andriy-bilynskyy/sdr-trx/calculations/README.md

# Calculations

This folder contains calculations and considerations needed for HW/SW design implementation.
Preferably documents are in LibreOffice format.

## Components
- **band-split.odt** - considerations about splitting HF band into sub-bands in order to filtration harmonics produced by modulation/demodulation process.
- **band-split.ods** - actual calculations  of previous item.
- **power.ods** - simple calculation of main RF variables.
- **swr-meter.ods** - RF Power Detector LTC5507 calculator. Estimate output power using SWR meter (Polynomial calculator Pout=f(Vdet)).
