andriy-bilynskyy/sdr-trx/calculations/band-split.odt

# Band splitting in DCR transceivers.

In DCR transceiver we multiply sound frequencies by carrier frequency. As result we have these sound spectrum near carrier frequency (LSB or USB). But the problem is that really we have a bunch of this frequencies near carrier harmonics (Fc, 2Fc, 3Fc, …) due to non linear modulator/demodulator operations. To suppress that parasitic transmitting/receiving channel we should use band pass filters.

For example we need to cover all shortwave bands 1.8MHz – 30MHz. So the lower carries is 1.8MHz that means that we have second harmonic at 3.6MHz. As result we can’t use just one filter we should use few of them and switch them according to carrier.

### So lets decide the right way to split band. The input data is the next:

FL – Lowest band frequency.

FH – Highest band frequency.

N – Count of sub-bands after split main one(FL … FH).

### Additional considerations

We are going to use the same filters type and order for all sub-bands. That means that each filter has the same bandwidth to center frequency ratio.

A = BW over F

### The calculations

Lets have half bandwidth ratio %alpha = A over 2 = BW over "2 F" which are the same for all filters.

So For the fest band center frequency

F sub L = F sub 1 - %alpha F sub 1 or F sub L = (1 - %alpha) F sub 1
so F sub 1 = F sub L over (1 - %alpha)

Second one

F sub 1 + %alpha F sub 1 = F sub 2 - %alpha F sub 2 or (1 + %alpha) F sub 1 = (1 - %alpha) F sub 2

Third

F sub 1 + %alpha F sub 1 = F sub 2 - %alpha F sub 2 or (1 + %alpha) F sub 1 = (1 - %alpha) F sub 2

Now it’s clear that for some middle X band we have the next

F sub "X-1" + %alpha F sub "X-1" = F sub X - %alpha F sub X or (1 + %alpha) F sub "X-1" = (1 - %alpha) F sub X so F sub X = (1 + %alpha) over (1 - %alpha) F sub "X-1"

And finally the last band

F sub H = F sub N + %alpha F sub N or F sub H = (1 + %alpha) F sub N

Now lets try to estimate half bandwidth ratio. As we said BW = 2 %alpha F

All sub-bands should cover all main band

2 %alpha F sub 1 + 2 %alpha F sub 2 + 2 %alpha F sub 3 + ... + 2 %alpha F sub N = F sub H - F sub L

2 %alpha ( F sub 1 + F sub 2 + F sub 3 +... + F sub N ) = F sub H - F sub L

But we already know how to calculate next frequency from previous . So

2 %alpha ( F sub 1 + F sub 1 ({1 + %alpha} over {1 - %alpha}) + F sub 1 ({1 + %alpha} over {1 - %alpha}) sup 2 + ... + F sub 1 ({1 + %alpha} over {1 - %alpha}) sup {N - 1} ) = F sub H - F sub L

2 %alpha F sub 1 ( 1 + ({1 + %alpha} over {1 - %alpha}) + ({1 + %alpha} over {1 - %alpha}) sup 2 + ... + ({1 + %alpha} over {1 - %alpha}) sup {N - 1} ) = F sub H - F sub L

So we have geometric progression 1 + ({1 + %alpha} over {1 - %alpha}) + ({1 + %alpha} over {1 - %alpha}) sup 2 + ... + ({1 + %alpha} over {1 - %alpha}) sup {N - 1} which equal to

{({1 + %alpha} over {1 - %alpha}) sup N - 1} over {{1 + %alpha} over {1 - %alpha} - 1}

So

2 %alpha F sub 1 left({({1 + %alpha} over {1 - %alpha}) sup N - 1} over {{1 + %alpha} over {1 - %alpha} - 1} right) = F sub H - F sub L

We also already know how to calculate first frequency having main band start. So

2 %alpha {F sub L} over {1 - %alpha} left({({1 + %alpha} over {1 - %alpha}) sup N - 1} over {{1 + %alpha} over {1 - %alpha} - 1} right) = F sub H - F sub L

As result

2 %alpha {F sub L} over {1 - %alpha} left({({1 + %alpha} over {1 - %alpha}) sup N - 1} over {{2 %alpha} over {1 - %alpha}} right) = F sub H - F sub L so {F sub L} left({({1 + %alpha} over {1 - %alpha}) sup N - 1} right) = F sub H - F sub L

and

({1 + %alpha} over {1 - %alpha}) sup N = {F sub H - F sub L} over F sub L + 1 {1 + %alpha} over {1 - %alpha} = nroot{N}{F sub H over F sub L} 1 + %alpha = nroot{N}{F sub H over F sub L} - %alpha nroot{N}{F sub H over F sub L} %alpha (nroot{N}{F sub H over F sub L} + 1)= nroot{N}{F sub H over F sub L} - 1

Finally

%alpha = {nroot{N}{F sub H over F sub L} - 1} over {nroot{N}{F sub H over F sub L} + 1}

Now we can calculate first frequency

F sub 1 = F sub L over (1 - %alpha)

And all another frequencies

F sub X = (1 + %alpha) over (1 - %alpha) F sub "X-1"

And their bandwidths

BW sub x = 2 %alpha F sub x

### Refer to band-split.ods for calculations
