andriy-bilynskyy/sdr-trx/datasheets/BN-43-202.jpg

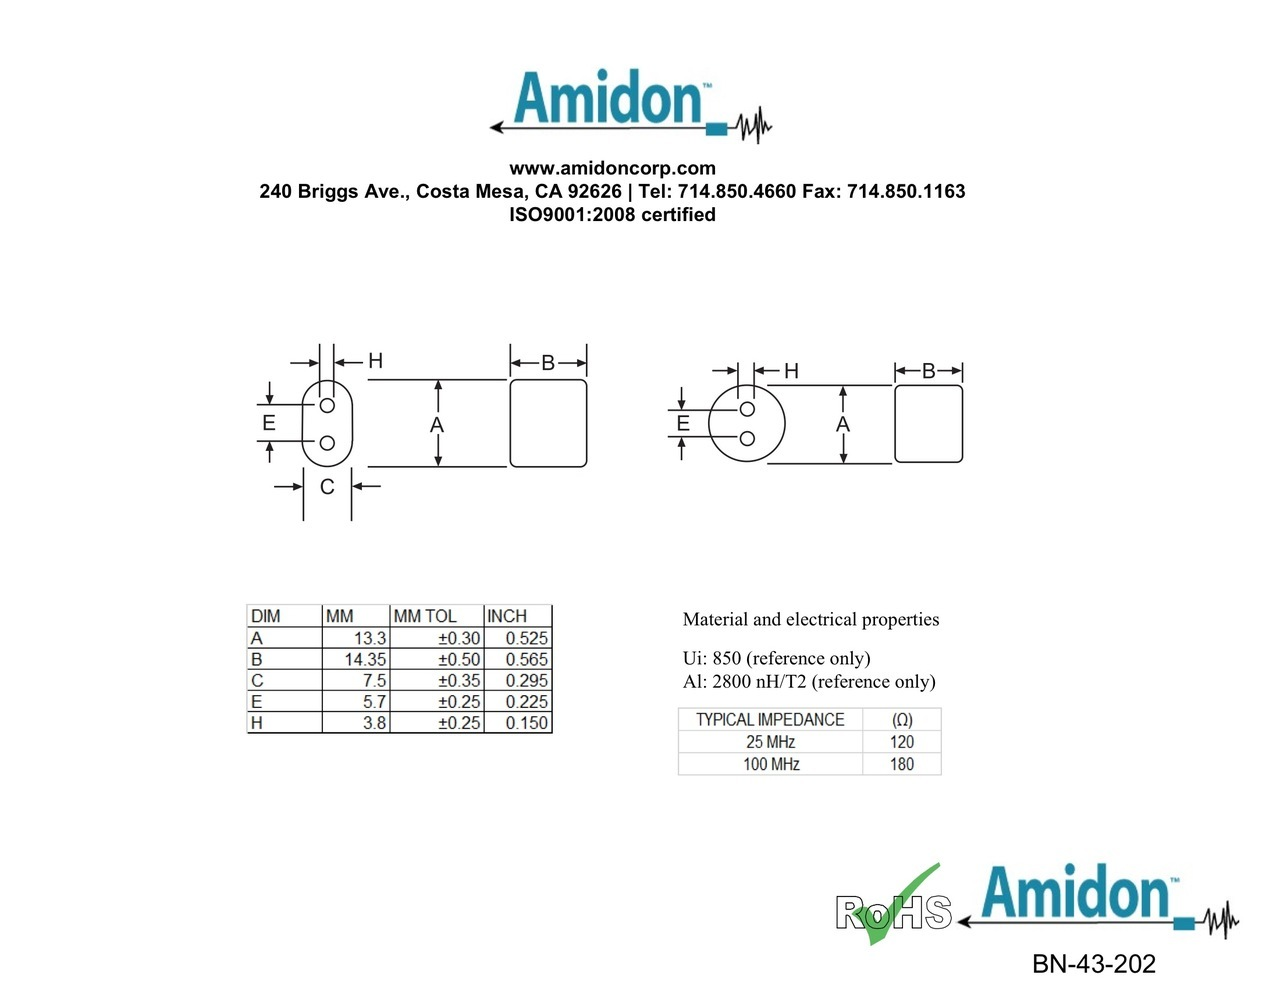
datasheets/BN-43-202.jpg
