andriy-bilynskyy/sdr-trx/simulation/rf-transformer.jpg

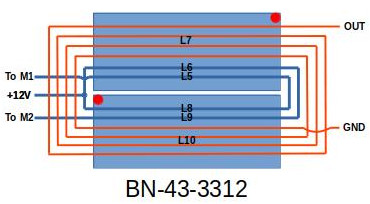
simulation/rf-transformer.jpg
