andriy-bilynskyy/sdr-trx/schematic/doc/dk-order.xlsx

Index | Quantity | Part Number | Manufacturer Part Number | Description | Customer Reference | Available | Backorder | Unit Price | Extended Price USD
1 | 4 | 296-19206-1-ND | SN74CBT3253CDR | IC MUX/DEMUX DUAL 4:1 16SOIC |  | 4 | 0 | 0.58 | 2.32
2 | 1 | LT6237IMS8#PBF-ND | LT6237IMS8#PBF | IC OPAMP GP 2 CIRCUIT 8MSOP |  | 1 | 0 | 5.61 | 5.61
3 | 1 | LT6238CGN#PBF-ND | LT6238CGN#PBF | IC OPAMP GP 4 CIRCUIT 16SSOP |  | 1 | 0 | 8.24 | 8.24
4 | 1 | LTC6655CHMS8-2.5#PBF-ND | LTC6655CHMS8-2.5#PBF | IC VREF SERIES 0.05% 8MSOP |  | 1 | 0 | 8.97 | 8.97
5 | 1 | 296-SN74HC126PWRCT-ND | SN74HC126PWR | IC BUFFER NON-INVERT 6V 14TSSOP |  | 1 | 0 | 0.35 | 0.35
6 | 2 | 296-19213-1-ND | SN74CBT3305CDR | IC SWITCH BUS DUAL FET 8-SOIC |  | 2 | 0 | 0.58 | 1.16
7 | 1 | AD5243BRMZ10-RL7CT-ND | AD5243BRMZ10-RL7 | IC DGTL POT 10KOHM 256TAP 10MSOP |  | 1 | 0 | 2.73 | 2.73
8 | 1 | ULN2003V12T16-13DICT-ND | ULN2003V12T16-13 | IC PWR RELAY N-CHAN 1:1 16TSSOP |  | 1 | 0 | 0.47 | 0.47
9 | 2 | LTC5507ES6#TRMPBFCT-ND | LTC5507ES6#TRMPBF | IC RF DETECT 100KHZ-1GHZ TSOT23 |  | 2 | 0 | 3.8 | 7.60
10 | 1 | TCA0372BDWR2GOSCT-ND | TCA0372BDWR2G | IC OPAMP GP 2 CIRCUIT 16SOIC |  | 1 | 0 | 1.14 | 1.14
11 | 1 | WM8731SEDS/RVCT-ND | WM8731SEDS/RV | IC CODEC PORT INTERNET 28SSOP |  | 1 | 0 | 4.03 | 4.03
12 | 2 | 1727-7297-1-ND | 74HC4066PW,118 | IC SWITCH QUAD 1X2 14TSSOP |  | 2 | 0 | 0.38 | 0.76
13 | 1 | 296-8203-1-ND | SN74HC00PWR | IC GATE NAND 4CH 2-INP 14TSSOP |  | 1 | 0 | 0.4 | 0.40
14 | 1 | 497-17012-ND | STM32F413RHT6 | IC MCU 32BIT 1.5MB FLASH 64LQFP |  | 1 | 0 | 11.58 | 11.58
15 | 1 | 24LC64FT-I/SNCT-ND | 24LC64FT-I/SN | IC EEPROM 64KB I2C 400KHZ 8SOIC |  | 1 | 0 | 0.4 | 0.40
16 | 2 | NUP4202W1T2GOSCT-ND | NUP4202W1T2G | TVS DIODE 5V 14.5V SC88 |  | 2 | 0 | 0.61 | 1.22
17 | 1 | 296-23258-1-ND | SN74HC595PWR | IC 8BIT SHIFT REGISTER 16-TSSOP |  | 1 | 0 | 0.46 | 0.46
18 | 5 | 497-5227-1-ND | LF50ABPT-TR | IC REG LINEAR 5V 500MA PPAK |  | 5 | 0 | 0.69 | 3.45
19 | 3 | 497-10198-1-ND | LF33CPT-TRY | IC REG LINEAR 3.3V 500MA PPAK |  | 3 | 0 | 0.9 | 2.70
20 | 3 | 1662-S-8209ABB-T8T1UCT-ND | S-8209ABB-T8T1U | IC BATT MFUNC LI-ION 8TSSOP |  | 3 | 0 | 1.62 | 4.86
21 | 1 | 296-47259-1-ND | INA300AIDGSR | IC COMPARATOR BIDIR 10VSSOP |  | 1 | 0 | 1.48 | 1.48
22 | 1 | 1662-3255-1-ND | S-812C50AUA-C3ET2U | IC REG LINEAR 5V 75MA SOT89-3 |  | 1 | 0 | 0.93 | 0.93
23 | 1 | NHD-4.3-480272FT-CTXL-CTP-ND | NHD-4.3-480272FT-CTXL-CTP | 4.3" EVE2 TFT STD. MODULE CAP TO |  | 1 | 0 | 76.3 | 76.30
24 | 1 | HM4078-ND | 1598FSGYPBK | BOX ABS BLK/GRAY 9.83"L X 6.27"W |  | 1 | 0 | 12.08 | 12.08
25 | 2 | P16763CT-ND | EVQ-P7A01P | SWITCH TACTILE SPST-NO 0.05A 12V |  | 2 | 0 | 0.3 | 0.60
26 | 2 | 401-1424-ND | BTNK0390 | CAP TACTILE OVAL BLACK |  | 2 | 0 | 0.34 | 0.68
27 | 1 | 102-5644-ND | CMS-15113-078SP | SPEAKER 15 X 11 MM ENCLOSED |  | 1 | 0 | 2.04 | 2.04
28 | 1 | 668-1597-ND | DOM-3027L-HD-R | MIC COND ANALOG OMNI -27DB 8MM D |  | 1 | 0 | 3.09 | 3.09
29 | 7 | 255-1858-1-ND | AGQ200A12Z | RELAY TELECOM DPDT 2A 12VDC |  | 7 | 0 | 1.98 | 13.86
30 | 2 | 317-1593-1-ND | CMFB3435103FNT | THERMISTOR NTC 10KOHM 3435K 0805 |  | 2 | 0 | 0.63 | 1.26
31 | 1 | F9962CT-ND | ASMDC300F/24-2 | PTC RESET FUSE 24V 3A 2SMD |  | 1 | 0 | 0.93 | 0.93
32 | 1 | 36-5019CT-ND | 5019 | PC TEST POINT MINIATURE |  | 1 | 0 | 0.35 | 0.35
33 | 1 | CP-036AHPJCT-ND | PJ-036AH-SMT-TR | CONN PWR JACK 2X5.5MM SOLDER |  | 1 | 0 | 1.39 | 1.39
34 | 1 | CP-3524SJCT-ND | SJ-3524-SMT-TR | CONN JACK STEREO 3.5MM SMD R/A |  | 1 | 0 | 1.04 | 1.04
35 | 1 | CP1-022PJCT-ND | PJ1-022-SMT-TR | CONN PWR JACK 0.7X2.35MM SOLDER |  | 1 | 0 | 1.02 | 1.02
36 | 1 | CP-3524SJGRCT-ND | SJ-3524-SMT-TR-GR | CONN JACK STEREO 3.5MM SMD R/A |  | 1 | 0 | 1.39 | 1.39
37 | 1 | CP-3524SJBECT-ND | SJ-3524-SMT-TR-BE | CONN JACK STEREO 3.5MM SMD R/A |  | 1 | 0 | 1.39 | 1.39
38 | 1 | CP-3524SJPICT-ND | SJ-3524-SMT-TR-PI | CONN JACK STEREO 3.5MM SMD R/A |  | 1 | 0 | 1.39 | 1.39
39 | 1 | CON-SMA-EDGE-S-ND | CON-SMA-EDGE-S | CONN SMA JACK STR EDGE MNT |  | 1 | 0 | 1.7 | 1.70
40 | 1 | SAM15884-ND | TSM-103-02-T-SH | CONN HEADER SMD R/A 3POS 2.54MM |  | 1 | 0 | 0.41 | 0.41
41 | 1 | HR1941CT-ND | DM3D-SF | CONN MICRO SD CARD PUSH-PULL |  | 1 | 0 | 1.81 | 1.81
42 | 1 | WM17141CT-ND | 0473460001 | CONN RCPT USB2.0 MICRO B SMD R/A |  | 1 | 0 | 1.05 | 1.05
43 | 1 | S5680-ND | NPTC102KFMS-RC | CONN HDR 20POS 0.1 TIN SMD |  | 1 | 0 | 2.13 | 2.13
44 | 3 | 36-1042-ND | 1042 | BATTERY HOLDER 18650 SMD TAB |  | 3 | 0 | 2.76 | 8.28
45 | 1 | 535-12040-1-ND | ASTX-H11-27.000MHZ-T | XTAL OSC TCXO 27.0000MHZ HCMOS |  | 1 | 0 | 3.42 | 3.42
46 | 1 | 1908-J49SML-A-G-G-K-24M0CT-ND | J49SML-A-G-G-K-24M0 | CRYSTAL 24MHZ 12PF SMD |  | 1 | 0 | 0.31 | 0.31
47 | 1 | 2195-MS3VT1R32.768KHZ12.5PF20PPMTAQCAUCT-ND | MS3V-T1R-32.768KHZ-12.5PF-20PPM-TA-QC-AU | CRYSTAL 32.768KHZ 12.5PF SMD |  | 1 | 0 | 0.32 | 0.32
48 | 2 | 497-8291-1-ND | PD85004 | FET RF 40V 870MHZ |  | 2 | 0 | 3.23 | 6.46
49 | 12 | 1727-1142-1-ND | BSS138P,215 | MOSFET N-CH 60V 360MA TO-236AB |  | 12 | 0 | 0.184 | 2.21
50 | 3 | SI4909DY-T1-GE3CT-ND | SI4909DY-T1-GE3 | MOSFET 2P-CH 40V 8A 8SO |  | 3 | 0 | 0.99 | 2.97
51 | 3 | 2SB1198KT146QCT-ND | 2SB1198KT146Q | TRANS PNP 80V 0.5A SOT-346 |  | 3 | 0 | 0.45 | 1.35
52 | 3 | 2SC2412KT146RCT-ND | 2SC2412KT146R | TRANS NPN 50V 0.15A SOT-346 |  | 3 | 0 | 0.19 | 0.57
53 | 2 | DMP3099L-7DICT-ND | DMP3099L-7 | MOSFET P-CH 30V SOT23 |  | 2 | 0 | 0.33 | 0.66
54 | 1 | DZT2222ADICT-ND | DZT2222A-13 | TRANS NPN 40V 0.6A SOT-223 |  | 1 | 0 | 0.33 | 0.33
55 | 1 | BCP5216TACT-ND | BCP5216TA | TRANS PNP 60V 1A SOT223 |  | 1 | 0 | 0.37 | 0.37
56 | 1 | 568-BFU520WFCT-ND | BFU520WF | RF TRANS NPN 12V 10GHZ SOT323-3 |  | 1 | 0 | 0.38 | 0.38
57 | 1 | MMBT2222A-FDICT-ND | MMBT2222A-7-F | TRANS NPN 40V 0.6A SMD SOT23-3 |  | 1 | 0 | 0.13 | 0.13
58 | 1 | 1727-5192-1-ND | PMEG2010ER,115 | DIODE SCHOTTKY 20V 1A SOD123W |  | 1 | 0 | 0.42 | 0.42
59 | 1 | BAT54WT1GOSCT-ND | BAT54WT1G | DIODE SCHOTTKY 30V 200MA SC70-3 |  | 1 | 0 | 0.2 | 0.20
60 | 1 | BAT54AWT1GOSCT-ND | BAT54AWT1G | DIODE ARRAY SCHOTTKY 30V SOT323 |  | 1 | 0 | 0.23 | 0.23
61 | 1 | 1727-4249-1-ND | BZX84-C2V4,215 | DIODE ZENER 2.4V 250MW SOT23 |  | 1 | 0 | 0.13 | 0.13
62 | 1 | 1727-2938-1-ND | BZX84-C4V7,215 | DIODE ZENER 4.7V 250MW SOT23 |  | 1 | 0 | 0.13 | 0.13
63 | 2 | 1727-2126-1-ND | BZX84-C12,235 | DIODE ZENER 12V 250MW SOT23 |  | 2 | 0 | 0.13 | 0.26
64 | 1 | 732-4984-1-ND | 150080RS75000 | LED RED CLEAR 0805 SMD |  | 1 | 0 | 0.18 | 0.18
65 | 1 | 445-8983-1-ND | MLF2012DR10MT000 | FIXED IND 100NH 300MA 150 MOHM |  | 1 | 0 | 0.18 | 0.18
66 | 2 | 445-8985-1-ND | MLF2012DR15M | FIXED IND 150NH 300MA 200 MOHM |  | 2 | 0 | 0.18 | 0.36
67 | 1 | 445-8986-1-ND | MLF2012DR18M | FIXED IND 180NH 300MA 250 MOHM |  | 1 | 0 | 0.18 | 0.18
68 | 1 | 445-1039-1-ND | MLF2012DR22KT000 | FIXED IND 220NH 250MA 300 MOHM |  | 1 | 0 | 0.2 | 0.20
69 | 2 | 445-8988-1-ND | MLF2012DR27MT000 | FIXED IND 270NH 250MA 350 MOHM |  | 2 | 0 | 0.18 | 0.36
70 | 1 | 445-8989-1-ND | MLF2012DR33M | FIXED IND 330NH 250MA 400 MOHM |  | 1 | 0 | 0.18 | 0.18
71 | 2 | 445-8991-1-ND | MLF2012DR47M | FIXED IND 470NH 200MA 500 MOHM |  | 2 | 0 | 0.18 | 0.36
72 | 1 | 445-1044-1-ND | MLF2012DR56KT000 | FIXED IND 560NH 150MA 550 MOHM |  | 1 | 0 | 0.2 | 0.20
73 | 4 | 445-1046-1-ND | MLF2012DR82KT000 | FIXED IND 820NH 150MA 650 MOHM |  | 4 | 0 | 0.2 | 0.80
74 | 3 | 445-1047-1-ND | MLF2012A1R0KT000 | FIXED IND 1UH 80MA 300 MOHM SMD |  | 3 | 0 | 0.2 | 0.60
75 | 4 | 445-8968-1-ND | MLF2012A1R5M | FIXED IND 1.5UH 80MA 400 MOHM |  | 4 | 0 | 0.18 | 0.72
76 | 2 | 445-1051-1-ND | MLF2012A2R2KT000 | FIXED IND 2.2UH 50MA 500 MOHM |  | 2 | 0 | 0.2 | 0.40
77 | 2 | 445-1054-1-ND | MLF2012A3R9KT000 | FIXED IND 3.9UH 30MA 650 MOHM |  | 2 | 0 | 0.2 | 0.40
78 | 2 | 445-1057-1-ND | MLF2012E6R8KT000 | FIXED IND 6.8UH 15MA 650 MOHM |  | 2 | 0 | 0.2 | 0.40
79 | 6 | 445-181376-1-ND | MLZ2012N101LTD25 | FIXED IND 100UH 140MA 4.55 OHM |  | 6 | 0 | 0.18 | 1.08
80 | 3 | 490-18067-1-ND | LQW32FT470M0HL | FIXED IND 47UH 100MA 900MOHM SMD |  | 3 | 0 | 1.35 | 4.05
81 | 2 | 732-1824-1-ND | 744762222A | FIXED IND 220NH 800MA 450 MOHM |  | 2 | 0 | 0.44 | 0.88
82 | 3 | 732-1826-1-ND | 744762233A | FIXED IND 330NH 500MA 900 MOHM |  | 3 | 0 | 0.44 | 1.32
83 | 2 | 490-5700-1-ND | LQW2UASR56J00L | FIXED IND 560NH 400MA 1.33 OHM |  | 2 | 0 | 0.25 | 0.50
84 | 1 | 490-5702-1-ND | LQW2UASR68J00L | FIXED IND 680NH 400MA 1.47 OHM |  | 1 | 0 | 0.25 | 0.25
85 | 2 | 732-3469-1-ND | 744758310A | FIXED IND 1UH 370MA 1.7 OHM SMD |  | 2 | 0 | 0.44 | 0.88
86 | 1 | 732-3470-1-ND | 744758312A | FIXED IND 1.2UH 760MA 500 MOHM |  | 1 | 0 | 0.44 | 0.44
87 | 1 | 732-3471-1-ND | 744758315A | FIXED IND 1.5UH 630MA 750 MOHM |  | 1 | 0 | 0.44 | 0.44
88 | 2 | 732-3472-1-ND | 744758318A | FIXED IND 1.8UH 630MA 750 MOHM |  | 2 | 0 | 0.44 | 0.88
89 | 1 | 732-3474-1-ND | 744758327A | FIXED IND 2.7UH 520MA 1.1 OHM |  | 1 | 0 | 0.44 | 0.44
90 | 3 | 553-3189-ND | CX2047LANL | BALUN 500KHZ-300MHZ 1:4 5SMD MOD |  | 3 | 0 | 2.46 | 7.38
91 | 10 | 311-0.0CRCT-ND | RC0805FR-070RL | RES SMD 0 OHM JUMPER 1/8W 0805 |  | 10 | 0 | 0.035 | 0.35
92 | 1 | 311-0.02LWCT-ND | RL1206FR-070R02L | RES 0.02 OHM 1% 1/4W 1206 |  | 1 | 0 | 0.51 | 0.51
93 | 10 | RNCP0805FTD4R70CT-ND | RNCP0805FTD4R70 | RES 4.7 OHM 1% 1/4W 0805 |  | 10 | 0 | 0.069 | 0.69
94 | 10 | 311-10.0CRCT-ND | RC0805FR-0710RL | RES SMD 10 OHM 1% 1/8W 0805 |  | 10 | 0 | 0.069 | 0.69
95 | 10 | RNCP1206FTD15R0CT-ND | RNCP1206FTD15R0 | RES 15 OHM 1% 1/2W 1206 |  | 10 | 0 | 0.089 | 0.89
96 | 10 | A129728CT-ND | CRGCQ0805F18R | CRGCQ 0805 18R 1% |  | 10 | 0 | 0.047 | 0.47
97 | 10 | A126352CT-ND | CRG0805F22R | RES SMD 22 OHM 1% 1/8W 0805 |  | 10 | 0 | 0.047 | 0.47
98 | 10 | A126371CT-ND | CRG0805F47R | RES SMD 47 OHM 1% 1/8W 0805 |  | 10 | 0 | 0.047 | 0.47
99 | 10 | A126374CT-ND | CRG0805F51R | RES SMD 51 OHM 1% 1/8W 0805 |  | 10 | 0 | 0.047 | 0.47
100 | 10 | 311-68.0CRCT-ND | RC0805FR-0768RL | RES SMD 68 OHM 1% 1/8W 0805 |  | 10 | 0 | 0.039 | 0.39
101 | 10 | RNCP1206FTD75R0CT-ND | RNCP1206FTD75R0 | RES 75 OHM 1% 1/2W 1206 |  | 10 | 0 | 0.093 | 0.93
102 | 20 | 311-100CRCT-ND | RC0805FR-07100RL | RES SMD 100 OHM 1% 1/8W 0805 |  | 20 | 0 | 0.039 | 0.78
103 | 10 | RNCP1206FTD100RCT-ND | RNCP1206FTD100R | RES 100 OHM 1% 1/2W 1206 |  | 10 | 0 | 0.089 | 0.89
104 | 10 | RNCP0805FTD150RCT-ND | RNCP0805FTD150R | RES 150 OHM 1% 1/4W 0805 |  | 10 | 0 | 0.072 | 0.72
105 | 10 | 311-160CRCT-ND | RC0805FR-07160RL | RES SMD 160 OHM 1% 1/8W 0805 |  | 10 | 0 | 0.039 | 0.39
106 | 10 | A126343CT-ND | CRG0805F180R | RES SMD 180 OHM 1% 1/8W 0805 |  | 10 | 0 | 0.047 | 0.47
107 | 10 | RMCF0805FT390RCT-ND | RMCF0805FT390R | RES 390 OHM 1% 1/8W 0805 |  | 10 | 0 | 0.025 | 0.25
108 | 10 | A129745CT-ND | CRGCQ0805F470R | CRGCQ 0805 470R 1% |  | 10 | 0 | 0.047 | 0.47
109 | 10 | RMCF0805FT820RCT-ND | RMCF0805FT820R | RES 820 OHM 1% 1/8W 0805 |  | 10 | 0 | 0.025 | 0.25
110 | 30 | 311-1.00KCRCT-ND | RC0805FR-071KL | RES SMD 1K OHM 1% 1/8W 0805 |  | 30 | 0 | 0.039 | 1.17
111 | 10 | A129752CT-ND | CRGCQ0805F1K8 | CRGCQ 0805 1K8 1% |  | 10 | 0 | 0.047 | 0.47
112 | 10 | 311-2.20KCRCT-ND | RC0805FR-072K2L | RES SMD 2.2K OHM 1% 1/8W 0805 |  | 10 | 0 | 0.039 | 0.39
113 | 10 | A126368CT-ND | CRG0805F3K0 | RES SMD 3K OHM 1% 1/8W 0805 |  | 10 | 0 | 0.047 | 0.47
114 | 20 | 311-4.30KCRCT-ND | RC0805FR-074K3L | RES SMD 4.3K OHM 1% 1/8W 0805 |  | 20 | 0 | 0.039 | 0.78
115 | 10 | A126384CT-ND | CRG0805F6K8 | RES SMD 6.8K OHM 1% 1/8W 0805 |  | 10 | 0 | 0.047 | 0.47
116 | 10 | A126389CT-ND | CRG0805F8K2 | RES SMD 8.2K OHM 1% 1/8W 0805 |  | 10 | 0 | 0.047 | 0.47
117 | 100 | 311-10.0KCRCT-ND | RC0805FR-0710KL | RES SMD 10K OHM 1% 1/8W 0805 |  | 100 | 0 | 0.0157 | 1.57
118 | 10 | A129763CT-ND | CRGCQ0805F15K | CRGCQ 0805 15K 1% |  | 10 | 0 | 0.047 | 0.47
119 | 10 | RMCF0805FT36K0CT-ND | RMCF0805FT36K0 | RES 36K OHM 1% 1/8W 0805 |  | 10 | 0 | 0.025 | 0.25
120 | 20 | 311-47.0KCRCT-ND | RC0805FR-0747KL | RES SMD 47K OHM 1% 1/8W 0805 |  | 20 | 0 | 0.039 | 0.78
121 | 10 | A126382CT-ND | CRG0805F68K | RES SMD 68K OHM 1% 1/8W 0805 |  | 10 | 0 | 0.047 | 0.47
122 | 10 | 311-510KCRCT-ND | RC0805FR-07510KL | RES SMD 510K OHM 1% 1/8W 0805 |  | 10 | 0 | 0.039 | 0.39
123 | 10 | 311-1.00MCRCT-ND | RC0805FR-071ML | RES SMD 1M OHM 1% 1/8W 0805 |  | 10 | 0 | 0.039 | 0.39
124 | 10 | 311-4.70MCRCT-ND | RC0805FR-074M7L | RES SMD 4.7M OHM 1% 1/8W 0805 |  | 10 | 0 | 0.039 | 0.39
125 | 10 | 1276-1107-1-ND | CL21C180JBANNNC | CAP CER 18PF 50V C0G/NP0 0805 |  | 10 | 0 | 0.058 | 0.58
126 | 10 | 399-1113-1-ND | C0805C220J5GACTU | CAP CER 22PF 50V C0G/NP0 0805 |  | 10 | 0 | 0.067 | 0.67
127 | 10 | 1276-1769-1-ND | CL21C390JBANNNC | CAP CER 39PF 50V C0G/NP0 0805 |  | 10 | 0 | 0.053 | 0.53
128 | 10 | 311-4241-1-ND | CC0805JRNPO9BN620 | CAP CER 62PF 50V NPO 0805 |  | 10 | 0 | 0.114 | 1.14
129 | 10 | 732-12227-1-ND | 885012007081 | CAP CER 68PF 100V C0G/NP0 0805 |  | 10 | 0 | 0.062 | 0.62
130 | 10 | 311-4244-1-ND | CC0805JRNPO9BN910 | CAP CER 91PF 50V NPO 0805 |  | 10 | 0 | 0.114 | 1.14
131 | 10 | 399-15438-1-ND | C0805C111J5GAC7800 | CAP CER 110PF 50V NP0 0805 |  | 10 | 0 | 0.226 | 2.26
132 | 10 | 399-1124-1-ND | C0805C121J5GACTU | CAP CER 120PF 50V C0G/NP0 0805 |  | 10 | 0 | 0.088 | 0.88
133 | 10 | 399-15445-1-ND | C0805C131J1GAC7800 | CAP CER 130PF 100V NP0 0805 |  | 10 | 0 | 0.237 | 2.37
134 | 10 | 399-1125-1-ND | C0805C151J5GACTU | CAP CER 150PF 50V C0G/NP0 0805 |  | 10 | 0 | 0.075 | 0.75
135 | 10 | 399-15456-1-ND | C0805C161J1GAC7800 | CAP CER 160PF 100V NP0 0805 |  | 10 | 0 | 0.237 | 2.37
136 | 10 | 1276-1129-1-ND | CL21C181JBANNNC | CAP CER 180PF 50V C0G/NP0 0805 |  | 10 | 0 | 0.073 | 0.73
137 | 10 | 311-4327-1-ND | CC0805KRX7R9BB201 | CAP CER 200PF 50V X7R 0805 |  | 10 | 0 | 0.117 | 1.17
138 | 10 | 399-8039-1-ND | C0805C221M5RACTU | CAP CER 220PF 50V X7R 0805 |  | 10 | 0 | 0.071 | 0.71
139 | 10 | 311-4232-1-ND | CC0805JRNPO9BN241 | CAP CER 240PF 50V NPO 0805 |  | 10 | 0 | 0.151 | 1.51
140 | 10 | 399-1129-1-ND | C0805C271J5GACTU | CAP CER 270PF 50V C0G/NP0 0805 |  | 10 | 0 | 0.095 | 0.95
141 | 10 | 738-CML0805C0G301JT50VCT-ND | CML0805C0G301JT50V | CAP CER 300PF 50V C0G/NP0 0805 |  | 10 | 0 | 0.101 | 1.01
142 | 10 | 1276-1189-1-ND | CL21C331JBANNNC | CAP CER 330PF 50V C0G/NP0 0805 |  | 10 | 0 | 0.05 | 0.50
143 | 10 | 399-9230-1-ND | C0805C361J5GACTU | CAP CER 360PF 50V C0G/NP0 0805 |  | 0 | 10 | 0.236 | 2.36
144 | 10 | 311-4238-1-ND | CC0805JRNPO9BN431 | CAP CER 430PF 50V NPO 0805 |  | 10 | 0 | 0.151 | 1.51
145 | 10 | 399-16590-1-ND | C0805C511J5HACAUTO | CAP CER 0805 510PF 50V ULTRA STA |  | 10 | 0 | 0.127 | 1.27
146 | 10 | 1276-1798-1-ND | CL21B561KBANNNC | CAP CER 560PF 50V X7R 0805 |  | 10 | 0 | 0.059 | 0.59
147 | 10 | 311-4242-1-ND | CC0805JRNPO9BN621 | CAP CER 620PF 50V NPO 0805 |  | 10 | 0 | 0.151 | 1.51
148 | 10 | 478-10542-1-ND | 08055A751JAT2A | CAP CER 750PF 50V NP0 0805 |  | 10 | 0 | 0.254 | 2.54
149 | 10 | 478-12759-1-ND | 08051C911KAT2A | CAP CER 910PF 100V X7R 0805 |  | 10 | 0 | 0.191 | 1.91
150 | 20 | 311-1127-1-ND | CC0805KRX7R9BB102 | CAP CER 1000PF 50V X7R 0805 |  | 20 | 0 | 0.074 | 1.48
151 | 10 | 490-8290-1-ND | GRM2165C2A132JA01D | CAP CER 1300PF 100V C0G/NP0 0805 |  | 10 | 0 | 0.152 | 1.52
152 | 10 | 1276-1794-1-ND | CL21B152KBANNNC | CAP CER 1500PF 50V X7R 0805 |  | 10 | 0 | 0.048 | 0.48
153 | 10 | 490-12745-1-ND | GRM2165C2A162JA01D | CAP CER 1600PF 100V C0G/NP0 0805 |  | 10 | 0 | 0.152 | 1.52
154 | 10 | 1276-2465-1-ND | CL21B182KBANNNC | CAP CER 1800PF 50V X7R 0805 |  | 10 | 0 | 0.063 | 0.63
155 | 10 | 1276-2495-1-ND | CL21B272KBANNNC | CAP CER 2700PF 50V X7R 0805 |  | 10 | 0 | 0.06 | 0.60
156 | 10 | 490-1631-1-ND | GRM2165C1H302JA01D | CAP CER 3000PF 50V C0G/NP0 0805 |  | 10 | 0 | 0.184 | 1.84
157 | 10 | 399-1153-1-ND | C0805C332K5RACTU | CAP CER 3300PF 50V X7R 0805 |  | 10 | 0 | 0.071 | 0.71
158 | 10 | 399-1155-1-ND | C0805C472K5RACTU | CAP CER 4700PF 50V X7R 0805 |  | 10 | 0 | 0.065 | 0.65
159 | 10 | 490-12609-1-ND | GRM2195C1H822FA01D | CAP CER 8200PF 50V C0G/NP0 0805 |  | 10 | 0 | 0.399 | 3.99
160 | 50 | 399-17617-1-ND | C0805C103K1RAC7210 | CAP CER SMD 0805 .01UF 100V X7R |  | 50 | 0 | 0.0356 | 1.78
161 | 200 | 399-1177-1-ND | C0805C104Z5VACTU | CAP CER 0.1UF 50V Y5V 0805 |  | 200 | 0 | 0.0243 | 4.86
162 | 50 | 1276-1244-1-ND | CL21A475KAQNNNE | CAP CER 4.7UF 25V X5R 0805 |  | 50 | 0 | 0.053 | 2.65
163 | 3 | 493-2130-1-ND | UWX1H010MCL1GB | CAP ALUM 1UF 20% 50V SMD |  | 3 | 0 | 0.28 | 0.84
164 | 5 | PCE4153CT-ND | EEE-HB1V100R | CAP ALUM 10UF 20% 35V SMD |  | 5 | 0 | 0.33 | 1.65
165 | 2 | 493-3917-6-ND | UCL1C470MCL1GS | CAP ALUM 47UF 20% 16V SMD |  | 2 | 0 | 4.07 | 8.14
166 | 4 | 493-6216-1-ND | UUR1C331MNL1GS | CAP ALUM 330UF 20% 16V SMD |  | 4 | 0 | 0.53 | 2.12
167 | 50 | 1276-6471-1-ND | CL21B105KOFNNNG | CAP CER 1UF 16V X7R 0805 |  | 50 | 0 | 0.033 | 1.65
168 | 1 | 336-3908-1-ND | SI5351A-B-GTR | IC CLK GENERATOR 200MHZ 10MSOP |  | 1 | 0 | 0.92 | 0.92
169 | 1 | AD8604ARZ-REELCT-ND | AD8604ARZ-REEL | IC OPAMP GP 4 CIRCUIT 14SOIC |  | 1 | 0 | 3.07 | 3.07
170 | 1 | AD8618ARZ-REEL7CT-ND | AD8618ARZ-REEL7 | IC OPAMP GP 4 CIRCUIT 14SOIC |  | 1 | 0 | 6.41 | 6.41
