andriy-bilynskyy/sdr-trx/tests/Photos/Assembled_2.JPG

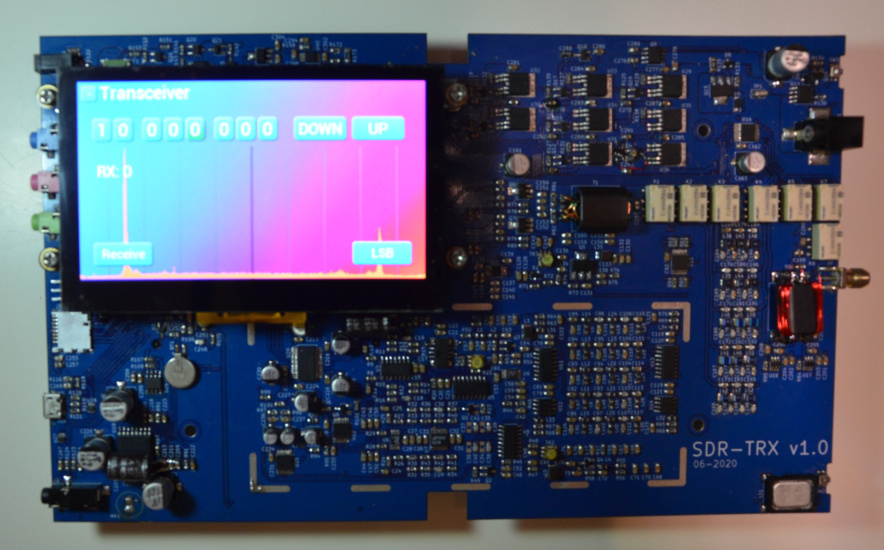
tests/Photos/Assembled_2.JPG
