andriy-bilynskyy/sdr-trx/tests/Photos/Assembled_3.JPG

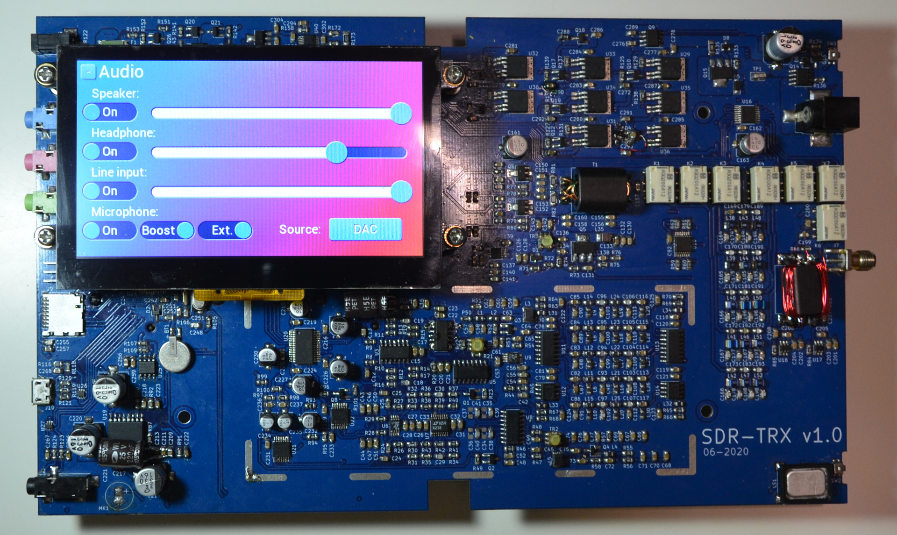
tests/Photos/Assembled_3.JPG
