andriy-bilynskyy/sdr-trx/tests/Photos/Assembled_4.JPG

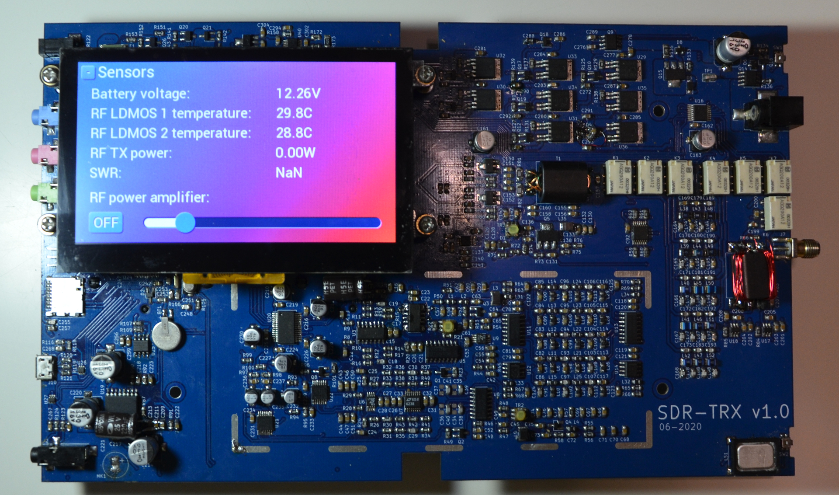
tests/Photos/Assembled_4.JPG
