andriy-bilynskyy/sdr-trx/tests/Photos/Assembled_5.JPG

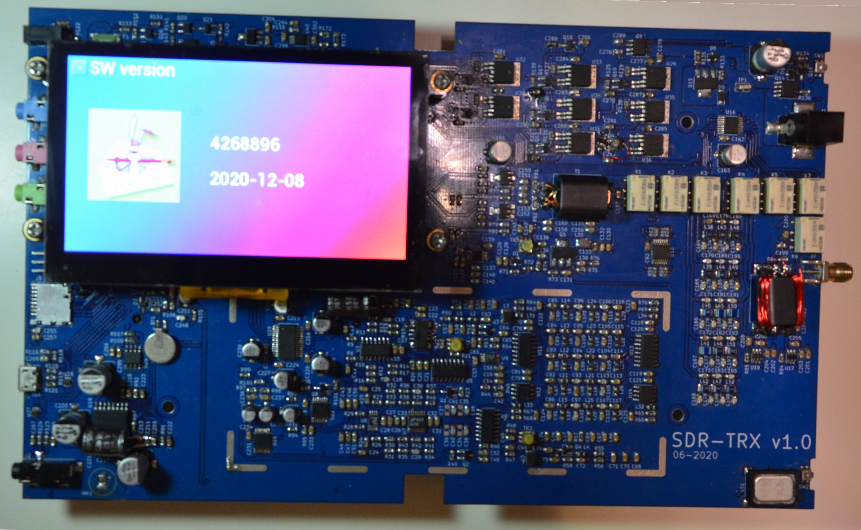
tests/Photos/Assembled_5.JPG
