andriy-bilynskyy/sdr-trx/tests/Photos/PCBv1.0-bot.JPG

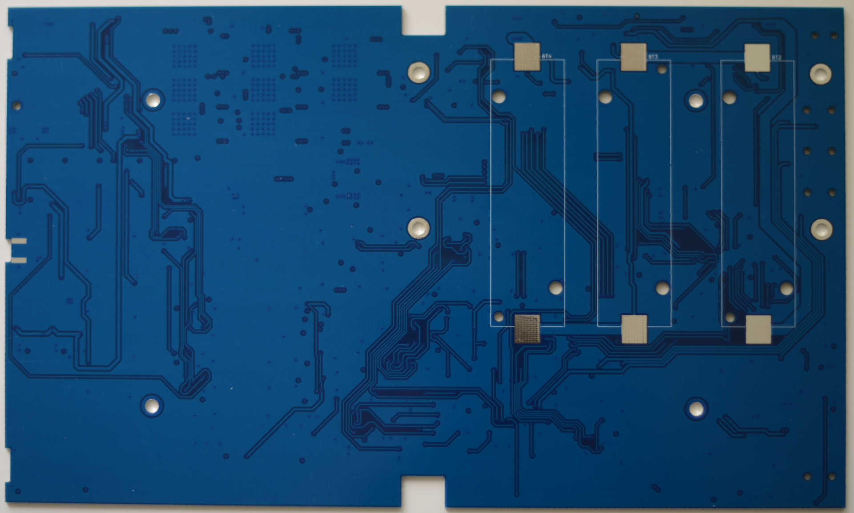
tests/Photos/PCBv1.0-bot.JPG
