andriy-bilynskyy/sdr-trx/tests/Photos/PCBv1.0-parcel.JPG

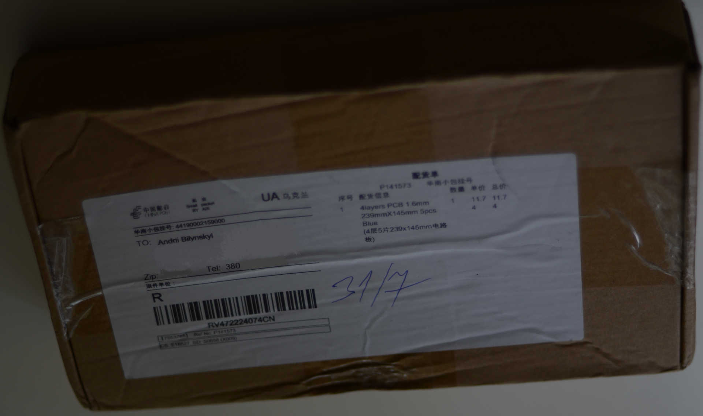
tests/Photos/PCBv1.0-parcel.JPG
