andriy-bilynskyy/sdr-trx/tests/Photos/PCBv1.0-set.JPG

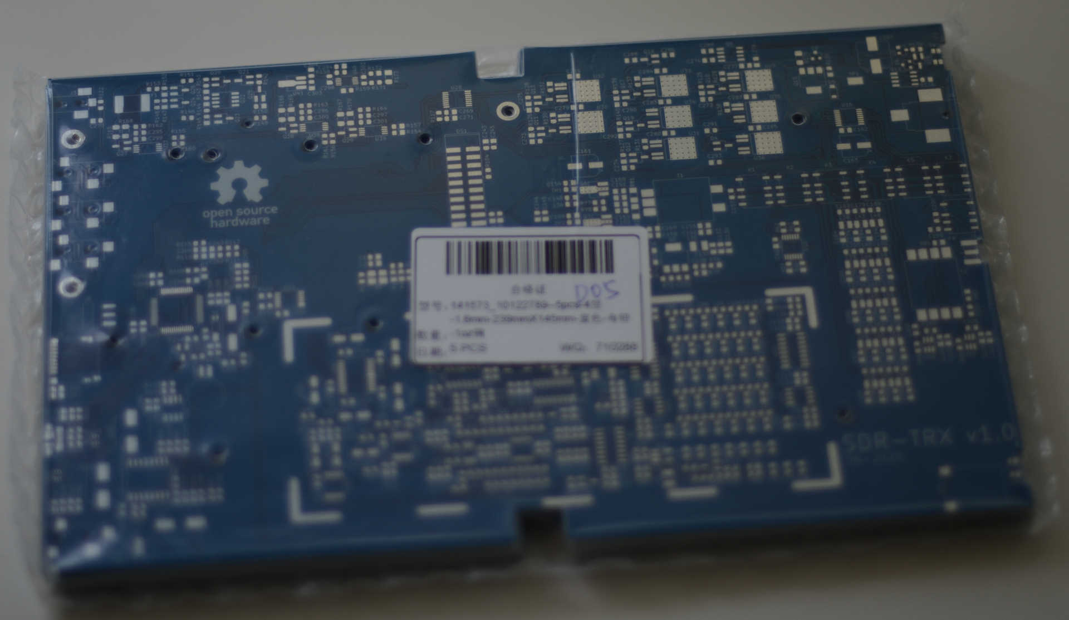
tests/Photos/PCBv1.0-set.JPG
