andriy-bilynskyy/sdr-trx/tests/Photos/PCBv1.0-top.JPG

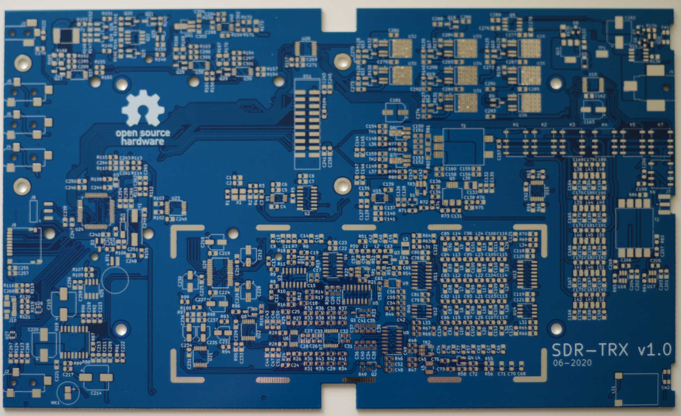
tests/Photos/PCBv1.0-top.JPG
