andriy-bilynskyy/sdr-trx/schematic/doc/schematic.pdf

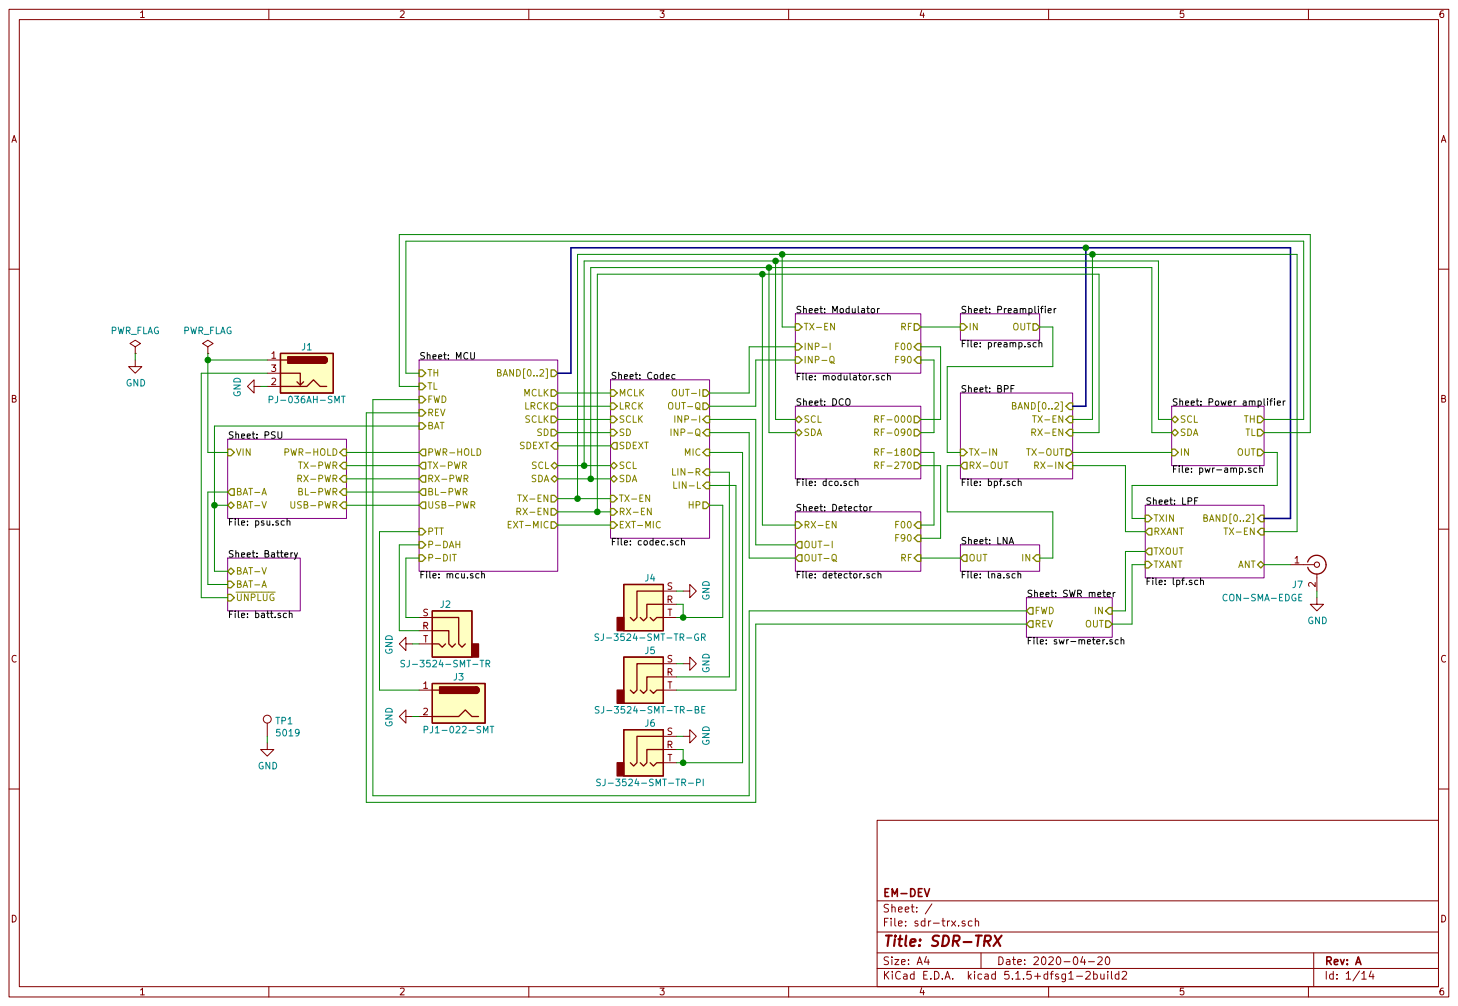
[picture p17: page 1]

Sheet: Modulator File: modulator.sch TX-EN
INP-Q
OUT-I Sheet: DCO

RF Sheet: Codec File: codec.sch MCLK
SCL BAND[0..2] SD
SCLK MCLK
LRCK
P-DIT PWR-HOLD
TX-PWR
BL-PWR

J2 SJ-3524-SMT-TR GND

File: bpf.sch RX-OUT

File: pwr-amp.sch

Sheet: LPF
File: lpf.sch TXIN

Sheet: Battery File: batt.sch BAT-V UNPLUG

J7 2 CON-SMA-EDGE GND

J4 SJ-3524-SMT-TR-GR GND

Sheet: SWR meter File: swr-meter.sch
FWD
REV

J5 SJ-3524-SMT-TR-BE

File: sdr-trx.sch Sheet: / EM-DEV

Id: 1/14 Title: SDR-TRX

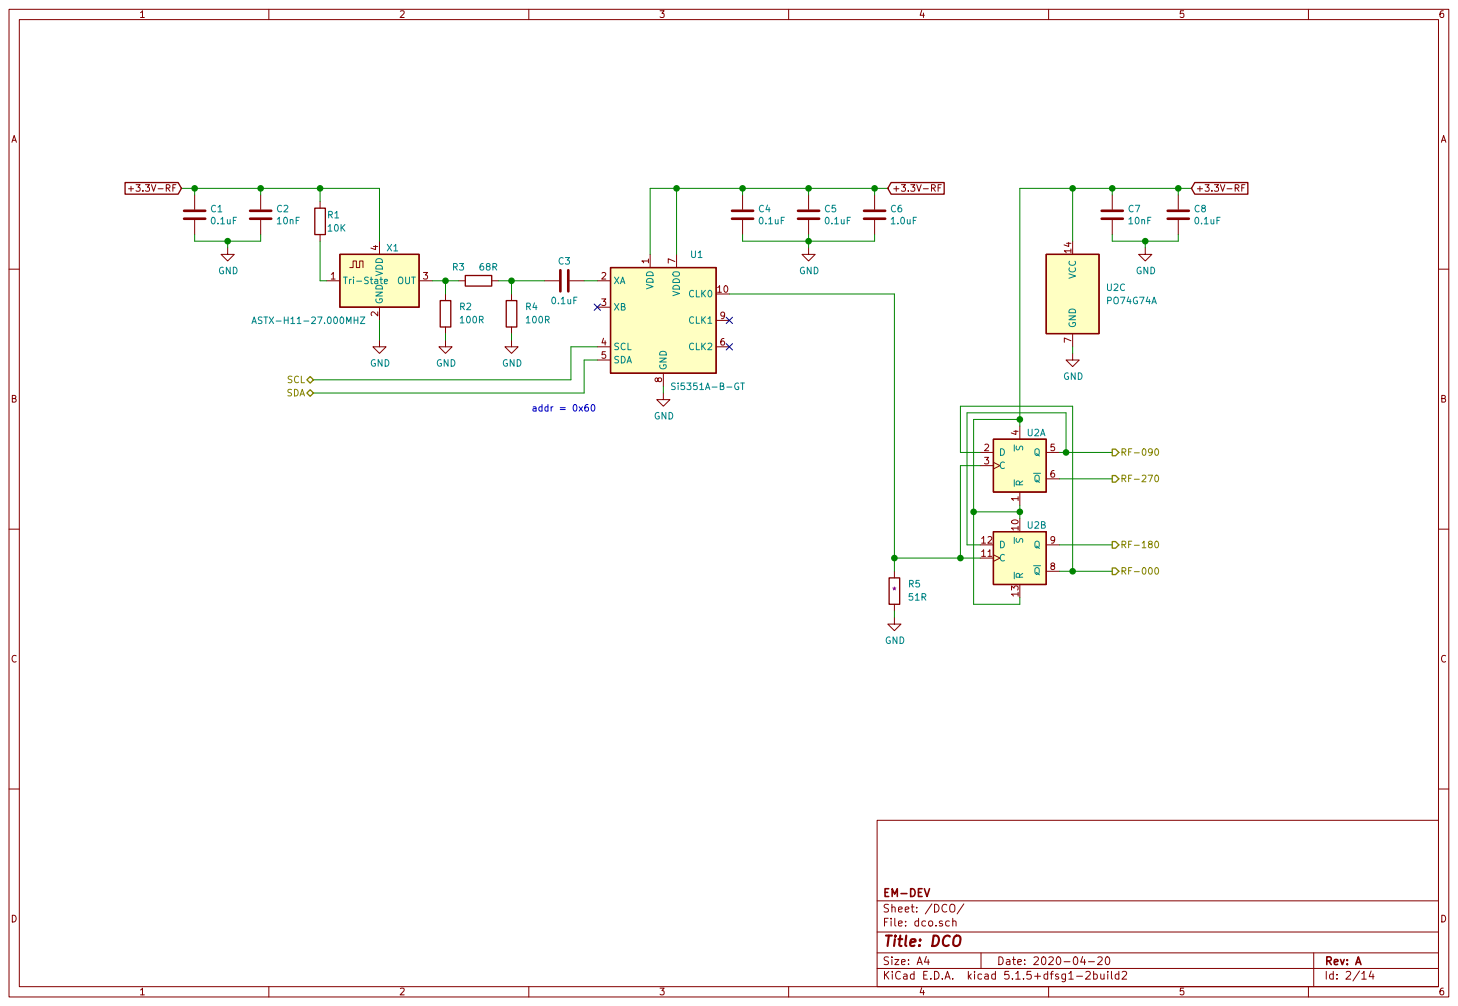
[picture p18: page 2]

1 CLK0 10 XA 2 XB 3 SCL 4 SDA 5 CLK2 6 VDDO

File: dco.sch Sheet: /DCO/ EM-DEV

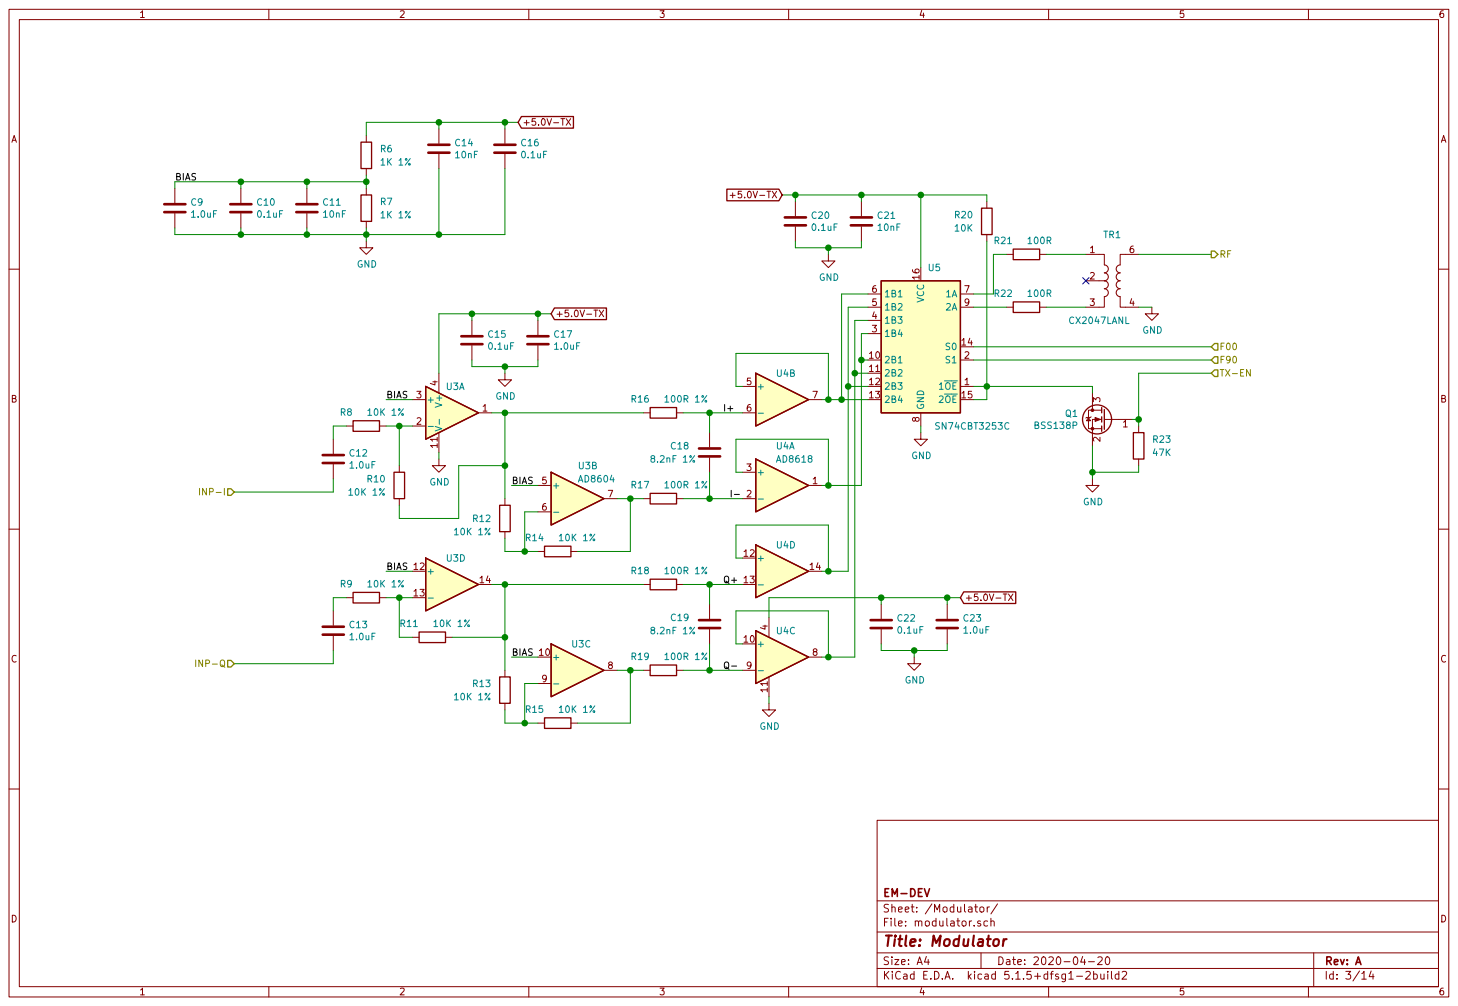
[picture p19: page 3]

Id: 3/14 Title: Modulator File: modulator.sch Sheet: /Modulator/ EM-DEV

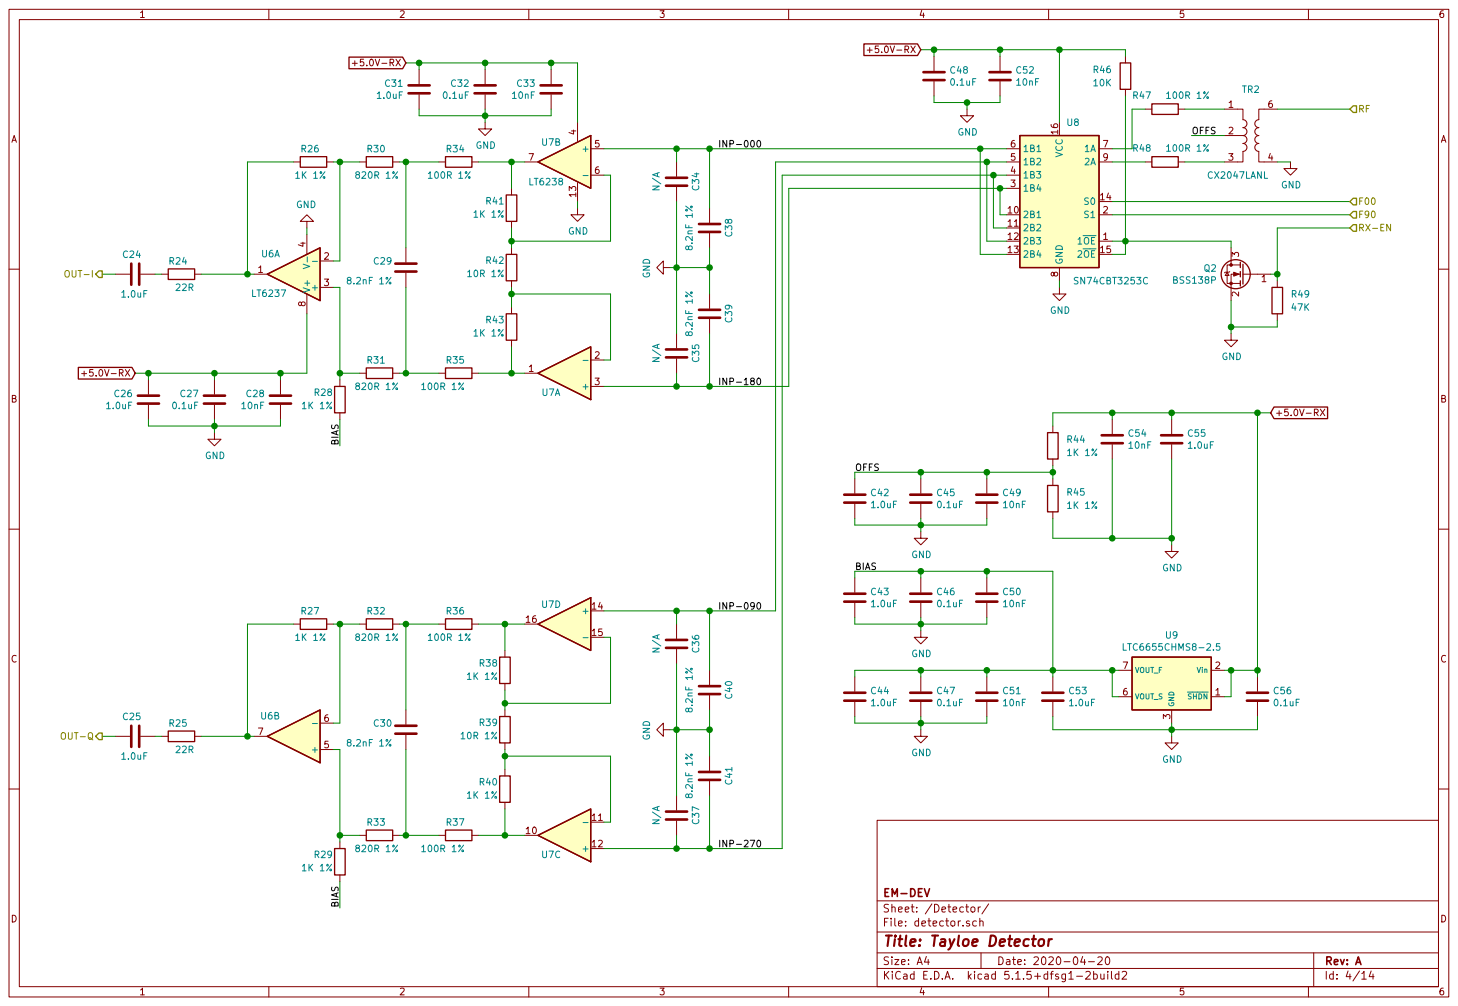
[picture p20: page 4]

Id: 4/14 Title: Tayloe Detector File: detector.sch Sheet: /Detector/ EM-DEV

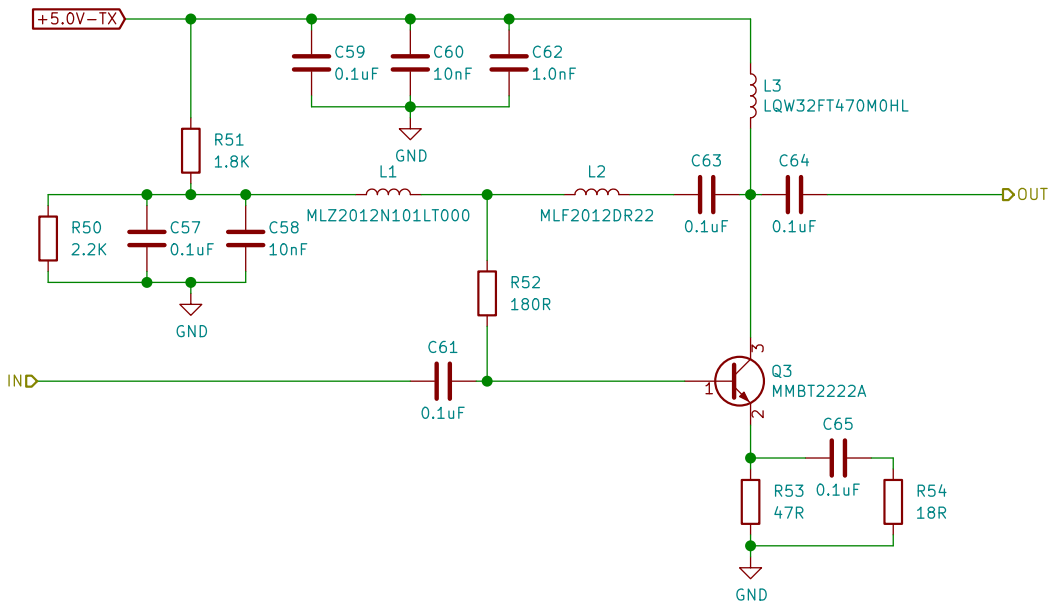
[picture p21: page 5]

Sheet: /Preamplifier/ EM-DEV

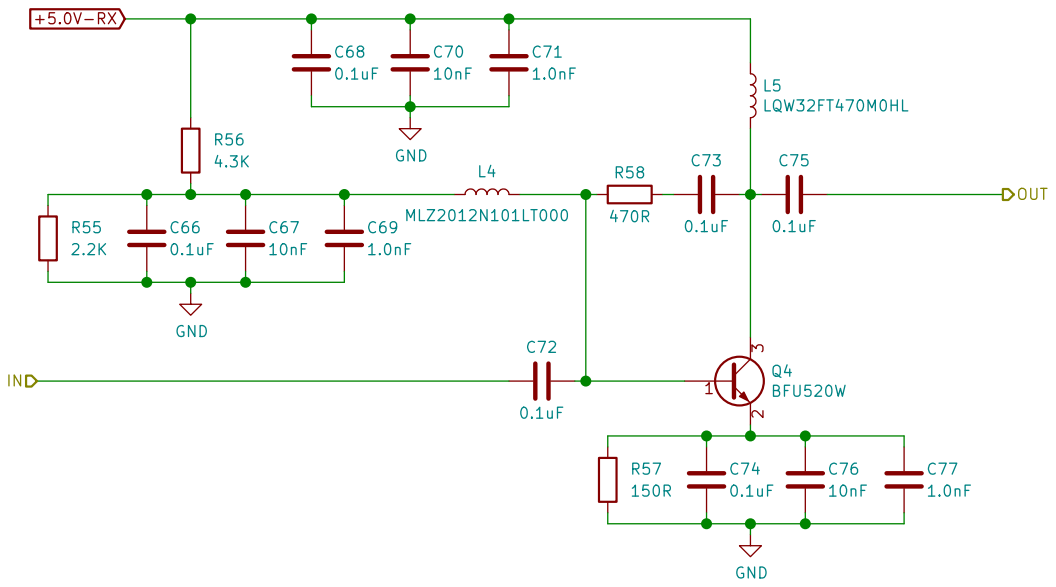
[picture p22: page 6]

File: lna.sch Sheet: /LNA/ EM-DEV

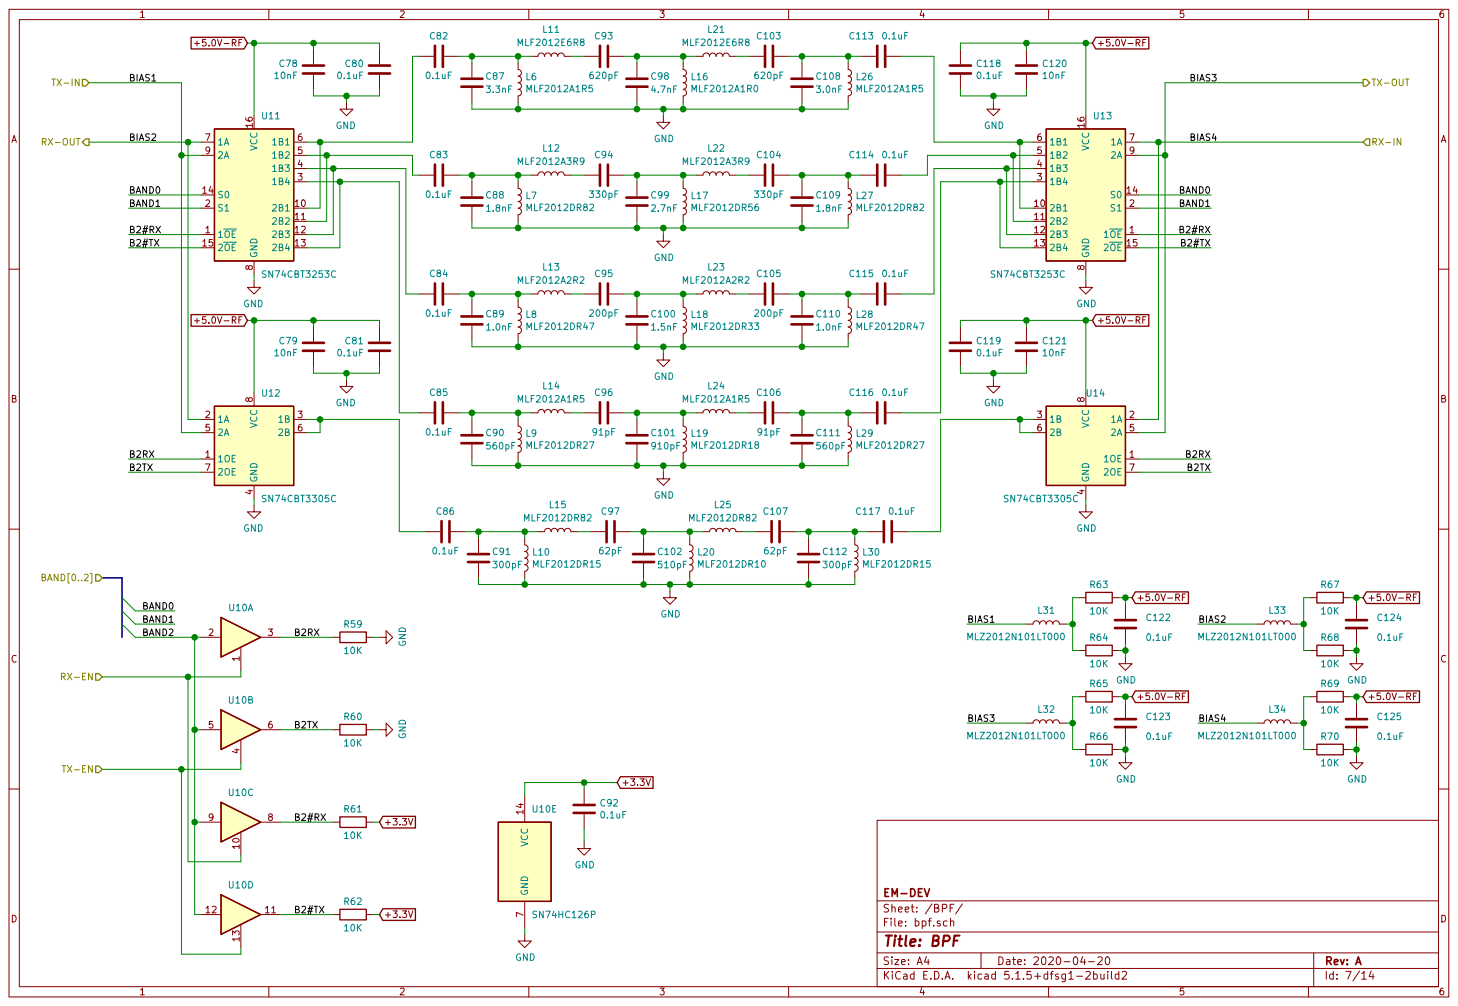
[picture p23: page 7]

File: bpf.sch Sheet: /BPF/ EM-DEV

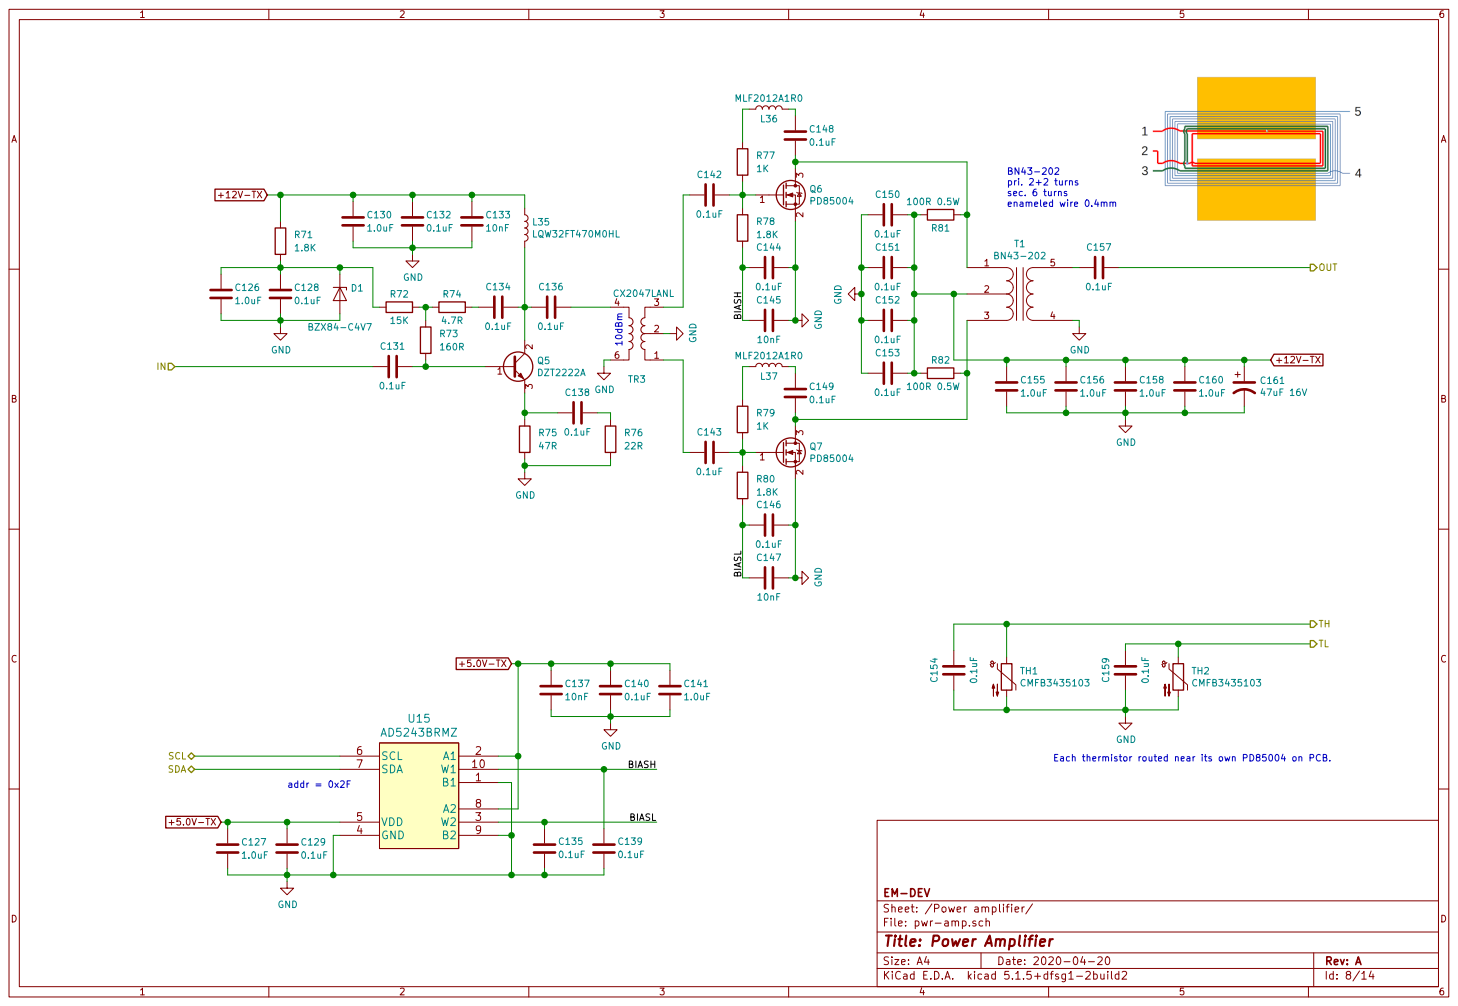
[picture p24: page 8]

sec. 6 turns enameled wire 0.4mm 10dBm

Each thermistor routed near its own PD85004 on PCB. addr = 0x2F

File: pwr-amp.sch
Id: 8/14 Title: Power Amplifier

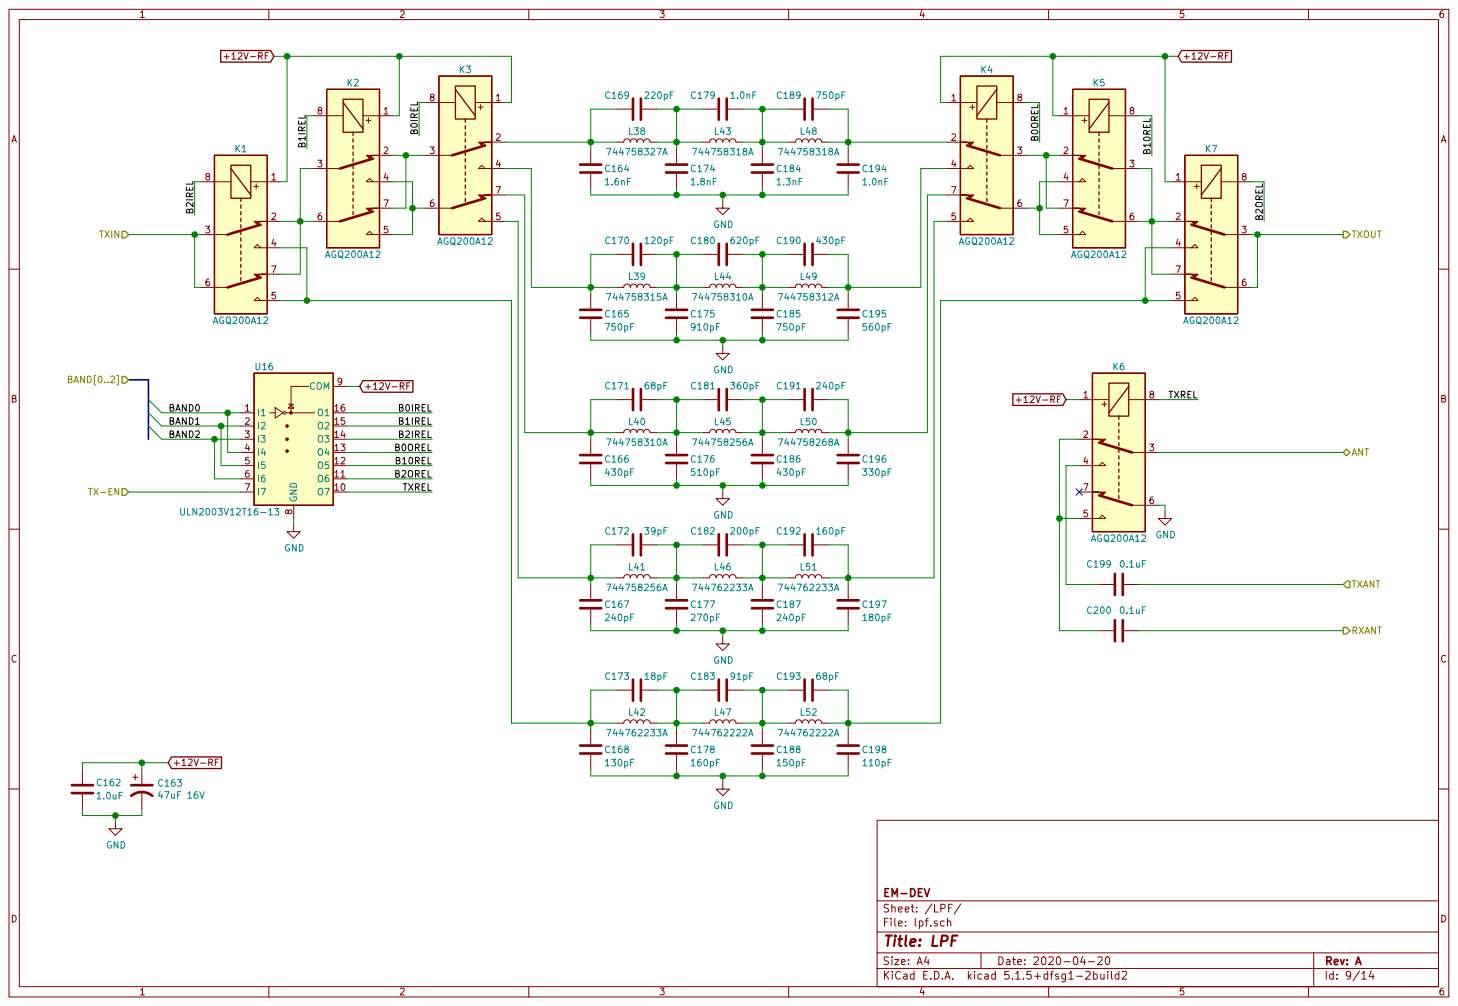
[picture p25: page 9]

File: lpf.sch Sheet: /LPF/ EM-DEV

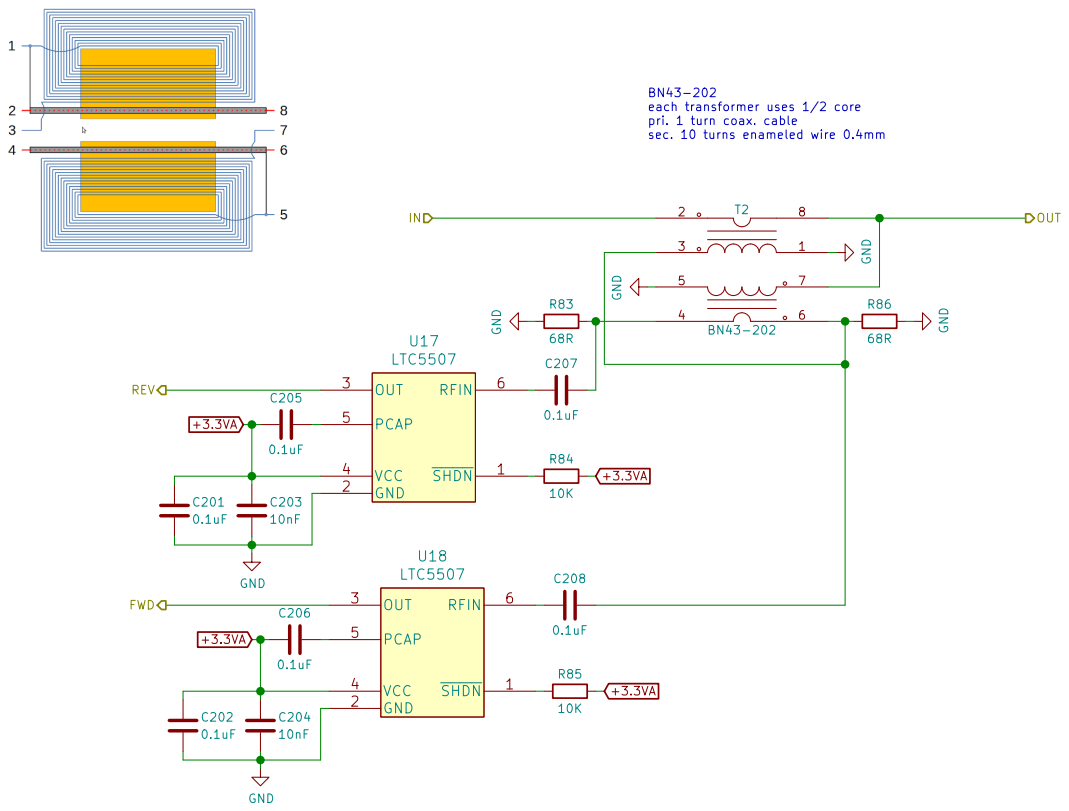
[picture p26: page 10]

each transformer uses 1/2 core
pri. 1 turn coax. cable
sec. 10 turns enameled wire 0.4mm

Id: 10/14 Title: SWR meter File: swr-meter.sch Sheet: /SWR meter/ EM-DEV

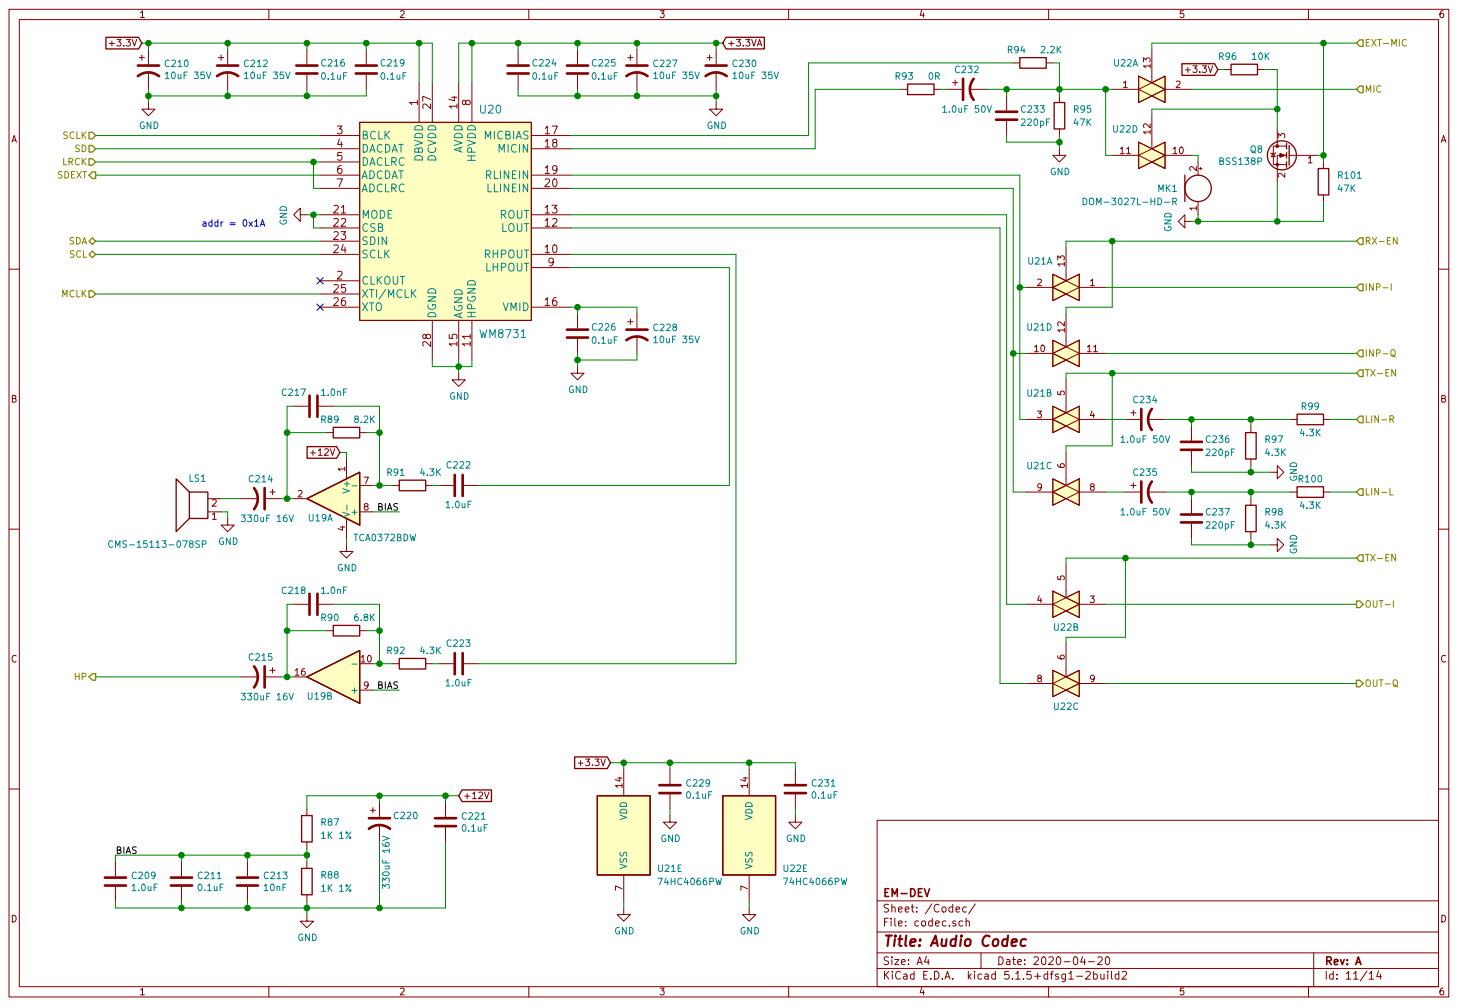
[picture p27: page 11]

File: codec.sch Sheet: /Codec/ EM-DEV

Id: 11/14 Title: Audio Codec

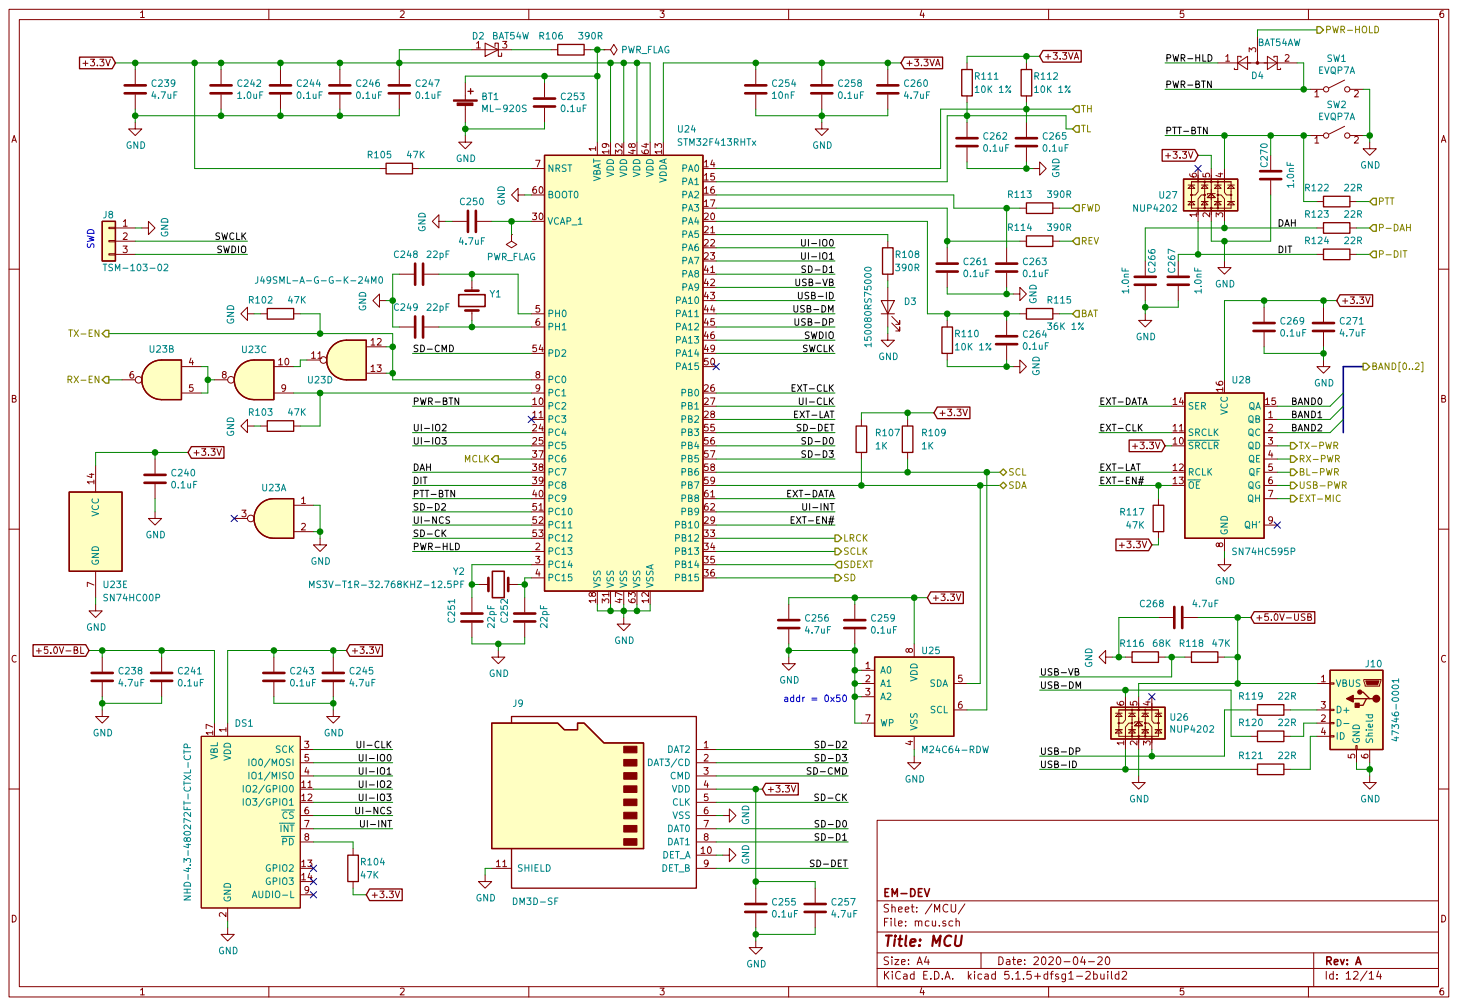
[picture p28: page 12]

1 VCAP_1 30 VDD 19 VDD 32 VDD 48 VDD 64 VDDA 13 VSS 18 VSS 31 VSS 47 VSS 63 VSSA 12 U24 STM32F413RHTx BT1 ML-920S C253

8 QH' 9 U28 SN74HC595P GND GND GND

SD-DET UI-IO0 SD-D1 UI-INT USB-ID

EXT-DATA UI-CLK

EXT-LAT EXT-CLK UI-NCS

4 SDA 5 SCL 6 WP 7 VDD

USB-DP USB-ID

File: mcu.sch Sheet: /MCU/ EM-DEV

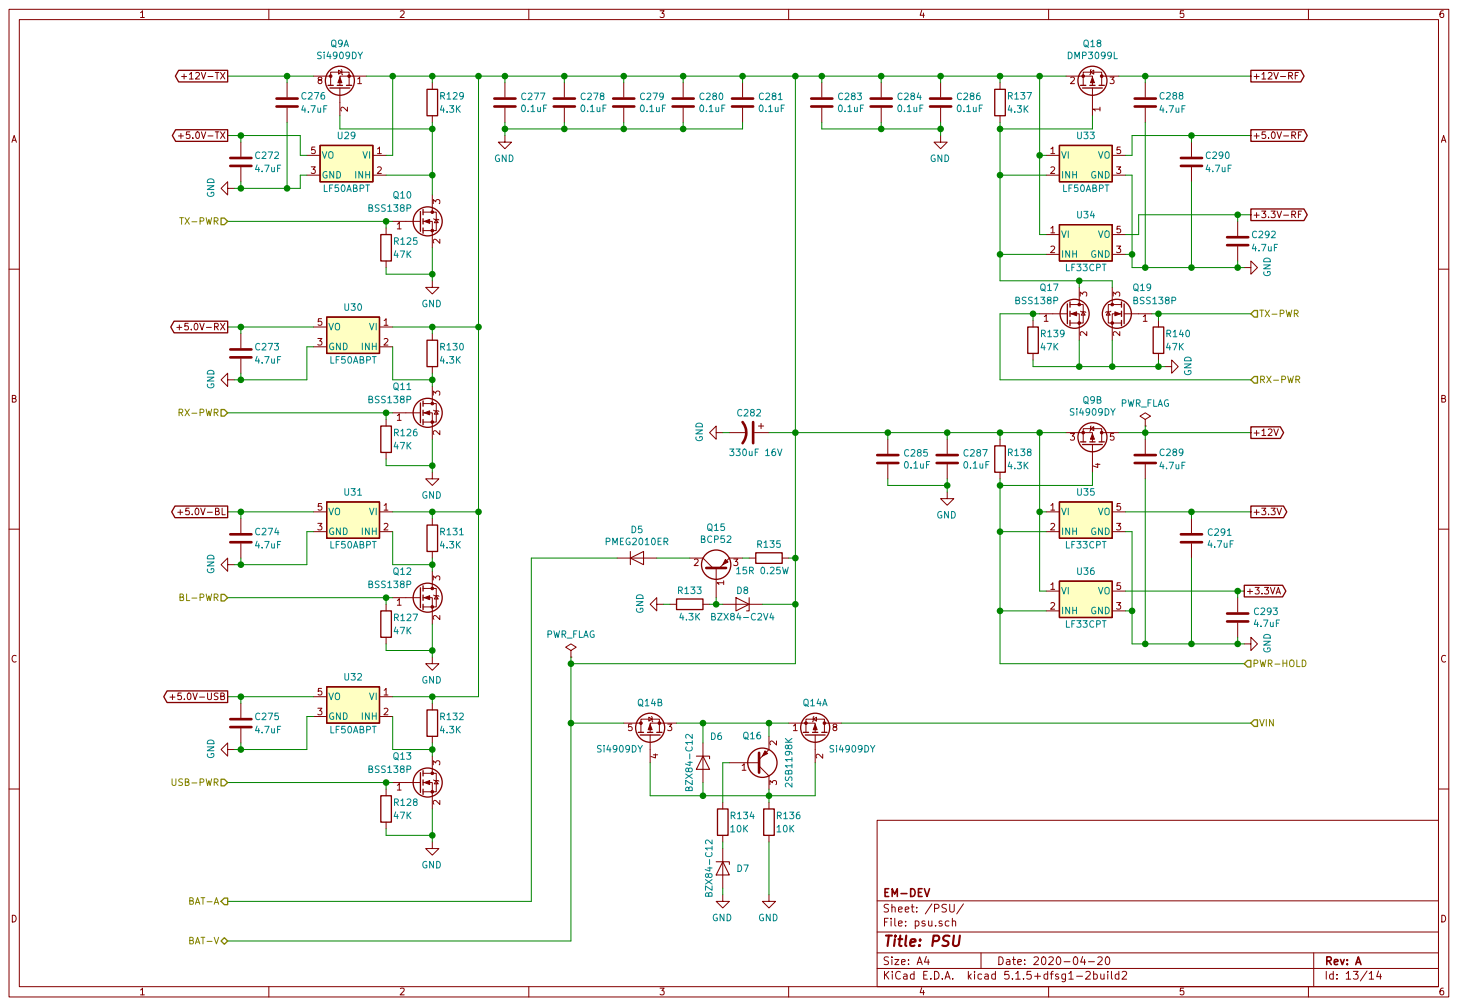
[picture p29: page 13]

File: psu.sch Sheet: /PSU/ EM-DEV

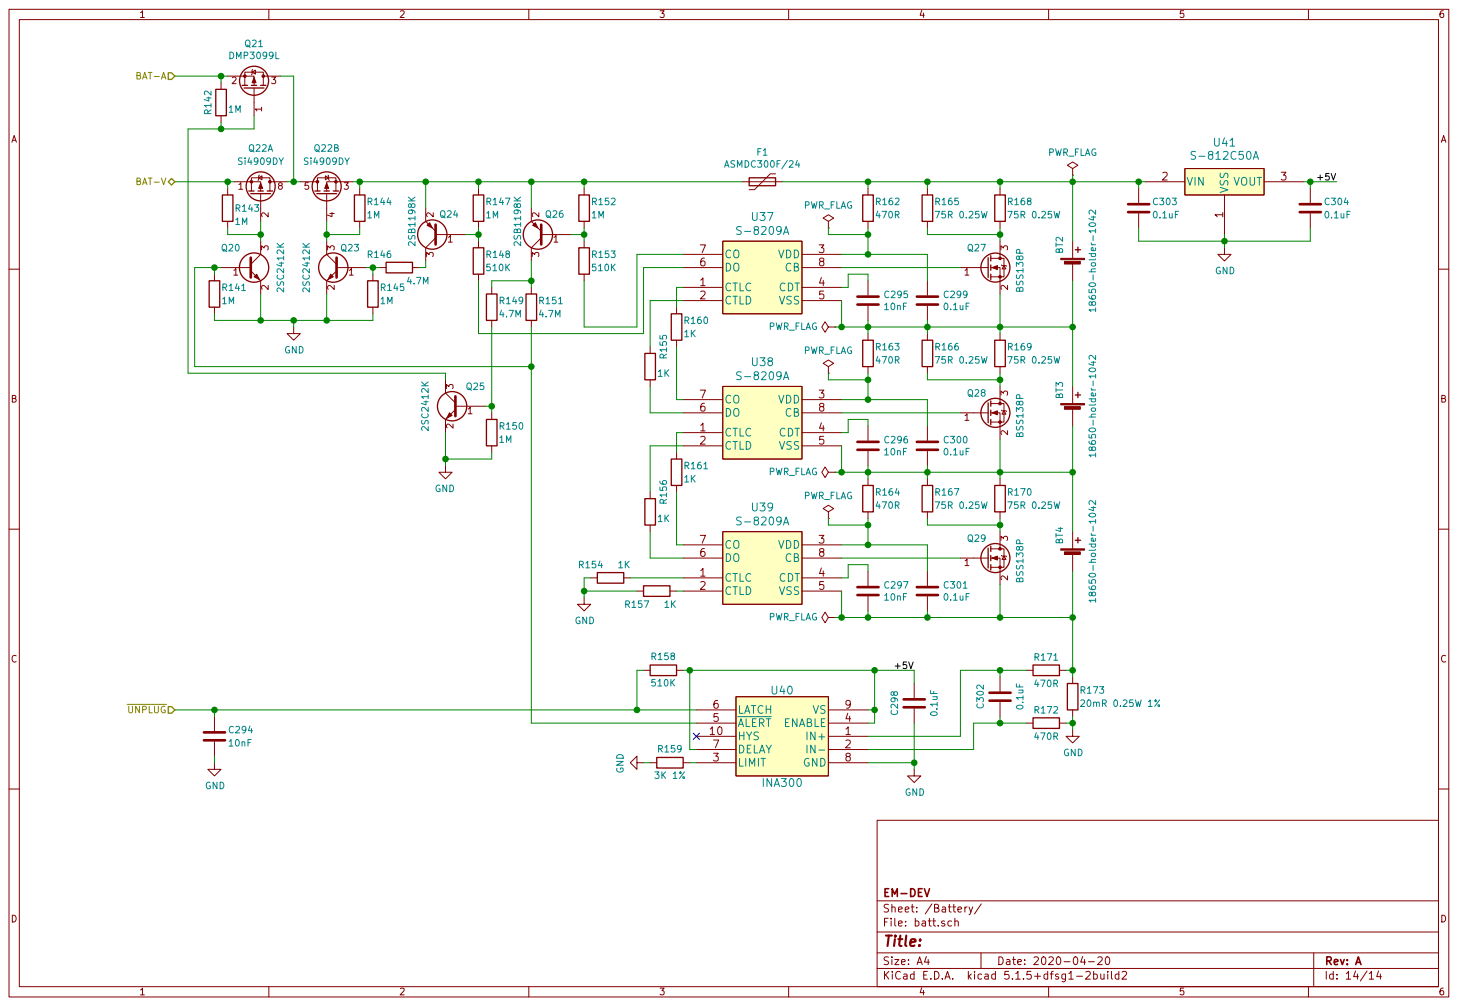
[picture p30: page 14]

Id: 14/14 Title: File: batt.sch Sheet: /Battery/ EM-DEV
