andriy-bilynskyy/sdr-trx/schematic/doc/pcb-bot.pdf

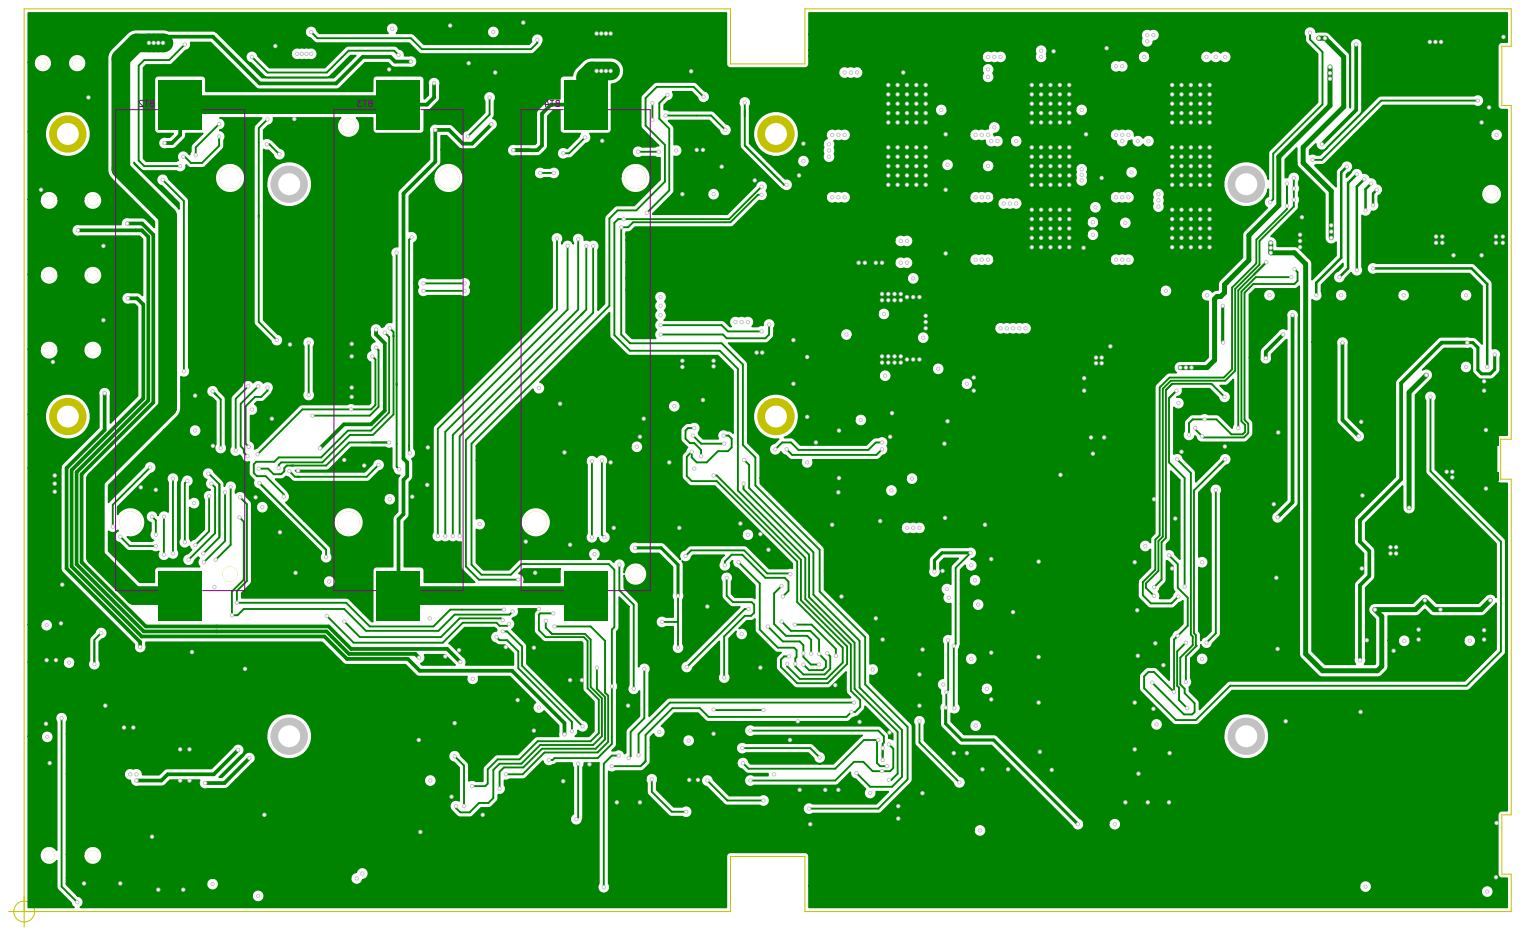
[picture p31: page 1]
