andriy-bilynskyy/sdr-trx/schematic/doc/pcb-in-gnd.pdf

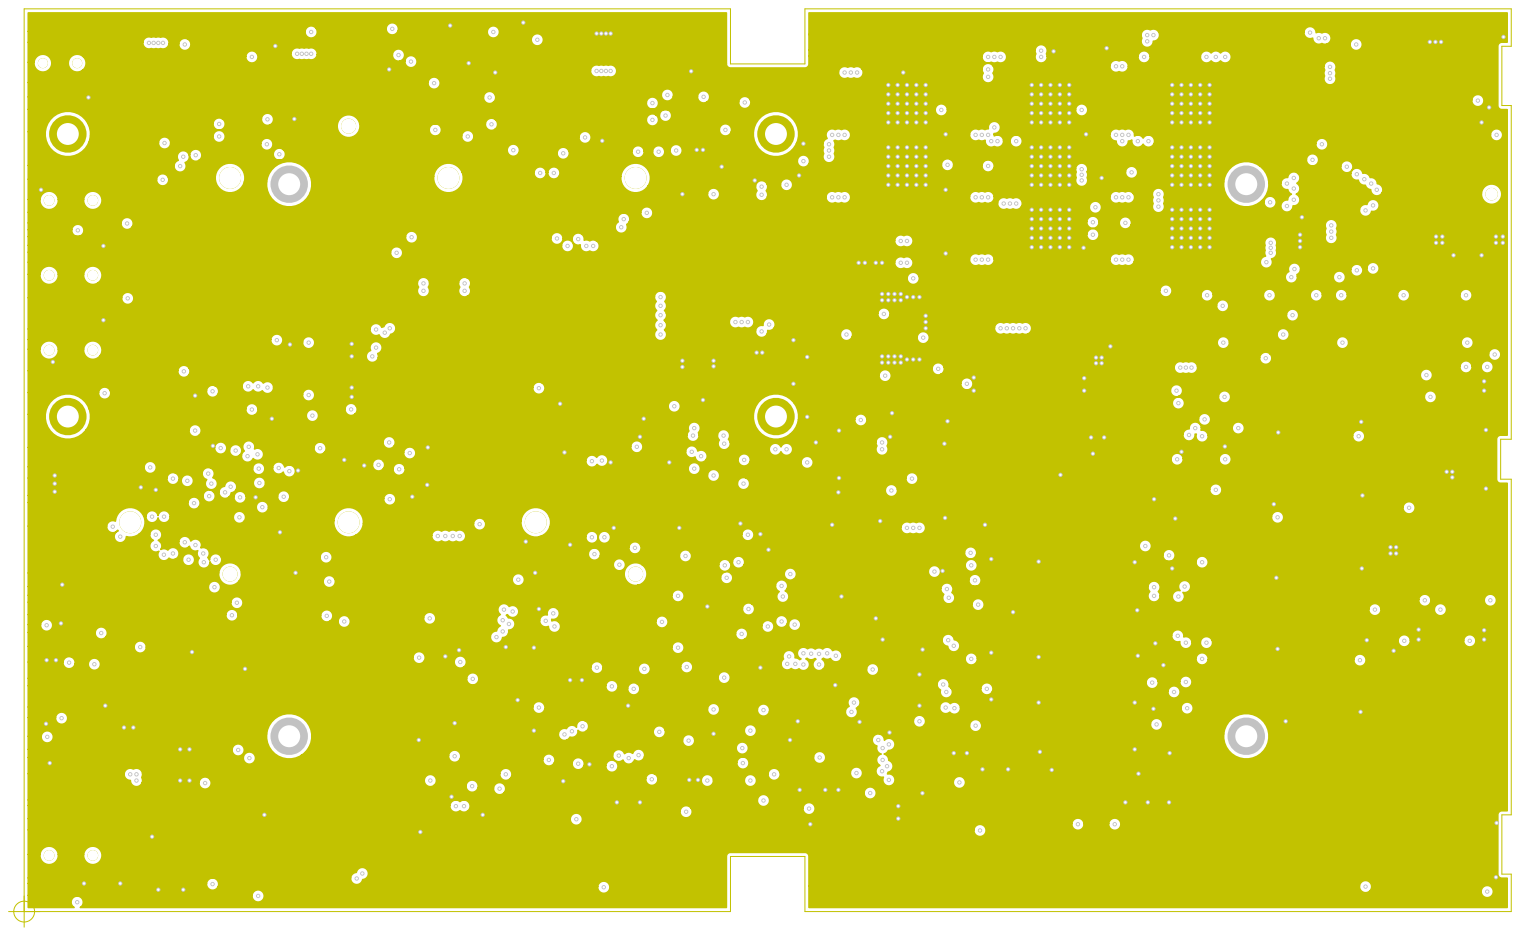
[picture p32: page 1]
