andriy-bilynskyy/sdr-trx/schematic/doc/pcb-in-vcc.pdf

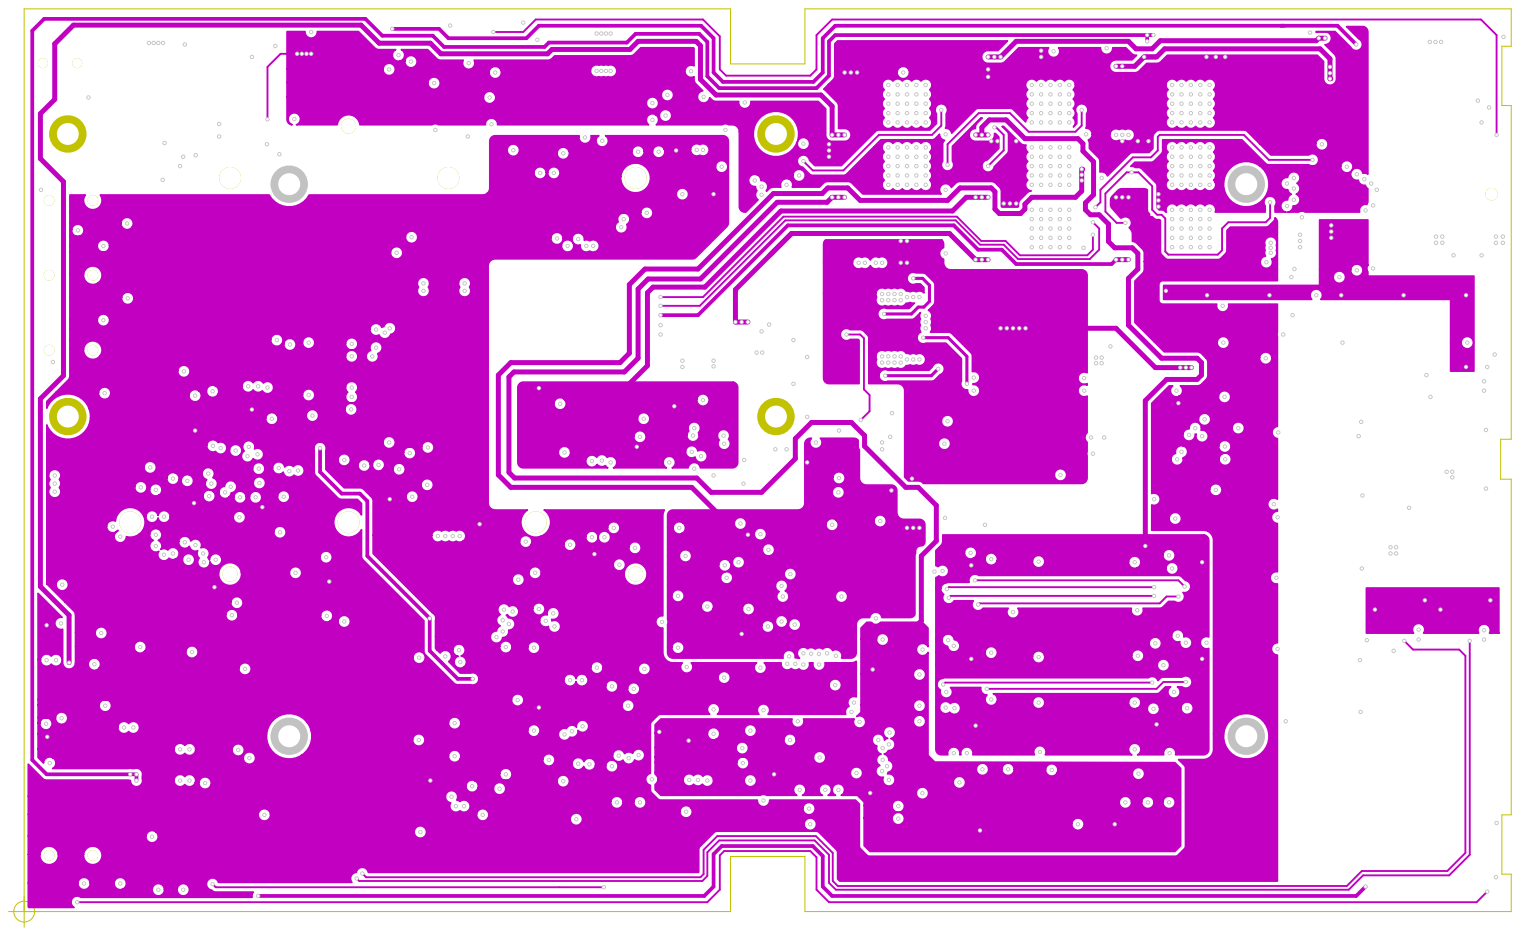
[picture p33: page 1]
