andriy-bilynskyy/sdr-trx/schematic/doc/pcb-top.pdf

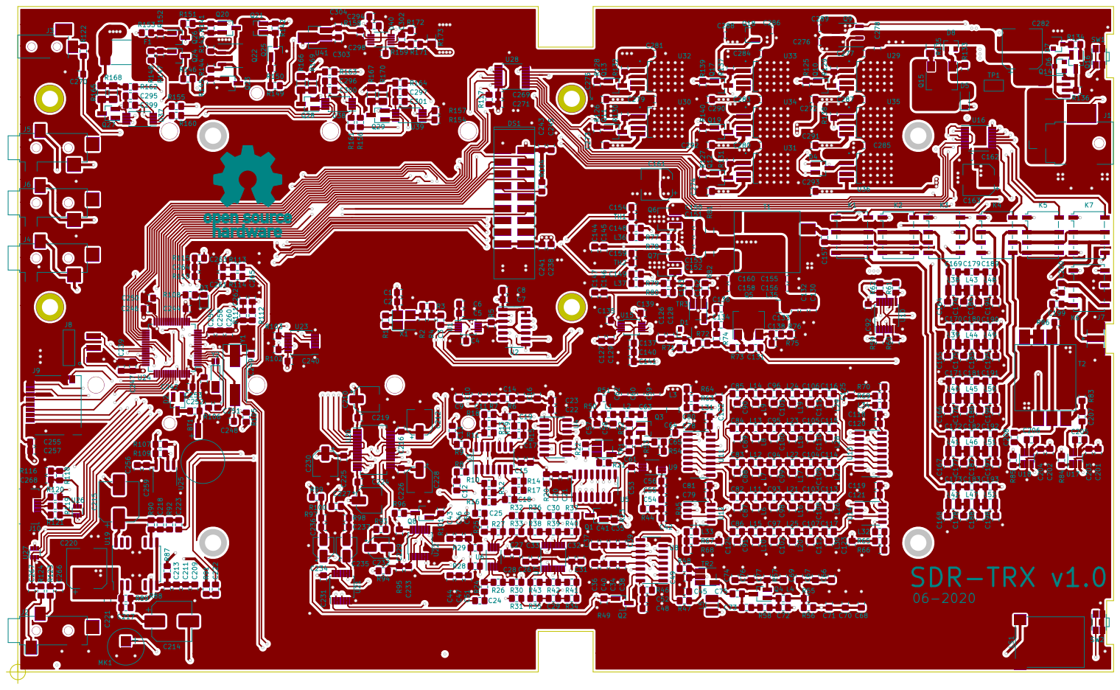
[picture p34: page 1]
