andriy-bilynskyy/sdr-trx/simulation/modulator.asc

C1: cap; 1µ
C2: cap; 8.2n
C3: cap; 1µ
C4: cap; 8.2n
C6: cap; 1µ
R1: res; 10K; tol=0.1
R2: res; 10K; tol=0.1
R3: res; 10K; tol=0.1
R4: res; 10K; tol=0.1
R5: res; 100; tol=0.1
R6: res; 100; tol=0.1
R7: res; 10K; tol=0.1
R8: res; 10K; tol=0.1
R9: res; 10K; tol=0.1
R10: res; 10K; tol=0.1
R11: res; 100; tol=0.1
R12: res; 100; tol=0.1
R13: res; 100; tol=0.1
R14: res; 100; tol=0.1
R15: res; 1K; tol=0.1
R16: res; 1K; tol=0.1
RL: res; 50; tol=0.1
U1: AD8604
U2: AD8604
U3: AD8604
U4: AD8604
U5: AD8618
U6: AD8618
U7: AD8618
U9: AD8618
V1: voltage; 5.0
V2: voltage; SINE(0 0.87 1k); AC 1. 0
V3: voltage; SINE(0 0.87 1k 0.25m); AC 1. 90
V4: voltage; PULSE(0 5 0 2n 2n 0.5u 1u)
V5: voltage; PULSE(0 5 0.25u 2n 2n 0.5u 1u)
X2: CX2047LANL
X3: SN74CBT3253C
Named nets: 0, VCC, BIAS, DAC-I, OUT-180, OUT-000, OUT-270, OUT-090, DAC-Q, F00, F90, RF-TX
.tran 10m
WM8731 DAC OUT
DCO OUTPUTS
.option numdgt=7
.optoin plotwinsize=0
LSB (Reverse signals for USB)
PA
3dBm
.meas Pout RMS V(rf-tx)*I(Rl)
.meas Pdbm param 10*log10(1e3*Pout)
.option noopiter
.options gmin=1e-10
.options abstol=1e-10
.options reltol=0.003
