andriy-bilynskyy/sdr-trx/simulation/tayloe-detector.asc

C1: cap; 8.2n
C2: cap; 0p
C3: cap; 8.2n
C4: cap; 0p
C5: cap; 8.2n
C6: cap; 1µ
C7: cap; 8.2n
C8: cap; 0p
C9: cap; 8.2n
C10: cap; 0p
C11: cap; 8.2n
C12: cap; 1µ
C13: cap; 0.1µ
C14: cap; 0.1µ
C15: cap; 10µ
R1: res; 1K
R2: res; 1K
R3: res; 10
R4: res; 100
R5: res; 820
R6: res; 1K
R7: res; 100
R8: res; 820
R9: res; 1K
R10: res; 10
R11: res; 1K
R12: res; 1K
R13: res; 10
R14: res; 100
R15: res; 820
R16: res; 1K
R17: res; 100
R18: res; 820
R19: res; 1K
R20: res; 10
R21: res; 100
R22: res; 100
R23: res; 1K
R24: res; 1K
RLI: res; 10K
RLQ: res; 10K
U1: LT6238
U2: LT6238
U3: LT6237
U4: LT6238
U5: LT6238
U6: LT6237
U7: LTC6655-2.5
V1: voltage; 5.0
V5: voltage; PULSE(0 5 0 1n 1n 0.5u 1u)
V6: voltage; PULSE(0 5 0.25u 1n 1n 0.5u 1u)
V7: voltage; SINE(0 10u 999K); Rser=50
X1: SN74CBT3253C
X2: CX2047LANL
Named nets: VCC, 0, INP-000, INP-180, ADC-I, INP-090, INP-270, F00, F90, BIAS, ADC-Q, OFS
.tran 0 10m 50u
DCO OUTPUTS
LNA
WM8731 ADC IN
.options gminsteps 0
.option srcsteps 0
