andriy-bilynskyy/sdr-trx/simulation/supply-protection.asc

D1: zener; KDZ12B
D2: zener; KDZ12B
M1: pmos; Si7143DP
M2: pmos; Si7143DP
Q1: pnp; 2SB1198K
R1: res; 10K
R3: res; 10K
RL: res; 10
VS: voltage; SINE(0 20 1)
Named nets: 0, OUT, IN
.tran 1
As power supply DC voltage is used.
AC source is applied only for simulation
to figure out when the circuit conducts.
