andriy-bilynskyy/sdr-trx/simulation/lp-amp.asc

C1: cap; 0.1µ
C2: cap; 0.1µ
C3: cap; 0.1µ
C4: cap; 0.1µ
C5: cap; 0.1µ
C6: cap; 0.1µ
C7: cap; 1µ
C8: cap; 0.1µ
C9: cap; 0.1µ
C10: cap; 0.1µ
C11: cap; 1µ
C12: cap; 1µ
C13: cap; 0.1µ
D1: zener; 1N750
L1: ind; 1µ; Ipk=80m Rser=0.15 Rpar=870 Cpar=0.989p
L2: ind; 1µ; Ipk=80m Rser=0.15 Rpar=870 Cpar=0.989p
L3: ind2; 8.8µ
L4: ind2; 8.8µ
L5: ind2; 79.2µ
Q1: npn; DI_DZT2222A
R1: res; 1K
R2: res; 1.8K
R3: res; 1K
R4: res; 1.8K
R5: res; 100
R6: res; 100
R7: res; 47
R8: res; 22
R9: res; 160
R10: res; 1.8K
R11: res; 15K
R12: res; 4.7
RL: res; 50
U1: PD85004
U2: PD85004
U3: LQW32FT470M0H
V1: voltage; {BIA}; Rser=10K
V2: voltage; 12
VS: voltage; SINE(0 {2.83*sqrt(5e-2*pow(10, Ain_dbm/10))} {Fin}); Rser=50
X1: CX2047LANL
Named nets: 0, BIAS, VCC, OUT, DH, DL, QC, QE, INP
K2 L3 L4 L5 1
.step param BIA 3.2 3.8 0.1
.tran 0 10u 0 1n
.param BIA=3.72
Original PA implementation:
https://www.qsl.net/in3otd/ham_radio/PD85004_PP_PA_II/PD85004_PP_PA_II.html
PD85004 spice model:
https://pdl.designspark.com/api/v1/manufacturers/53f31a719b4759f8698bcb81/part/57a9e61836414d3a5793abaa/58b03d918759c5ba698b6324/1.zip
.meas Pout rms V(out)*I(Rl)
.meas PU1 rms V(dh)*Ix(U1:D)
.meas PQ rms V(QC,QE)*Ic(Q1)
BN43-202
pri. 2+2 turns
sec. 6 turns
enameled wire 0.4mm
10dBm
MLF2012A1R0
MLF2012A1R0
*SRC=DZT2222A;DI_DZT2222A;BJTs NPN; Si;  40.0V  0.600A  410MHz
.MODEL DI_DZT2222A  NPN (IS=9.69f NF=1.00 BF=272 VAF=114
+ IKF=0.493 ISE=11.7f NE=2.00 BR=4.00 NR=1.00
+ VAR=24.0 IKR=0.750 RE=0.253 RB=1.01 RC=0.101
+ XTB=1.5 CJE=29.0p VJE=1.10 MJE=0.500 CJC=14.7p VJC=0.300
+ MJC=0.300 TF=362p TR=60.3n EG=1.12 )
.param Fin 10Meg
.step dec param Fin 1.8Meg 30Meg 3
.param Ain_dbm=3
