andriy-bilynskyy/sdr-trx/simulation/pre-amp.asc

C1: cap; 1µ
C2: cap; 0.1µ
C3: cap; 0.1µ
C4: cap; 0.1µ
C5: cap; 1µ
C6: cap; 0.1µ
L2: ind; 100µ; Ipk=30m Rser=3.5 Rpar=55K Cpar=1.169p
L3: ind; 220n; Ipk=250m Rser=0.16 Rpar=1K Cpar= 1.057p
Q1: npn; DI_MMBT2222A
R1: res; 47
R3: res; 1.8K
R4: res; 2.2K
R5: res; 18
R6: res; 180
RL: res; 50
U1: LQW32FT470M0H
V1: voltage; 5.0
VS: voltage; SINE(0 {2.83*sqrt(5e-2*pow(10, Ain_dbm/10))} {Fin}); AC 10u; Rser=50
Named nets: 0, VCC, OUT, INP, QE, QC
.tran 0 30u 10u 0.5n
8dB (50R)
MLZ2012N101LT000
.step dec param Fin 1.8Meg 30Meg 3
.meas Vout rms(V(out))
.meas Vinp rms(V(inp))
.meas Gain param 20*log10(Vout/Vinp)
.meas PQ rms V(QC,QE)*Ic(Q1)
.param Fin 1.8Meg
*SRC=MMBT2222A;DI_MMBT2222A;BJTs NPN; Si;  40.0V  0.600A  200MHz   Diodes Inc. Transistor 
.MODEL DI_MMBT2222A  NPN (IS=25.4f NF=1.00 BF=274 VAF=114 
+ IKF=0.121 ISE=14.3p NE=2.00 BR=4.00 NR=1.00 
+ VAR=24.0 IKR=0.300 RE=0.219 RB=0.877 RC=87.7m 
+ XTB=1.5 CJE=27.6p VJE=1.10 MJE=0.500 CJC=14.2p VJC=0.300 
+ MJC=0.300 TF=622p TR=124n EG=1.12 )
.param Ain_dbm=3
MLF2012DR22
