andriy-bilynskyy/sdr-trx/simulation/SWR-metr.asc

C1: cap; 0.1µ
C2: cap; 0.1µ
C3: cap; 0.1µ
C4: cap; 0.1µ
C5: cap; 0.1µ
C6: cap; 0.1µ
L1: ind2; 0.55µ
L2: ind2; 107.8µ
L3: ind2; 0.55µ
L4: ind2; 107.8µ
R1: res; 68
R2: res; 68
R3: res; 10K
R5: res; 10K
RL: res; 50
U1: LTC5507
U2: LTC5507
V1: voltage; 3.3
VS: voltage; SINE(0 {2*sqrt(2*Pin*50)} {Fin}); Rser=50
Named nets: 0, IN, OUT, VR, VF, F-ADC, VCC, R-ADC
.tran 0 1m 0.9m
See: https://www.youtube.com/watch?v=byF1FLdbUiA
Vf=VF/N  Vr=VR/N
K1 L1 L2 1
K2 L3 L4 1
.step dec param Fin 1.8Meg 30Meg 3
.param Fin=10Meg
.param Pin=5
.step param Pin 2 5 0.5
* Values from ADCs
.meas Aadf avg(V(f-adc))
.meas Aadr avg(V(r-adc))
 
* See ../calculations/swr-meter.ods
.param a2 2.741896
.param a1 -1.226987
.param a0 0.117974
 
* Forvard and revers power
.meas Pf param uramp(a2*pow(Aadf,2)+a1*Aadf+a0)
.meas Pr param uramp(a2*pow(Aadr,2)+a1*Aadr+a0)
 
* SWR
.meas SWR param (1+sqrt(Pr/Pf))/(1-sqrt(Pr/Pf))
Each transformer on a half of BN-43-202 1:14 Turns
