andriy-bilynskyy/sdr-trx/simulation/LPF.asc

C1: cap; 1.6n
C2: cap; 1.8n
C3: cap; 1.3n
C4: cap; 1n
C5: cap; 220p
C6: cap; 1.0n
C7: cap; 750p
C8: cap; 750p
C9: cap; 910p
C10: cap; 750p
C11: cap; 560p
C12: cap; 120p
C13: cap; 620p
C14: cap; 430p
C15: cap; 510p
C16: cap; 68p
C17: cap; 430p
C18: cap; 430p
C19: cap; 330p
C20: cap; 360p
C21: cap; 240p
C22: cap; 270p
C23: cap; 39p
C24: cap; 240p
C25: cap; 240p
C26: cap; 180p
C27: cap; 200p
C28: cap; 160p
C29: cap; 160p
C30: cap; 18p
C31: cap; 130p
C32: cap; 150p
C33: cap; 110p
C34: cap; 91p
C35: cap; 68p
L1: ind; 2.7µ
L2: ind; 1.8µ
L3: ind; 1.8µ
L4: ind; 1.5µ
L5: ind; 1µ
L6: ind; 1.2µ
L7: ind; 1µ
L8: ind; 560n
L9: ind; 680n
L10: ind; 560n
L11: ind; 330n
L12: ind; 330n
L13: ind; 330n
L14: ind; 220n
L15: ind; 220n
RL1: res; 50
RL2: res; 50
RL3: res; 50
RL4: res; 50
RL5: res; 50
VS1: voltage; ""; AC 1.; Rser=50
VS2: voltage; ""; AC 1.; Rser=50
VS3: voltage; ""; AC 1.; Rser=50
VS4: voltage; ""; AC 1.; Rser=50
VS5: voltage; ""; AC 1.; Rser=50
Named nets: 0, OUT1, INP1, OUT2, INP2, OUT3, INP3, OUT4, INP4, OUT5, INP5
.ac dec 400 1Meg 80Meg
5.55 MHz
L4 - 744758315A
L5 - 744758310A
L6 - 744758312A
9.74 MHz
L7 - 744758310A
L8 - 744758256A
L9 - 744758268A
17.09 MHz
L10 - 744758256A
L11 - 744762233A
L12 - 744762233A
30.00 MHz
L10 - 744762233A
L11 - 744762222A
L12 - 744762222A
https://rf-tools.com/lc-filter/
3.16 MHz
L1 - 744758327A
L2 - 744758318A
L3 - 744758318A
