andriy-bilynskyy/sdr-trx/simulation/BPF.asc

C1: cap; 3.3n
C2: cap; 620p
C3: cap; 4.7n
C4: cap; 620p
C5: cap; 3n
C6: cap; 1.8n
C7: cap; 330p
C8: cap; 2.7n
C9: cap; 330p
C10: cap; 1.8n
C11: cap; 1n
C12: cap; 200p
C13: cap; 1.5n
C14: cap; 200p
C15: cap; 1n
C16: cap; 560p
C17: cap; 91p
C18: cap; 910p
C19: cap; 91p
C20: cap; 560p
C21: cap; 300p
C22: cap; 62p
C23: cap; 510p
C24: cap; 62p
C25: cap; 300p
L1: ind; 1.5µ
L2: ind; 6.8µ
L3: ind; 1µ
L4: ind; 6.8µ
L5: ind; 1.5µ
L6: ind; 820n
L7: ind; 3.9µ
L8: ind; 560n
L9: ind; 3.9µ
L10: ind; 820n
L11: ind; 470n
L12: ind; 2.2µ
L13: ind; 330n
L14: ind; 2.2µ
L15: ind; 470n
L16: ind; 270n
L17: ind; 1.5µ
L18: ind; 180n
L19: ind; 1.5µ
L20: ind; 270n
L21: ind; 150n
L22: ind; 820n
L23: ind; 100n
L24: ind; 820n
L25: ind; 150n
RL1: res; 50
RL2: res; 50
RL3: res; 50
RL4: res; 50
RL5: res; 50
VS1: voltage; ""; AC 1; Rser=50
VS2: voltage; ""; AC 1; Rser=50
VS3: voltage; ""; AC 1; Rser=50
VS4: voltage; ""; AC 1; Rser=50
VS5: voltage; ""; AC 1; Rser=50
Named nets: 0, INP1, OUT1, INP2, OUT2, INP3, OUT3, INP4, OUT4, INP5, OUT5
BPF1 1.800 - 3.160 MHz
.ac dec 400 1Meg 50Meg
BPF2 3.160 - 5.546 MHz
BPF3 5.546 - 9.736 MHz
BPF4 9.736 - 17.090 MHz
BPF5 17.090 - 30.000 MHz
https://rf-tools.com/lc-filter/
