andriy-bilynskyy/sdr-trx/simulation/LNA.asc

C1: cap; 0.1µ
C2: cap; 100n
C3: cap; 0.1µ
C4: cap; 0.1µ
C5: cap; 0.1µ
C6: cap; 0.1µ
L2: ind; 100µ; Ipk=30m Rser=3.5 Rpar=55K Cpar=1.169p
R1: res; 150
R2: res; 470
R3: res; 4.3K
R4: res; 2.2K
RL: res; 50
U1: BFU520W
U2: LQW32FT470M0H
V1: voltage; 5.0
VS: voltage; SINE(0 10u {Fin}); AC 10u; Rser=50
Named nets: 0, INP, VCC, OUT
.tran 0 30u 10u 0.5n
17dB (50R)
MLZ2012N101LT000
.step dec param Fin 1.8Meg 30Meg 3
.meas Vout rms(V(out))
.meas Vinp rms(V(inp))
.meas Gain param 20*log10(Vout/Vinp)
.param Fin 1.8Meg
