andriy-bilynskyy/sdr-trx/simulation/CX2047LANL.asc

L1: ind2; 68µ
L2: ind2; 68µ
L3: ind2; 68µ
Named nets: PRI+, PRI-, SECCT, SEC-, SEC+
K1 L1 L2 L3 1
