andriy-bilynskyy/sdr-trx/simulation/SN74CBT3253C.asc

A1: and; Vhigh=2.7 Vlow=0.4
A2: and; Vhigh=2.7 Vlow=0.4
A3: and; Vhigh=2.7 Vlow=0.4
A4: and; Vhigh=2.7 Vlow=0.4
A5: and; Vhigh=2.7 Vlow=0.4
A6: and; Vhigh=2.7 Vlow=0.4
A7: and; Vhigh=2.7 Vlow=0.4
A8: and; Vhigh=2.7 Vlow=0.4
A9: inv; Vhigh=2.7 Vlow=0.4
A10: inv; Vhigh=2.7 Vlow=0.4
A11: buf1; Vhigh=2.7 Vlow=0.4
A12: buf1; Vhigh=2.7 Vlow=0.4
A13: inv; Vhigh=2.7 Vlow=0.4
A14: inv; Vhigh=2.7 Vlow=0.4
S1: sw
S2: sw
S3: sw
S4: sw
S5: sw
S6: sw
S7: sw
S8: sw
Named nets: 1A, 2B1, 2B2, 2B3, 2B4, 2A, S0, S1, 1OE#, 2OE#, 0, 1B1, 1B2, 1B3, 1B4
.model SW SW(Ron=3 Vt=1.5 Vh=0.8)
