andriy-bilynskyy/sdr-trx/schematic/sdr-trx/sdr-trx.kicad_pcb

## KiCad design schematic/sdr-trx/sdr-trx.kicad_pcb (2020-07-17)

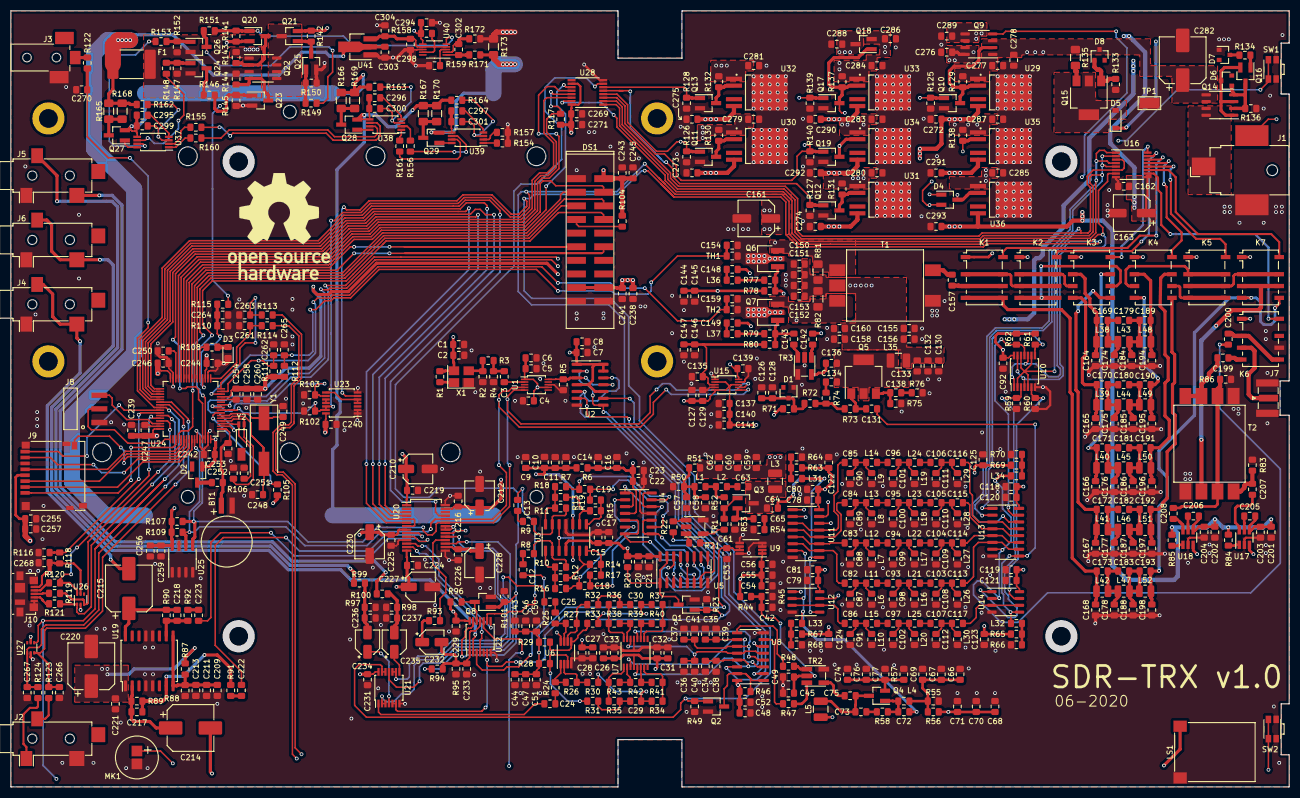
[picture p35: board sdr-trx.kicad_pcb from above]

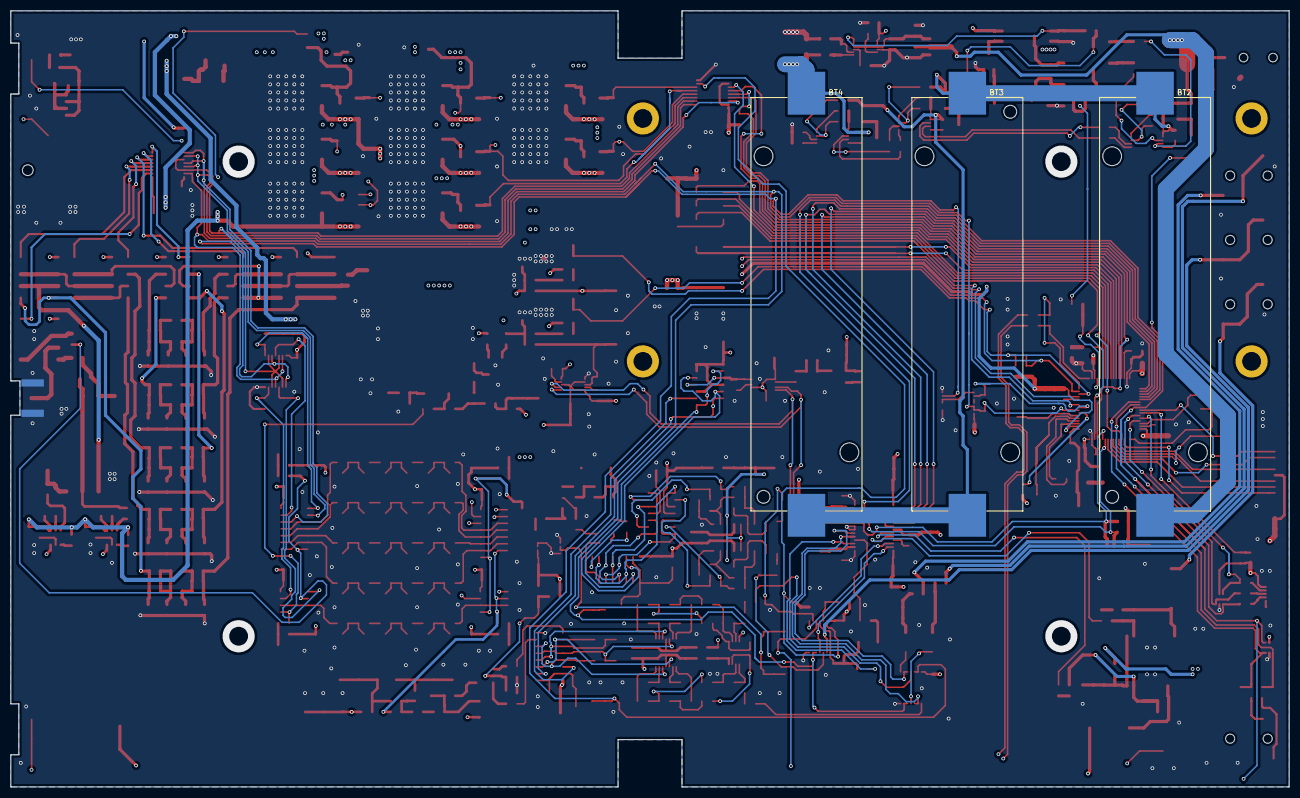
[picture p36: board sdr-trx.kicad_pcb from below]

Board: 4 copper layers, 238.4 x 144.7 mm, 645 parts (3 on the bottom side), 372 nets.

Parts:
BT1: ML-920S; ML920S
BT2, BT3, BT4: 18650-holder-1042; BATT-18650-1042
C1, C3, C4, C5, C8, C10, C15, C16, C20, C22, C27, C32, C45, C46, C47, C48, C56, C57, C59, C61, C63, C64, C65, C66, C68, C72, C73, C74, C75, C80, C81, C82, C83, C84, C85, C86, C92, C113, C114, C115, C116, C117, C118, C119, C122, C123, C124, C125, C128, C129, C131, C132, C134, C135, C136, C138, C139, C140, C142, C143, C144, C146, C148, C149, C150, C151, C152, C153, C154, C157, C159, C199, C200, C201, C202, C205, C206, C207, C208, C211, C216, C219, C221, C224, C225, C226, C229, C231, C240, C241, C243, C244, C246, C247, C253, C255, C258, C259, C261, C262, C263, C264, C265, C269, C277, C278, C279, C280, C281, C283, C284, C285, C286, C287, C298, C299, C300, C301, C302, C303, C304: 0.1uF; C_0805_2012Metric_Pad1.15x1.40mm_HandSolder
C2, C7, C11, C14, C21, C28, C33, C49, C50, C51, C52, C54, C58, C60, C67, C70, C76, C78, C79, C120, C121, C133, C137, C145, C147, C203, C204, C213, C254, C294, C295, C296, C297: 10nF; C_0805_2012Metric_Pad1.15x1.40mm_HandSolder
C6, C9, C12, C13, C17, C23, C24, C25, C26, C31, C42, C43, C44, C53, C55, C126, C127, C130, C141, C155, C156, C158, C160, C162, C209, C222, C223, C242: 1.0uF; C_0805_2012Metric_Pad1.15x1.40mm_HandSolder
C18, C19, C29, C30, C38, C39, C40, C41: 8.2nF 1%; C_0805_2012Metric_Pad1.15x1.40mm_HandSolder
C34, C35, C36, C37: N/A; C_0805_2012Metric_Pad1.15x1.40mm_HandSolder
C62, C69, C71, C77, C89, C110, C179, C194, C217, C218, C266, C267, C270: 1.0nF; C_0805_2012Metric_Pad1.15x1.40mm_HandSolder
C87: 3.3nF; C_0805_2012Metric_Pad1.15x1.40mm_HandSolder
C88, C109, C174: 1.8nF; C_0805_2012Metric_Pad1.15x1.40mm_HandSolder
C90, C111, C195: 560pF; C_0805_2012Metric_Pad1.15x1.40mm_HandSolder
C91, C112: 300pF; C_0805_2012Metric_Pad1.15x1.40mm_HandSolder
C93, C103, C180: 620pF; C_0805_2012Metric_Pad1.15x1.40mm_HandSolder
C94, C104, C196: 330pF; C_0805_2012Metric_Pad1.15x1.40mm_HandSolder
C95, C105, C182: 200pF; C_0805_2012Metric_Pad1.15x1.40mm_HandSolder
C96, C106, C183: 91pF; C_0805_2012Metric_Pad1.15x1.40mm_HandSolder
C97, C107: 62pF; C_0805_2012Metric_Pad1.15x1.40mm_HandSolder
C98: 4.7nF; C_0805_2012Metric_Pad1.15x1.40mm_HandSolder
C99: 2.7nF; C_0805_2012Metric_Pad1.15x1.40mm_HandSolder
C100: 1.5nF; C_0805_2012Metric_Pad1.15x1.40mm_HandSolder
C101, C175: 910pF; C_0805_2012Metric_Pad1.15x1.40mm_HandSolder
C102, C176: 510pF; C_0805_2012Metric_Pad1.15x1.40mm_HandSolder
C108: 3.0nF; C_0805_2012Metric_Pad1.15x1.40mm_HandSolder
C161, C163: 47uF 16V; CP_Elec_6.3x5.8
C164: 1.6nF; C_0805_2012Metric_Pad1.15x1.40mm_HandSolder
C165, C185, C189: 750pF; C_0805_2012Metric_Pad1.15x1.40mm_HandSolder
C166, C186, C190: 430pF; C_0805_2012Metric_Pad1.15x1.40mm_HandSolder
C167, C187, C191: 240pF; C_0805_2012Metric_Pad1.15x1.40mm_HandSolder
C168: 130pF; C_0805_2012Metric_Pad1.15x1.40mm_HandSolder
C169, C233, C236, C237: 220pF; C_0805_2012Metric_Pad1.15x1.40mm_HandSolder
C170: 120pF; C_0805_2012Metric_Pad1.15x1.40mm_HandSolder
C171, C193: 68pF; C_0805_2012Metric_Pad1.15x1.40mm_HandSolder
C172: 39pF; C_0805_2012Metric_Pad1.15x1.40mm_HandSolder
C173: 18pF; C_0805_2012Metric_Pad1.15x1.40mm_HandSolder
C177: 270pF; C_0805_2012Metric_Pad1.15x1.40mm_HandSolder
C178, C192: 160pF; C_0805_2012Metric_Pad1.15x1.40mm_HandSolder
C181: 360pF; C_0805_2012Metric_Pad1.15x1.40mm_HandSolder
C184: 1.3nF; C_0805_2012Metric_Pad1.15x1.40mm_HandSolder
C188: 150pF; C_0805_2012Metric_Pad1.15x1.40mm_HandSolder
C197: 180pF; C_0805_2012Metric_Pad1.15x1.40mm_HandSolder
C198: 110pF; C_0805_2012Metric_Pad1.15x1.40mm_HandSolder
C210, C212, C227, C228, C230: 10uF 35V; CP_Elec_5x5.8
C214, C215, C220, C282: 330uF 16V; CP_Elec_8x10.5
C232, C234, C235: 1.0uF 50V; CP_Elec_4x5.4
C238, C239, C245, C250, C256, C257, C260, C268, C271, C272, C273, C274, C275, C276, C288, C289, C290, C291, C292, C293: 4.7uF; C_0805_2012Metric_Pad1.15x1.40mm_HandSolder
C248, C249, C251, C252: 22pF; C_0805_2012Metric_Pad1.15x1.40mm_HandSolder
D1: BZX84-C4V7; D_SOT-23_ANK
D2: BAT54W; SOT-23_Handsoldering
D3: 150080RS75000; D_0805_2012Metric_Pad1.15x1.40mm_HandSolder
D4: BAT54AW; SOT-23_Handsoldering
D5: PMEG2010ER; D_SOD-123
D6, D7: BZX84-C12; D_SOT-23_ANK
D8: BZX84-C2V4; D_SOT-23_ANK
DS1: NHD-4.3-480272FT-CTXL-CTP
F1: ASMDC300F/24; Fuse_2920_7451Metric_Pad2.10x5.45mm_HandSolder
J1: PJ-036AH-SMT; BarrelJack_CUI_PJ-036AH-SMT_Horizontal
J2: SJ-3524-SMT-TR; Jack_3.5mm_CUI_SJ-3524-SMT_Horizontal
J3: PJ1-022-SMT
J4: SJ-3524-SMT-TR-GR; Jack_3.5mm_CUI_SJ-3524-SMT_Horizontal
J5: SJ-3524-SMT-TR-BE; Jack_3.5mm_CUI_SJ-3524-SMT_Horizontal
J6: SJ-3524-SMT-TR-PI; Jack_3.5mm_CUI_SJ-3524-SMT_Horizontal
J7: CON-SMA-EDGE; SMA_Samtec_SMA-J-P-X-ST-EM1_EdgeMount
J8: TSM-103-02
J9: DM3D-SF; microSD_HC_Hirose_DM3D-SF
J10: 47346-0001; USB_Micro-B_Molex_47346-0001
K1, K2, K3, K4, K5, K6, K7: AGQ200A12; Relay_DPDT_Omron_G6K-2F-Y
L1, L4, L31, L32, L33, L34: MLZ2012N101LT000; L_0805_2012Metric_Pad1.15x1.40mm_HandSolder
L2: MLF2012DR22; L_0805_2012Metric_Pad1.15x1.40mm_HandSolder
L3, L5, L35: LQW32FT470M0HL; L_1210_3225Metric_Pad1.42x2.65mm_HandSolder
L6, L14, L24, L26: MLF2012A1R5; L_0805_2012Metric_Pad1.15x1.40mm_HandSolder
L7, L15, L25, L27: MLF2012DR82; L_0805_2012Metric_Pad1.15x1.40mm_HandSolder
L8, L28: MLF2012DR47; L_0805_2012Metric_Pad1.15x1.40mm_HandSolder
L9, L29: MLF2012DR27; L_0805_2012Metric_Pad1.15x1.40mm_HandSolder
L10, L30: MLF2012DR15; L_0805_2012Metric_Pad1.15x1.40mm_HandSolder
L11, L21: MLF2012E6R8; L_0805_2012Metric_Pad1.15x1.40mm_HandSolder
L12, L22: MLF2012A3R9; L_0805_2012Metric_Pad1.15x1.40mm_HandSolder
L13, L23: MLF2012A2R2; L_0805_2012Metric_Pad1.15x1.40mm_HandSolder
L16, L36, L37: MLF2012A1R0; L_0805_2012Metric_Pad1.15x1.40mm_HandSolder
L17: MLF2012DR56; L_0805_2012Metric_Pad1.15x1.40mm_HandSolder
L18: MLF2012DR33; L_0805_2012Metric_Pad1.15x1.40mm_HandSolder
L19: MLF2012DR18; L_0805_2012Metric_Pad1.15x1.40mm_HandSolder
L20: MLF2012DR10; L_0805_2012Metric_Pad1.15x1.40mm_HandSolder
L38: 744758327A; L_1008_2520Metric
L39: 744758315A; L_1008_2520Metric
L40, L44: 744758310A; L_1008_2520Metric
L41, L45: 744758256A; L_1008_2520Metric
L42, L46, L51: 744762233A; L_1008_2520Metric
L43, L48: 744758318A; L_1008_2520Metric
L47, L52: 744762222A; L_1008_2520Metric
L49: 744758312A; L_1008_2520Metric
L50: 744758268A; L_1008_2520Metric
LS1: CMS-15113-078SP; CMS-15113-078S
MK1: DOM-3027L-HD-R
Q1, Q2, Q8, Q10, Q11, Q12, Q13, Q17, Q19, Q27, Q28, Q29: BSS138P; SOT-23_Handsoldering
Q3: MMBT2222A; SOT-23_Handsoldering
Q4: BFU520W; SOT-23_Handsoldering
Q5: DZT2222A; SOT-223-3_TabPin2
Q6, Q7: PD85004; SOT-89-3_Handsoldering
Q9, Q14, Q22: Si4909DY; SO-8_3.9x4.9mm_P1.27mm
Q15: BCP52; SOT-223-3_TabPin2
Q16, Q24, Q26: 2SB1198K; SOT-23_Handsoldering
Q18, Q21: DMP3099L; SOT-23_Handsoldering
Q20, Q23, Q25: 2SC2412K; SOT-23_Handsoldering
R1, R20, R46, R59, R60, R61, R62, R63, R64, R65, R66, R67, R68, R69, R70, R84, R85, R96, R134, R136: 10K; R_0805_2012Metric_Pad1.15x1.40mm_HandSolder
R2, R4, R21, R22: 100R; R_0805_2012Metric_Pad1.15x1.40mm_HandSolder
R3, R83, R86: 68R; R_0805_2012Metric_Pad1.15x1.40mm_HandSolder
R5: 51R; R_0805_2012Metric_Pad1.15x1.40mm_HandSolder
R6, R7, R26, R27, R28, R29, R38, R40, R41, R43, R44, R45, R87, R88: 1K 1%; R_0805_2012Metric_Pad1.15x1.40mm_HandSolder
R8, R9, R10, R11, R12, R13, R14, R15, R110, R111, R112: 10K 1%; R_0805_2012Metric_Pad1.15x1.40mm_HandSolder
R16, R17, R18, R19, R34, R35, R36, R37, R47, R48: 100R 1%; R_0805_2012Metric_Pad1.15x1.40mm_HandSolder
R23, R49, R95, R101, R102, R103, R104, R105, R117, R118, R125, R126, R127, R128, R139, R140: 47K; R_0805_2012Metric_Pad1.15x1.40mm_HandSolder
R24, R25, R76, R119, R120, R121, R122, R123, R124: 22R; R_0805_2012Metric_Pad1.15x1.40mm_HandSolder
R30, R31, R32, R33: 820R 1%; R_0805_2012Metric_Pad1.15x1.40mm_HandSolder
R39, R42: 10R 1%; R_0805_2012Metric_Pad1.15x1.40mm_HandSolder
R50, R55, R94: 2.2K; R_0805_2012Metric_Pad1.15x1.40mm_HandSolder
R51, R71, R78, R80: 1.8K; R_0805_2012Metric_Pad1.15x1.40mm_HandSolder
R52: 180R; R_0805_2012Metric_Pad1.15x1.40mm_HandSolder
R53, R75: 47R; R_0805_2012Metric_Pad1.15x1.40mm_HandSolder
R54: 18R; R_0805_2012Metric_Pad1.15x1.40mm_HandSolder
R56, R91, R92, R97, R98, R99, R100, R129, R130, R131, R132, R133, R137, R138: 4.3K; R_0805_2012Metric_Pad1.15x1.40mm_HandSolder
R57: 150R; R_0805_2012Metric_Pad1.15x1.40mm_HandSolder
R58, R162, R163, R164, R171, R172: 470R; R_0805_2012Metric_Pad1.15x1.40mm_HandSolder
R72: 15K; R_0805_2012Metric_Pad1.15x1.40mm_HandSolder
R73: 160R; R_0805_2012Metric_Pad1.15x1.40mm_HandSolder
R74: 4.7R; R_0805_2012Metric_Pad1.15x1.40mm_HandSolder
R77, R79, R107, R109, R154, R155, R156, R157, R160, R161: 1K; R_0805_2012Metric_Pad1.15x1.40mm_HandSolder
R81, R82: 100R 0.5W; R_1206_3216Metric_Pad1.42x1.75mm_HandSolder
R89: 8.2K; R_0805_2012Metric_Pad1.15x1.40mm_HandSolder
R90: 6.8K; R_0805_2012Metric_Pad1.15x1.40mm_HandSolder
R93: 0R; R_0805_2012Metric_Pad1.15x1.40mm_HandSolder
R106, R108, R113, R114: 390R; R_0805_2012Metric_Pad1.15x1.40mm_HandSolder
R115: 36K 1%; R_0805_2012Metric_Pad1.15x1.40mm_HandSolder
R116: 68K; R_0805_2012Metric_Pad1.15x1.40mm_HandSolder
R135: 15R 0.25W; R_1206_3216Metric_Pad1.42x1.75mm_HandSolder
R141, R142, R143, R144, R145, R147, R150, R152: 1M; R_0805_2012Metric_Pad1.15x1.40mm_HandSolder
R146, R149, R151: 4.7M; R_0805_2012Metric_Pad1.15x1.40mm_HandSolder
R148, R153, R158: 510K; R_0805_2012Metric_Pad1.15x1.40mm_HandSolder
R159: 3K 1%; R_0805_2012Metric_Pad1.15x1.40mm_HandSolder
R165, R166, R167, R168, R169, R170: 75R 0.25W; R_1206_3216Metric_Pad1.42x1.75mm_HandSolder
R173: 20mR 0.25W 1%; R_1206_3216Metric_Pad1.42x1.75mm_HandSolder
SW1, SW2: EVQP7A; SW_SPST_EVQP7A
T1: BN43-202; BN-43-202-5P
T2: BN43-202; BN43-202-8P
TH1, TH2: CMFB3435103; R_0805_2012Metric_Pad1.15x1.40mm_HandSolder
TP1: 5019; TestPoint_Keystone_5019_Minature
TR1, TR2, TR3: CX2047LANL
U1: Si5351A-B-GT; MSOP-10_3x3mm_P0.5mm
U2: PO74G74A; SOIC-14_3.9x8.7mm_P1.27mm
U3: AD8604; SOIC-14_3.9x8.7mm_P1.27mm
U4: AD8618; SOIC-14_3.9x8.7mm_P1.27mm
U5, U8, U11, U13: SN74CBT3253C; SOIC-16_3.9x9.9mm_P1.27mm
U6: LT6237; MSOP-8_3x3mm_P0.65mm
U7: LT6238; SSOP-16_3.9x4.9mm_P0.635mm
U9: LTC6655CHMS8-2.5; MSOP-8_3x3mm_P0.65mm
U10: SN74HC126P; TSSOP-14_4.4x5mm_P0.65mm
U12, U14: SN74CBT3305C; SO-8_3.9x4.9mm_P1.27mm
U15: AD5243BRMZ; MSOP-10_3x3mm_P0.5mm
U16: ULN2003V12T16-13; TSSOP-16_4.4x5mm_P0.65mm
U17, U18: LTC5507; SOT-23-6_Handsoldering
U19: TCA0372BDW; SOIC-16W_7.5x10.3mm_P1.27mm
U20: WM8731; SSOP-28_5.3x10.2mm_P0.65mm
U21, U22: 74HC4066PW; TSSOP-14_4.4x5mm_P0.65mm
U23: SN74HC00P; TSSOP-14_4.4x5mm_P0.65mm
U24: STM32F413RHTx; LQFP-64_10x10mm_P0.5mm
U25: M24C64-RDW; SOIC-8_3.9x4.9mm_P1.27mm
U26, U27: NUP4202; SOT-363_SC-70-6
U28: SN74HC595P; TSSOP-16_4.4x5mm_P0.65mm
U29, U30, U31, U32, U33: LF50ABPT; PPAK
U34, U35, U36: LF33CPT; PPAK
U37, U38, U39: S-8209A; TSSOP-8_4.4x3mm_P0.65mm
U40: INA300; VSSOP-10_3x3mm_P0.5mm
U41: S-812C50A; SOT-89-3_Handsoldering
X1: ASTX-H11-27.000MHZ; Oscillator_SMD_Abracon_ASE-4Pin_3.2x2.5mm_HandSoldering
Y1: J49SML-A-G-G-K-24M0; Crystal_SMD_HC49-SD
Y2: MS3V-T1R-32.768KHZ-12.5PF; Crystal_SMD_MicroCrystal_MS3V-T1R

Connections:
+3.3V: C92.1, C210.1, C212.1, C216.1, C219.1, C229.1, C231.1, C239.1, C240.1, C242.1, C243.1, C244.1, C245.1, C246.1, C247.1, C255.1, C256.1, C257.1, C259.1, C269.1, C271.1, C291.1, D2.1, DS1.1, J9.4, R61.2, R62.2, R96.2, R104.2, R105.1, R107.1, R109.1, R117.2, U10.14, U20.1, U20.27, U21.14, U22.14, U23.14, U24.19, U24.32, U24.48, U24.64, U25.8, U27.5, U28.10, U28.16, U35.5
+3.3V-RF: C1.1, C2.1, C4.1, C5.1, C6.1, C7.1, C8.1, C292.1, R1.1, U1.1, U1.7, U2.1, U2.4, U2.10, U2.13, U2.14, U34.5, X1.4
+3.3VA: C201.1, C202.1, C203.1, C204.1, C205.1, C206.1, C224.1, C225.1, C227.1, C230.1, C254.1, C258.1, C260.1, C293.1, R84.1, R85.1, R111.1, R112.1, U17.4, U18.4, U20.8, U20.14, U24.13, U36.5
+5.0V-BL: C238.1, C241.1, C274.1, DS1.17, DS1.18, U31.5
+5.0V-RF: C78.1, C79.1, C80.1, C81.1, C118.1, C119.1, C120.1, C121.1, C122.1, C123.1, C124.1, C125.1, C290.1, R63.2, R65.2, R67.2, R69.2, U11.16, U12.8, U13.16, U14.8, U33.5
+5.0V-RX: C26.1, C27.1, C28.1, C31.1, C32.1, C33.1, C48.1, C52.1, C54.1, C55.1, C56.1, C68.1, C70.1, C71.1, C273.1, L5.1, R44.1, R46.1, R56.1, U6.8, U7.4, U8.16, U9.1, U9.2, U30.5
+5.0V-TX: C14.1, C15.1, C16.1, C17.1, C20.1, C21.1, C22.1, C23.1, C59.1, C60.1, C62.1, C127.1, C129.1, C137.1, C140.1, C141.1, C272.1, L3.1, R6.1, R20.1, R51.1, U3.4, U4.4, U5.16, U15.2, U15.5, U15.8, U29.5
+5.0V-USB: C268.2, C275.1, J10.1, R118.2, U26.5, U32.5
+12V: C220.1, C221.1, C289.1, Q9.5, Q9.6, R87.1, U19.1
+12V-RF: C162.1, C163.1, C288.1, K1.1, K2.1, K3.1, K4.1, K5.1, K6.1, K7.1, Q18.3, U16.9
+12V-TX: C130.1, C132.1, C133.1, C150.2, C151.2, C152.2, C153.2, C155.1, C156.1, C158.1, C160.1, C161.1, C276.1, L35.1, Q9.7, Q9.8, R71.1, R81.2, R82.2, T1.2
/BPF/B2#RX: R61.1, U10.8, U11.1, U13.1
/BPF/B2#TX: R62.1, U10.11, U11.15, U13.15
/BPF/B2RX: R59.1, U10.3, U12.1, U14.1
/BPF/B2TX: R60.1, U10.6, U12.7, U14.7
/BPF/BAND0: U11.14, U13.14, U16.1, U16.4, U28.15
/BPF/BAND1: U11.2, U13.2, U16.2, U16.5, U28.1
/BPF/BAND2: U10.2, U10.5, U10.9, U10.12, U16.3, U16.6, U28.2
/BPF/RX-EN: Q2.1, R49.1, U10.1, U10.10, U21.12, U21.13, U23.6
/BPF/RX-IN: C200.2, L34.2, U13.7, U14.2
/BPF/TX-EN: Q1.1, R23.1, R102.2, U10.4, U10.13, U16.7, U21.5, U21.6, U22.5, U22.6, U23.12, U23.13, U24.8
/Battery/+5V: C298.1, C304.1, R158.2, U40.4, U40.7, U40.9, U41.3
/Battery/BAT-A: D5.1, Q21.2, R142.1
/Battery/~UNPLUG: C294.1, J1.3, R158.1, U40.6
/Codec/BIAS: C209.1, C211.1, C213.1, R87.2, R88.1, U19.8, U19.9
/Codec/EXT-MIC: Q8.1, R101.1, U22.13, U28.7
/Codec/HP: C215.2, J4.R, J4.T
/Codec/INP-I: C24.1, U21.1
/Codec/INP-Q: C25.1, U21.11
/Codec/LIN-L: J5.T, R100.1
/Codec/LIN-R: J5.R, R99.1
/Codec/LRCK: U20.5, U20.7, U24.33
/Codec/MCLK: U20.25, U24.37
/Codec/MIC: J6.R, J6.T, U22.2
/Codec/SCL: R109.2, U1.4, U15.6, U20.24, U24.58, U25.6
/Codec/SCLK: U20.3, U24.34
/Codec/SD: U20.4, U24.36
/Codec/SDA: R107.2, U1.5, U15.7, U20.23, U24.59, U25.5
/Codec/SDEXT: U20.6, U24.35
/Detector/BIAS: C43.1, C44.1, C46.1, C47.1, C50.1, C51.1, C53.1, R28.1, R29.1, U9.6, U9.7
/Detector/F00: U2.9, U8.14
/Detector/F90: U2.6, U8.2
/Detector/INP-000: C34.1, C38.1, U7.5, U8.6, U8.13
/Detector/INP-090: C36.1, C40.1, U7.14, U8.5, U8.12
/Detector/INP-180: C35.2, C39.2, U7.3, U8.3, U8.10
/Detector/INP-270: C37.2, C41.2, U7.12, U8.4, U8.11
/Detector/OFFS: C42.1, C45.1, C49.1, R44.2, R45.1, TR2.2
/LNA/IN: C72.1, L33.2, U11.7, U12.2
/LNA/OUT: C75.2, TR2.6
/LPF/ANT: J7.1, K6.3
/LPF/B0IREL: K3.8, U16.16
/LPF/B0OREL: K4.8, U16.13
/LPF/B1IREL: K2.8, U16.15
/LPF/B2IREL: K1.8, U16.14
/LPF/B2OREL: K7.8, U16.11
/LPF/B10REL: K5.8, U16.12
/LPF/TXREL: K6.8, U16.10
/MCU/BAT: C277.1, C278.1, C279.1, C280.1, C281.1, C282.1, C283.1, C284.1, C285.1, C286.1, C287.1, D8.1, Q9.1, Q9.3, Q14.5, Q14.6, Q18.2, Q22.1, R115.2, R129.1, R130.1, R131.1, R132.1, R135.1, R137.1, R138.1, R143.1, U29.1, U30.1, U31.1, U32.1, U33.1, U34.1, U35.1, U36.1
/MCU/BL-PWR: Q12.1, R127.1, U28.5
/MCU/DAH: C266.1, R123.1, U24.38, U27.3
/MCU/DIT: C267.1, R124.1, U24.39, U27.1
/MCU/EXT-CLK: U24.26, U28.11
/MCU/EXT-DATA: U24.61, U28.14
/MCU/EXT-EN#: R117.1, U24.29, U28.13
/MCU/EXT-LAT: U24.28, U28.12
/MCU/FWD: R113.2, U18.3
/MCU/P-DAH: J2.R, R123.2
/MCU/P-DIT: J2.S, R124.2
/MCU/PTT: J3.1, R122.2
/MCU/PTT-BTN: C270.1, R122.1, SW2.1, U24.40, U27.4
/MCU/PWR-BTN: D4.2, SW1.1, U24.10
/MCU/PWR-HLD: D4.1, U24.2
/MCU/PWR-HOLD: D4.3, Q9.4, R138.2, U35.2, U36.2
/MCU/REV: R114.2, U17.3
/MCU/RX-PWR: Q11.1, Q17.1, R126.1, R139.1, U28.4
/MCU/SD-CK: J9.5, U24.53
/MCU/SD-CMD: J9.3, U24.54
/MCU/SD-D0: J9.7, U24.56
/MCU/SD-D1: J9.8, U24.41
/MCU/SD-D2: J9.1, U24.51
/MCU/SD-D3: J9.2, U24.57
/MCU/SD-DET: J9.9, U24.55
/MCU/SWCLK: J8.2, U24.49
/MCU/SWDIO: J8.3, U24.46
/MCU/TH: C154.1, C265.1, R112.2, TH1.1, U24.14
/MCU/TL: C159.1, C262.1, R111.2, TH2.1, U24.15
/MCU/TX-PWR: Q10.1, Q19.1, R125.1, R140.1, U28.3
/MCU/UI-CLK: DS1.3, U24.27
/MCU/UI-INT: DS1.7, U24.62
/MCU/UI-IO0: DS1.5, U24.22
/MCU/UI-IO1: DS1.4, U24.23
/MCU/UI-IO2: DS1.11, U24.24
/MCU/UI-IO3: DS1.12, U24.25
/MCU/UI-NCS: DS1.6, U24.52
/MCU/USB-DM: R120.1, U24.44, U26.6
/MCU/USB-DP: R119.1, U24.45, U26.3
/MCU/USB-ID: R121.1, U24.43, U26.1
/MCU/USB-PWR: Q13.1, R128.1, U28.6
/MCU/USB-VB: R116.2, R118.1, U24.42
/Modulator/BIAS: C9.1, C10.1, C11.1, R6.2, R7.1, U3.3, U3.5, U3.10, U3.12
/Modulator/F00: U2.2, U2.8, U5.14
/Modulator/F90: U2.5, U2.12, U5.2
/Modulator/I+: C18.1, R16.2, U4.6
/Modulator/I-: C18.2, R17.2, U4.2
/Modulator/INP-I: C12.2, U22.3
/Modulator/INP-Q: C13.2, U22.9
/Modulator/Q+: C19.1, R18.2, U4.13
/Modulator/Q-: C19.2, R19.2, U4.9
/PSU/VIN: J1.1, Q14.7, Q14.8
/Power amplifier/BIASH: C139.2, C144.1, C145.1, R78.2, U15.10
/Power amplifier/BIASL: C135.2, C146.1, C147.1, R80.2, U15.3
/Power amplifier/IN: C131.1, L32.2, U13.9, U14.5
/Power amplifier/OUT: C157.2, K1.3, K1.6
/Preamplifier/IN: C61.1, TR1.6
/Preamplifier/OUT: C64.2, L31.2, U11.9, U12.5
/SWR meter/IN: K7.3, K7.6, T2.2
/SWR meter/OUT: C199.2, T2.7, T2.8
GND: BT1.2, C1.2, C2.2, C4.2, C5.2, C6.2, C7.2, C8.2, C9.2, C10.2, C11.2, C14.2, C15.2, C16.2, C17.2, C20.2, C21.2, C22.2, C23.2, C26.2, C27.2, C28.2, C31.2, C32.2, C33.2, C34.2, C35.1, C36.2, C37.1, C38.2, C39.1, C40.2, C41.1, C42.2, C43.2, C44.2, C45.2, C46.2, C47.2, C48.2, C49.2, C50.2, C51.2, C52.2, C53.2, C54.2, C55.2, C56.2, C57.2, C58.2, C59.2, C60.2, C62.2, C66.2, C67.2, C68.2, C69.2, C70.2, C71.2, C74.2, C76.2, C77.2, C78.2, C79.2, C80.2, C81.2, C87.2, C88.2, C89.2, C90.2, C91.2, C92.2, C98.2, C99.2, C100.2, C101.2, C102.2, C108.2, C109.2, C110.2, C111.2, C112.2, C118.2, C119.2, C120.2, C121.2, C122.2, C123.2, C124.2, C125.2, C126.2, C127.2, C128.2, C129.2, C130.2, C132.2, C133.2, C135.1, C137.2, C139.1, C140.2, C141.2, C144.2, C145.2, C146.2, C147.2, C150.1, C151.1, C152.1, C153.1, C154.2, C155.2, C156.2, C158.2, C159.2, C160.2, C161.2, C162.2, C163.2, C164.2, C165.2, C166.2, C167.2, C168.2, C174.2, C175.2, C176.2, C177.2, C178.2, C184.2, C185.2, C186.2, C187.2, C188.2, C194.2, C195.2, C196.2, C197.2, C198.2, C201.2, C202.2, C203.2, C204.2, C209.2, C210.2, C211.2, C212.2, C213.2, C216.2, C219.2, C220.2, C221.2, C224.2, C225.2, C226.2, C227.2, C228.2, C229.2, C230.2, C231.2, C233.2, C236.2, C237.2, C238.2, C239.2, C240.2, C241.2, C242.2, C243.2, C244.2, C245.2, C246.2, C247.2, C248.2, C249.2, C250.2, C251.1, C252.1, C253.2, C254.2, C255.2, C256.2, C257.2, C258.2, C259.2, C260.2, C261.2, C262.2, C263.2, C264.2, C265.2, C266.2, C267.2, C268.1, C269.2, C270.2, C271.2, C272.2, C273.2, C274.2, C275.2, C276.2, C277.2, C278.2, C279.2, C280.2, C281.2, C282.2, C283.2, C284.2, C285.2, C286.2, C287.2, C288.2, C289.2, C290.2, C291.2, C292.2, C293.2, C294.2, C298.2, C303.2, C304.2, D1.2, D3.1, D7.2, DS1.2, DS1.19, DS1.20, J1.2, J2.T, J3.2, J4.S, J5.S, J6.S, J7.2, J8.1, J9.6, J9.10, J9.11, J10.5, J10.6, K6.6, L6.2, L7.2, L8.2, L9.2, L10.2, L16.2, L17.2, L18.2, L19.2, L20.2, L26.2, L27.2, L28.2, L29.2, L30.2, LS1.1, MK1.1, Q1.2, Q2.2, Q6.2, Q7.2, Q8.2, Q10.2, Q11.2, Q12.2, Q13.2, Q17.2, Q19.2, Q20.2, Q23.2, Q25.2, R2.1, R4.1, R5.1, R7.2, R23.2, R45.2, R49.2, R50.2, R53.2, R54.2, R55.2, R57.2, R59.2, R60.2, R64.2, R66.2, R68.2, R70.2, R75.2, R76.2, R83.2, R86.1, R88.2, R95.2, R97.2, R98.2, R101.2, R102.1, R103.1, R110.2, R116.1, R125.2, R126.2, R127.2, R128.2, R133.2, R136.2, R139.2, R140.2, R141.2, R145.2, R150.2, R154.2, R157.2, R159.1, R172.1, R173.2, SW1.2, SW2.2, T1.4, T2.1, T2.5, TH1.2, TH2.2, TP1.1, TR1.4, TR2.4, TR3.2, TR3.6, U1.8, U2.7, U3.11, U4.11, U5.8, U6.4, U7.13, U8.8, U9.3, U9.4, U9.5, U9.8, U10.7, U11.8, U12.4, U13.8, U14.4, U15.1, U15.4, U15.9, U16.8, U17.2, U18.2, U19.4, U19.5, U19.12, U19.13, U20.11, U20.15, U20.21, U20.22, U20.28, U21.7, U22.7, U23.1, U23.2, U23.7, U24.12, U24.18, U24.31, U24.47, U24.60, U24.63, U25.1, U25.2, U25.3, U25.4, U25.7, U26.2, U27.2, U28.8, U29.3, U30.3, U31.3, U32.3, U33.3, U34.3, U35.3, U36.3, U40.8, U41.1, X1.2
unnamed: BT1.1, C253.1, R106.2, U24.1
unnamed: BT2.1, C303.1, F1.1, R162.1, R165.1, R168.1, U41.2
unnamed: BT2.2, BT3.1, C295.2, C299.2, Q27.2, R163.1, R166.1, R169.1, U37.5
unnamed: BT3.2, BT4.1, C296.2, C300.2, Q28.2, R164.1, R167.1, R170.1, U38.5
unnamed: BT4.2, C297.2, C301.2, Q29.2, R171.1, R173.1, U39.5
unnamed: C3.1, U1.2
unnamed: C3.2, R3.2, R4.2
unnamed: C12.1, R8.1
unnamed: C13.1, R9.1
unnamed: C24.2, R24.1
unnamed: C25.2, R25.1
unnamed: C29.1, R30.2, R34.1
unnamed: C29.2, R31.2, R35.1
unnamed: C30.1, R32.2, R36.1
unnamed: C30.2, R33.2, R37.1
unnamed: C57.1, C58.1, L1.1, R50.1, R51.2
unnamed: C61.2, Q3.1, R52.2
unnamed: C63.1, L2.2
unnamed: C63.2, C64.1, L3.2, Q3.3
unnamed: C65.1, Q3.2, R53.1
unnamed: C65.2, R54.1
unnamed: C66.1, C67.1, C69.1, L4.1, R55.1, R56.2
unnamed: C72.2, L4.2, Q4.1, R58.2
unnamed: C73.1, R58.1
unnamed: C73.2, C75.1, L5.2, Q4.3
unnamed: C74.1, C76.1, C77.1, Q4.2, R57.1
unnamed: C82.1, U11.6, U11.10
unnamed: C82.2, C87.1, L6.1, L11.1
unnamed: C83.1, U11.5, U11.11
unnamed: C83.2, C88.1, L7.1, L12.1
unnamed: C84.1, U11.4, U11.12
unnamed: C84.2, C89.1, L8.1, L13.1
unnamed: C85.1, U11.3, U11.13
unnamed: C85.2, C90.1, L9.1, L14.1
unnamed: C86.1, U12.3, U12.6
unnamed: C86.2, C91.1, L10.1, L15.1
unnamed: C93.1, L11.2
unnamed: C93.2, C98.1, L16.1, L21.1
unnamed: C94.1, L12.2
unnamed: C94.2, C99.1, L17.1, L22.1
unnamed: C95.1, L13.2
unnamed: C96.1, L14.2
unnamed: C97.1, L15.2
unnamed: C95.2, C100.1, L18.1, L23.1
unnamed: C96.2, C101.1, L19.1, L24.1
unnamed: C97.2, C102.1, L20.1, L25.1
unnamed: C103.1, L21.2
unnamed: C103.2, C108.1, C113.1, L26.1
unnamed: C104.1, L22.2
unnamed: C104.2, C109.1, C114.1, L27.1
unnamed: C105.1, L23.2
unnamed: C105.2, C110.1, C115.1, L28.1
unnamed: C106.1, L24.2
unnamed: C106.2, C111.1, C116.1, L29.1
unnamed: C107.1, L25.2
unnamed: C107.2, C112.1, C117.1, L30.1
unnamed: C113.2, U13.6, U13.10
unnamed: C114.2, U13.5, U13.11
unnamed: C115.2, U13.4, U13.12
unnamed: C116.2, U13.3, U13.13
unnamed: C117.2, U14.3, U14.6
unnamed: C126.1, C128.1, D1.1, R71.2, R72.2
unnamed: C131.2, Q5.1, R73.2
unnamed: C134.1, R74.1
unnamed: C134.2, C136.1, L35.2, Q5.2
unnamed: C136.2, TR3.4
unnamed: C138.1, Q5.3, R75.1
unnamed: C138.2, R76.1
unnamed: C142.1, TR3.3
unnamed: C142.2, Q6.1, R77.2, R78.1
unnamed: C143.1, TR3.1
unnamed: C143.2, Q7.1, R79.2, R80.1
unnamed: C148.1, L36.2
unnamed: C148.2, Q6.3, R81.1, T1.1
unnamed: C149.1, L37.2
unnamed: C149.2, Q7.3, R82.1, T1.3
unnamed: C157.1, T1.5
unnamed: C164.1, C169.1, K3.2, L38.1
unnamed: C165.1, C170.1, K3.4, L39.1
unnamed: C166.1, C171.1, K3.7, L40.1
unnamed: C167.1, C172.1, K3.5, L41.1
unnamed: C168.1, C173.1, K1.4, K1.5, L42.1
unnamed: C169.2, C174.1, C179.1, L38.2, L43.1
unnamed: C170.2, C175.1, C180.1, L39.2, L44.1
unnamed: C171.2, C176.1, C181.1, L40.2, L45.1
unnamed: C172.2, C177.1, C182.1, L41.2, L46.1
unnamed: C173.2, C178.1, C183.1, L42.2, L47.1
unnamed: C179.2, C184.1, C189.1, L43.2, L48.1
unnamed: C180.2, C185.1, C190.1, L44.2, L49.1
unnamed: C181.2, C186.1, C191.1, L45.2, L50.1
unnamed: C182.2, C187.1, C192.1, L46.2, L51.1
unnamed: C183.2, C188.1, C193.1, L47.2, L52.1
unnamed: C189.2, C194.1, K4.2, L48.2
unnamed: C190.2, C195.1, K4.4, L49.2
unnamed: C191.2, C196.1, K4.7, L50.2
unnamed: C192.2, C197.1, K4.5, L51.2
unnamed: C193.2, C198.1, K7.4, K7.5, L52.2
unnamed: C199.1, K6.4
unnamed: C200.1, K6.2, K6.5
unnamed: C205.2, U17.5
unnamed: C206.2, U18.5
unnamed: C207.1, U17.6
unnamed: C207.2, R83.1, T2.4
unnamed: C208.1, U18.6
unnamed: C208.2, R86.2, T2.3, T2.6
unnamed: C214.1, C217.1, R89.2, U19.2
unnamed: C214.2, LS1.2
unnamed: C215.1, C218.1, R90.2, U19.16
unnamed: C217.2, R89.1, R91.2, U19.7
unnamed: C218.2, R90.1, R92.2, U19.10
unnamed: C222.1, R91.1
unnamed: C222.2, U20.9
unnamed: C223.1, R92.1
unnamed: C223.2, U20.10
unnamed: C226.1, C228.1, U20.16
unnamed: C232.1, R93.1
unnamed: C232.2, C233.1, R94.1, R95.1, U22.1, U22.11
unnamed: C234.1, U21.4
unnamed: C234.2, C236.1, R97.1, R99.2
unnamed: C235.1, U21.8
unnamed: C235.2, C237.1, R98.1, R100.2
unnamed: C248.1, U24.5, Y1.2
unnamed: C249.1, U24.6, Y1.1
unnamed: C250.1, U24.30
unnamed: C251.2, U24.3, Y2.1
unnamed: C252.2, U24.4, Y2.2
unnamed: C261.1, R114.1, U24.17
unnamed: C263.1, R113.1, U24.16
unnamed: C264.1, R110.1, R115.1, U24.20
unnamed: C295.1, U37.4
unnamed: C296.1, U38.4
unnamed: C297.1, U39.4
unnamed: C299.1, R162.2, U37.3
unnamed: C300.1, R163.2, U38.3
unnamed: C301.1, R164.2, U39.3
unnamed: C302.1, R171.2, U40.1
unnamed: C302.2, R172.2, U40.2
unnamed: D2.3, R106.1
unnamed: D3.2, R108.2
unnamed: D5.2, Q15.2
unnamed: D6.1, Q14.1, Q14.3, Q16.2
unnamed: D6.2, Q14.2, Q14.4, Q16.3, R136.1
unnamed: D7.1, R134.2
unnamed: D8.2, Q15.1, R133.1
unnamed: DS1.8, R104.1
unnamed: F1.2, Q22.3, Q24.2, Q26.2, R144.1, R147.1, R152.1
unnamed: J10.2, R120.2
unnamed: J10.3, R119.2
unnamed: J10.4, R121.2
unnamed: K1.2, K1.7, K2.3, K2.6
unnamed: K2.2, K2.7, K3.3
unnamed: K2.4, K2.5, K3.6
unnamed: K4.3, K5.2, K5.7
unnamed: K4.6, K5.4, K5.5
unnamed: K5.3, K5.6, K7.2, K7.7
unnamed: L1.2, L2.1, R52.1
unnamed: L31.1, R63.1, R64.1
unnamed: L32.1, R65.1, R66.1
unnamed: L33.1, R67.1, R68.1
unnamed: L34.1, R69.1, R70.1
unnamed: L36.1, R77.1
unnamed: L37.1, R79.1
unnamed: MK1.2, U22.10
unnamed: Q1.3, R20.2, U5.1, U5.15
unnamed: Q2.3, R46.2, U8.1, U8.15
unnamed: Q8.3, R96.1, U22.12
unnamed: Q9.2, Q10.3, R129.2, U29.2
unnamed: Q11.3, R130.2, U30.2
unnamed: Q12.3, R131.2, U31.2
unnamed: Q13.3, R132.2, U32.2
unnamed: Q15.3, R135.2
unnamed: Q16.1, R134.1
unnamed: Q17.3, Q18.1, Q19.3, R137.2, U33.2, U34.2
unnamed: Q20.1, R141.1, R151.2, U40.5
unnamed: Q20.3, Q22.2, R143.2
unnamed: Q21.1, Q25.3, R142.2
unnamed: Q21.3, Q22.5, Q22.6, Q22.7, Q22.8
unnamed: Q22.4, Q23.3, R144.2
unnamed: Q23.1, R145.1, R146.2
unnamed: Q24.1, R147.2, R148.1
unnamed: Q24.3, R146.1
unnamed: Q25.1, R149.2, R150.1
unnamed: Q26.1, R152.2, R153.1
unnamed: Q26.3, R149.1, R151.1
unnamed: Q27.1, U37.8
unnamed: Q27.3, R165.2, R168.2
unnamed: Q28.1, U38.8
unnamed: Q28.3, R166.2, R169.2
unnamed: Q29.1, U39.8
unnamed: Q29.3, R167.2, R170.2
unnamed: R1.2, X1.1
unnamed: R2.2, R3.1, X1.3
unnamed: R5.2, U1.10, U2.3, U2.11
unnamed: R8.2, R10.1, U3.2
unnamed: R10.2, R12.1, R16.1, U3.1
unnamed: R9.2, R11.1, U3.13
unnamed: R11.2, R13.1, R18.1, U3.14
unnamed: R12.2, R14.1, U3.6
unnamed: R13.2, R15.1, U3.9
unnamed: R14.2, R17.1, U3.7
unnamed: R15.2, R19.1, U3.8
unnamed: R21.1, U5.7
unnamed: R21.2, TR1.1
unnamed: R22.1, U5.9
unnamed: R22.2, TR1.3
unnamed: R24.2, R26.1, U6.1
unnamed: R25.2, R27.1, U6.7
unnamed: R26.2, R30.1, U6.2
unnamed: R27.2, R32.1, U6.6
unnamed: R28.2, R31.1, U6.3
unnamed: R29.2, R33.1, U6.5
unnamed: R34.2, R41.2, U7.7
unnamed: R35.2, R43.1, U7.1
unnamed: R36.2, R38.2, U7.16
unnamed: R37.2, R40.1, U7.10
unnamed: R38.1, R39.2, U7.15
unnamed: R39.1, R40.2, U7.11
unnamed: R41.1, R42.2, U7.6
unnamed: R42.1, R43.2, U7.2
unnamed: R47.1, U8.7
unnamed: R47.2, TR2.1
unnamed: R48.1, U8.9
unnamed: R48.2, TR2.3
unnamed: R72.1, R73.1, R74.2
unnamed: R84.2, U17.1
unnamed: R85.2, U18.1
unnamed: R93.2, U20.18
unnamed: R94.2, U20.17
unnamed: R103.2, U23.9, U24.9
unnamed: R105.2, U24.7
unnamed: R108.1, U24.21
unnamed: R148.2, U37.6
unnamed: R153.2, U37.7
unnamed: R154.1, U39.1
unnamed: R155.1, U37.2
unnamed: R155.2, U38.6
unnamed: R156.1, U38.2
unnamed: R156.2, U39.6
unnamed: R157.1, U39.2
unnamed: R159.2, U40.3
unnamed: R160.1, U37.1
unnamed: R160.2, U38.7
unnamed: R161.1, U38.1
unnamed: R161.2, U39.7
unnamed: U4.1, U4.3, U5.3, U5.10
unnamed: U4.5, U4.7, U5.6, U5.13
unnamed: U4.8, U4.10, U5.4, U5.11
unnamed: U4.12, U4.14, U5.5, U5.12
unnamed: U20.12, U22.8
unnamed: U20.13, U22.4
unnamed: U20.19, U21.2, U21.3
unnamed: U20.20, U21.9, U21.10
unnamed: U23.4, U23.5, U23.8
unnamed: U23.10, U23.11
