andriy-bilynskyy/sdr-trx/schematic/mcu-pinout.ioc

Mcu.UserName=STM32F413RHTx
PC10.Signal=SDIO_D2
PC12.Signal=SDIO_CK
PA0.GPIO_Label=V-TH
PC0.GPIO_Label=TX_EN
PC13.GPIO_Label=PWR_HOLD
PB13.Signal=I2S2_CK
PB15.Signal=I2S2_SD
PA12.Signal=USB_OTG_FS_DP
PB6.Signal=I2C1_SCL
PC7.Signal=GPIO_Input
PB2.Signal=GPIO_Output
PB7.Signal=I2C1_SDA
PA8.Signal=SDIO_D1
PA0.Signal=ADCx_IN0
PB9.Signal=GPXTI9
PB1.Signal=QUADSPI_CLK
PA6.Signal=QUADSPI_BK2_IO0
PA2.GPIO_Label=V-FWD
PA10.Signal=USB_OTG_FS_ID
PC5.Signal=QUADSPI_BK2_IO3
PA4.GPIO_Label=V-BAT
PC2.GPIO_Label=PWR_BTN
PB4.Signal=SDIO_D0
PA3.Signal=ADCx_IN3
PB3.GPIO_Label=SDIO_DET
PB9.GPIO_Label=UI-INT
PC9.GPIO_Label=PTT_BTN
PC11.Signal=QUADSPI_BK2_NCS
PC13.Signal=GPIO_Output
PC8.Signal=GPIO_Input
PC2.Signal=GPIO_Input
PC4.Signal=QUADSPI_BK2_IO2
PC6.Signal=I2S2_MCK
PC0.Signal=GPIO_Output
PC14-OSC32_IN.Signal=RCC_OSC32_IN
PC8.GPIO_Label=P_DIT
PA13.Signal=SYS_JTMS-SWDIO
PB10.GPIO_Label=SPI5_EN
PA9.Signal=USB_OTG_FS_VBUS
PC15-OSC32_OUT.Signal=RCC_OSC32_OUT
PA1.Signal=ADCx_IN1
PB10.Signal=GPIO_Output
PB14.Signal=I2S2_ext_SD
PA5.Signal=GPIO_Output
PC1.GPIO_Label=RX_EN
PA1.GPIO_Label=V-TL
PA2.Signal=ADCx_IN2
PC7.GPIO_Label=P_DAH
PB3.Signal=GPIO_Input
PA4.Signal=ADCx_IN4
PB5.Signal=SDIO_D3
PA5.GPIO_Label=LED
PA11.Signal=USB_OTG_FS_DM
PA14.Signal=SYS_JTCK-SWCLK
PB2.GPIO_Label=SPI5_LAT
PB8.Signal=SPI5_MOSI
PC9.Signal=GPIO_Input
PD2.Signal=SDIO_CMD
PB0.Signal=SPI5_SCK
PC1.Signal=GPIO_Output
PB12.Signal=I2S2_WS
PA3.GPIO_Label=V-REV
PA7.Signal=QUADSPI_BK2_IO1
