andriy-bilynskyy/sdr-trx/firmware/app/src/widgets/widget_sensors.c

/*
********************************************************************************
**
**  (C) 2020 Andrii Bilynskyi <andriy.bilynskyy@gmail.com>
**
**  This code is licensed under the GPLv3.
**
********************************************************************************
    Widget sensors source file
*/


#include "widgets.h"
#include "ui_engine.h"
#include "misc_func.h"
#include "adc.h"
#include "rf_unit.h"
#include "dsp_proc.h"
#include <stdbool.h>
#include <string.h>


/* active widgets tags definitions */
#define WIDGET_SENSORS_TAG_EXIT       1
#define WIDGET_SENSORS_TAG_PAON       2
#define WIDGET_SENSORS_TAG_PAVAL      3


static bool widget_sensors_show_errors(volatile app_handle_t * app_handle, rf_unit_state_t state);


void widget_sensors(volatile app_handle_t * app_handle) {

    bool init = true;
    bool touched = false;

    dsp_proc_set(app_handle, dsp_proc_test_routine, dsp_proc_test_set, dsp_proc_test_unset);
    (void)widget_sensors_show_errors(app_handle, rf_unit_start(app_handle));

    for(; app_handle->system_ctive;) {

        char buf[16];
        uint8_t pos;

        ui_engine_draw_start(0, 0, 0);
        ui_engine_set_gradient(0, 0, 0xFF, 0xFF, 0, 0);
        ui_engine_set_fgcolor(31, 31, 255);
        ui_engine_set_color(255, 255, 255);
        /* header */
        ui_engine_button(WIDGET_SENSORS_TAG_EXIT, 5,  5, 20, 20, UI_ENGINE_FONT26, "-");
        ui_engine_text(0,                         30, 0,         UI_ENGINE_FONT29, "Sensors", false);
        /* Battery voltage */
        ui_engine_text(0, 20,  35,  UI_ENGINE_FONT28, "Battery voltage:", false);
        gcvtf(adc_batt_voltage(), 2, buf);
        pos = strlen(buf);
        buf[pos] = 'V';
        buf[pos + 1] = '\0';
        ui_engine_text(0, 300, 35,  UI_ENGINE_FONT28, buf, false);
        /* Temperature 1 */
        ui_engine_text(0, 20,  65, UI_ENGINE_FONT28, "RF LDMOS 1 temperature:", false);
        gcvtf(adc_temperature1(), 1, buf);
        pos = strlen(buf);
        buf[pos] = 'C';
        buf[pos + 1] = '\0';
        ui_engine_text(0, 300, 65,  UI_ENGINE_FONT28, buf, false);
        /* Temperature 2 */
        ui_engine_text(0, 20,  95, UI_ENGINE_FONT28, "RF LDMOS 2 temperature:", false);
        gcvtf(adc_temperature2(), 1, buf);
        pos = strlen(buf);
        buf[pos] = 'C';
        buf[pos + 1] = '\0';
        ui_engine_text(0, 300, 95,  UI_ENGINE_FONT28, buf, false);
        /* Output power */
        swr_meter_t power_swr = adc_swr();
        ui_engine_text(0, 20,  125, UI_ENGINE_FONT28, "RF TX power:", false);
        gcvtf(power_swr.power, 2, buf);
        pos = strlen(buf);
        buf[pos] = 'W';
        buf[pos + 1] = '\0';
        ui_engine_text(0, 300, 125, UI_ENGINE_FONT28, buf, false);
        /* SWR */
        ui_engine_text(0, 20,  155, UI_ENGINE_FONT28, "SWR:", false);
        ui_engine_text(0, 300, 155, UI_ENGINE_FONT28, gcvtf(power_swr.swr, 2, buf), false);
        /* RF amp header */
        ui_engine_text(0,                          20,  ui_engine_ysize - 80, UI_ENGINE_FONT28,         "RF power amplifier:", false);
        /* RF amp button */
        ui_engine_button(WIDGET_SENSORS_TAG_PAON,  20,  ui_engine_ysize - 45, 50, 30, UI_ENGINE_FONT28, app_handle->ctl_state->transmission ? "ON" : "OFF");
        /* RF amp slider */
        ui_engine_slider(WIDGET_SENSORS_TAG_PAVAL, 110, ui_engine_ysize - 37, ui_engine_xsize - 140, 15, ((uint32_t)(app_handle->settings->rf_amp_bias - RF_AMP_MIN) * 0xFFFF) / (RF_AMP_MAX - RF_AMP_MIN));

        ui_engine_draw_end();

        uint32_t event_flg = ui_engine_event_wait(WIDGET_EVENT_MASK);
        if(widget_event(app_handle, event_flg)) {
            init = true;
        }
        init = init || widget_sensors_show_errors(app_handle, rf_unit_update_rx_sensitivity(app_handle));

        ui_engine_touch_t touch = ui_engine_get_touch();

        if(init) {
            if(!touch.tag) {
                init = false;
            }
            continue;
        }

        if(!touch.tag) {
            touched = false;
        } else {
            if(!touched) {
                if(touch.tag == WIDGET_SENSORS_TAG_EXIT) {
                    break;
                }
                if(touch.tag == WIDGET_SENSORS_TAG_PAON) {
                    app_handle->ctl_state->transmission = !app_handle->ctl_state->transmission;
                    init = widget_sensors_show_errors(app_handle, rf_unit_update(app_handle));
                }
            }
            if(touch.tag == WIDGET_SENSORS_TAG_PAVAL) {
                app_handle->settings->rf_amp_bias = ((uint32_t)touch.value  * (RF_AMP_MAX - RF_AMP_MIN)) / 0xFFFF + RF_AMP_MIN;
                if(app_handle->ctl_state->transmission) {
                    init = widget_sensors_show_errors(app_handle, rf_unit_update(app_handle));
                }
            }
            touched = true;
        }
    }
    rf_unit_stop(app_handle);
    dsp_proc_set(app_handle, NULL, NULL, NULL);
}

static bool widget_sensors_show_errors(volatile app_handle_t * app_handle, rf_unit_state_t state) {

    bool result = false;
    switch(state) {
    case RF_UNIT_DCO_ERROR:
        widget_error_dco(app_handle);
        result =  true;
        break;
    case RF_UNIT_FILTER_ERROR:
        widget_error_filters(app_handle);
        result =  true;
        break;
    case RF_UNIT_RF_AMP_ERROR:
        widget_error_rf_amp(app_handle);
        result =  true;
        break;
    case RF_UNIT_CODEC_ERROR:
        widget_error_codec(app_handle);
        result = true;
        break;
    default:
        break;
    }
    return result;
}
