andriy-bilynskyy/sdr-trx/firmware/app/src/widgets/widget_sensors.h

/*
********************************************************************************
**
**  (C) 2020 Andrii Bilynskyi <andriy.bilynskyy@gmail.com>
**
**  This code is licensed under the GPLv3.
**
********************************************************************************
    Widget sensors header file
*/

#ifndef __WIDGET_SENSORS_H
#define __WIDGET_SENSORS_H


#include "app_data_types.h"


void widget_sensors(volatile app_handle_t * app_handle);


#endif
