andriy-bilynskyy/sdr-trx/firmware/app/src/widgets/widget_main.h

/*
********************************************************************************
**
**  (C) 2020 Andrii Bilynskyi <andriy.bilynskyy@gmail.com>
**
**  This code is licensed under the GPLv3.
**
********************************************************************************
    Widget main header file
*/

#ifndef __WIDGET_MAIN_H
#define __WIDGET_MAIN_H


#include "app_data_types.h"


void widget_main(volatile app_handle_t * app_handle);


#endif
