andriy-bilynskyy/sdr-trx/firmware/app/src/widgets/widgets.h

/*
********************************************************************************
**
**  (C) 2020 Andrii Bilynskyi <andriy.bilynskyy@gmail.com>
**
**  This code is licensed under the GPLv3.
**
********************************************************************************
    Widgets header file
*/

#ifndef __WIDGETS_H
#define __WIDGETS_H


#include "widget_event.h"
#include "widget_pwr_menu.h"
#include "widget_sw_version.h"
#include "widget_errors.h"
#include "widget_main.h"
#include "widget_date_time.h"
#include "widget_sensors.h"
#include "widget_trx.h"
#include "widget_audio.h"
#include "widget_ui.h"
#include "widget_settings.h"


#endif
