andriy-bilynskyy/sdr-trx/firmware/app/src/widgets/widget_audio.h

/*
********************************************************************************
**
**  (C) 2020 Andrii Bilynskyi <andriy.bilynskyy@gmail.com>
**
**  This code is licensed under the GPLv3.
**
********************************************************************************
    Widget audio header file
*/

#ifndef __WIDGET_AUDIO_H
#define __WIDGET_AUDIO_H


#include "app_data_types.h"


void widget_audio(volatile app_handle_t * app_handle);


#endif
