andriy-bilynskyy/sdr-trx/firmware/app/src/widgets/widget_settings.h

/*
********************************************************************************
**
**  (C) 2020 Andrii Bilynskyi <andriy.bilynskyy@gmail.com>
**
**  This code is licensed under the GPLv3.
**
********************************************************************************
    Widget settings header file
*/

#ifndef __WIDGET_SETTINGS_H
#define __WIDGET_SETTINGS_H


#include "app_data_types.h"


void widget_settings(volatile app_handle_t * app_handle);


#endif
