andriy-bilynskyy/sdr-trx/firmware/app/src/widgets/widget_sw_version.h

/*
********************************************************************************
**
**  (C) 2020 Andrii Bilynskyi <andriy.bilynskyy@gmail.com>
**
**  This code is licensed under the GPLv3.
**
********************************************************************************
    Widget SW version header file
*/

#ifndef __WIDGET_SW_VERSION_H
#define __WIDGET_SW_VERSION_H


#include "app_data_types.h"


void widget_sw_version(volatile app_handle_t * app_handle);


#endif
