andriy-bilynskyy/sdr-trx/firmware/app/src/widgets/widget_trx.h

/*
********************************************************************************
**
**  (C) 2020 Andrii Bilynskyi <andriy.bilynskyy@gmail.com>
**
**  This code is licensed under the GPLv3.
**
********************************************************************************
    Widget transceiver header file
*/

#ifndef __WIDGET_TRX_H
#define __WIDGET_TRX_H


#include "app_data_types.h"


void widget_trx(volatile app_handle_t * app_handle);


#endif
