andriy-bilynskyy/sdr-trx/firmware/app/src/app_data.h

/*
********************************************************************************
**
**  (C) 2020 Andrii Bilynskyi <andriy.bilynskyy@gmail.com>
**
**  This code is licensed under the GPLv3.
**
********************************************************************************
    Application data header file
*/

#ifndef __APP_DATA_H
#define __APP_DATA_H


#include "app_data_types.h"


extern volatile app_handle_t app_handle;


bool app_settings_load(void);
bool app_setting_save(void);


#endif
