andriy-bilynskyy/sdr-trx/firmware/app/src/tasks/task_system.h

/*
********************************************************************************
**
**  (C) 2020 Andrii Bilynskyi <andriy.bilynskyy@gmail.com>
**
**  This code is licensed under the GPLv3.
**
********************************************************************************
    Task system header file
*/

#ifndef __TASK_SYSTEM_H
#define __TASK_SYSTEM_H

#include <stdbool.h>
#include <stdint.h>


void task_system(void * param);


#endif
