andriy-bilynskyy/sdr-trx/firmware/bsp/mem24/mem24_conf.h

/*
********************************************************************************
**
**  (C) 2020 Andrii Bilynskyi <andriy.bilynskyy@gmail.com>
**
**  This code is licensed under the GPLv3.
**
********************************************************************************
    24 series memory driver configuration file
    http://ww1.microchip.com/downloads/en/DeviceDoc/21189T.pdf
*/

#ifndef __MEM24_CONF_H
#define __MEM24_CONF_H


/* memory size bytes */
#define MEM24_SIZE          (8 * 1024)
/* memory page size */
#define MEM24_PAGE_SIZE     32
/* memory page write time, ms */
#define MEM24_PAGE_WR_T     0


#endif
