andriy-bilynskyy/sdr-trx/firmware/app/src/tasks/task_ui.c

/*
********************************************************************************
**
**  (C) 2020 Andrii Bilynskyi <andriy.bilynskyy@gmail.com>
**
**  This code is licensed under the GPLv3.
**
********************************************************************************
    Task UI source file
*/


#include "tasks_app.h"
#include "FreeRTOS.h"
#include "task.h"
#include "atomic.h"
#include "timers.h"
#include "debug.h"
#include "system.h"
#include "led.h"
#include "hwctl.h"
#include "ui_engine.h"
#include "widgets.h"
#include "rtc.h"


#define TASK_UI_BUTTONS_PERIOD_MS       200
#define TASK_UI_BUTTON_SHUTDOWN_MS      2000
#define TASK_UI_ERROR_PERIOD_MS         500


static void task_ui_hw_buttons_check(TimerHandle_t xTimer);


void task_ui(void * param) {

    volatile app_handle_t * app_handle = (app_handle_t *)param;
    (void)Atomic_Increment_u32(&app_handle->running_tasks_cnt);
    DBG_OUT("ui task started");

    led_start();
    bool ui_ok = ui_engine_start();
    if(ui_ok) {
        ui_engine_set_brightness(app_handle->settings->ui_engine_brightness);
    }
    system_hw_key_start();

    TimerHandle_t timer_hw_buttons = xTimerCreate("buttons", TASK_UI_BUTTONS_PERIOD_MS, pdTRUE, param, task_ui_hw_buttons_check);
    (void)xTimerStart(timer_hw_buttons, portMAX_DELAY);

    TickType_t wake_time = xTaskGetTickCount();
    for(; app_handle->system_ctive;) {

        if(ui_ok) {
            widget_main(app_handle);
        } else {
            vTaskDelayUntil(&wake_time, TASK_UI_ERROR_PERIOD_MS);
            led_invert();
        }
    }

    (void)xTimerStop(timer_hw_buttons, portMAX_DELAY);
    (void)xTimerDelete(timer_hw_buttons, portMAX_DELAY);

    system_hw_key_stop();
    ui_engine_stop();
    led_stop();

    DBG_OUT("ui task stopped");
    (void)Atomic_Decrement_u32(&app_handle->running_tasks_cnt);

    vTaskDelete(NULL);
}

void task_ui_notify_low_voltage(void) {

    ui_engine_event_set(WIDGET_EVENT_LOW_BATT);
}

void task_ui_notify_overheat(void) {

    ui_engine_event_set(WIDGET_EVENT_OVER_HEAT);
}

void task_ui_notify_storage_fail(void) {

    ui_engine_event_set(WIDGET_EVENT_STORAGE_FAIL);
}

void task_ui_notify_rtc_fail(void) {

    ui_engine_event_set(WIDGET_EVENT_RTC_FAIL);
}


static void task_ui_hw_buttons_check(TimerHandle_t xTimer) {

    app_handle_t * app_handle = (app_handle_t *)pvTimerGetTimerID(xTimer);
    /* Power button */
    static uint32_t cnt = TASK_UI_BUTTON_SHUTDOWN_MS / TASK_UI_BUTTONS_PERIOD_MS + 1;
    if(system_hw_key_pressed(SYSTEM_HW_KEY_PWR)) {
        if(!cnt) {
            ui_engine_event_set(WIDGET_EVENT_PWR_MENU);
        }
        if(cnt == TASK_UI_BUTTON_SHUTDOWN_MS / TASK_UI_BUTTONS_PERIOD_MS) {
            app_handle->system_ctive = false;
        }
        if(cnt <= TASK_UI_BUTTON_SHUTDOWN_MS / TASK_UI_BUTTONS_PERIOD_MS) {
            cnt ++;
        }
    } else {
        cnt = 0;
    }
    /* PTT button */
    if(app_handle->settings->system_ptt_button == APP_SETTINGS_PTT_HW) {
        static bool ptt_pressed = false;
        if(system_hw_key_pressed(SYSTEM_HW_KEY_PTT)) {
            if(!ptt_pressed) {
                app_handle->ctl_state->transmission = true;
                ui_engine_event_set(WIDGET_EVENT_PTT_CHANGE);
                ptt_pressed = true;
            }
        } else {
            if(ptt_pressed) {
                app_handle->ctl_state->transmission = false;
                ui_engine_event_set(WIDGET_EVENT_PTT_CHANGE);
                ptt_pressed = false;
            }
        }
    }
}
