andriy-bilynskyy/sdr-trx/firmware/app/src/widgets/widget_ui.h

/*
********************************************************************************
**
**  (C) 2020 Andrii Bilynskyi <andriy.bilynskyy@gmail.com>
**
**  This code is licensed under the GPLv3.
**
********************************************************************************
    Widget UI header file
*/

#ifndef __WIDGET_UI_H
#define __WIDGET_UI_H


#include "app_data_types.h"


void widget_ui(volatile app_handle_t * app_handle);


#endif
