andriy-bilynskyy/sdr-trx/firmware/bsp/ui_engine/ui_engine_events.h

/*
********************************************************************************
**
**  (C) 2020 Andrii Bilynskyi <andriy.bilynskyy@gmail.com>
**
**  This code is licensed under the GPLv3.
**
********************************************************************************
    UI engine events definition file
*/

#ifndef __UI_ENGINE_EVENTS_H
#define __UI_ENGINE_EVENTS_H


#include <stdint.h>


#define UI_ENGINE_EVENT_FLAG_TOUCH           (uint32_t)1


#endif
