andriy-bilynskyy/sdr-trx/firmware/bsp/ui_engine/nhd_43_480272ft_ctxl_ctp.h

/*
********************************************************************************
**
**  (C) 2020 Andrii Bilynskyi <andriy.bilynskyy@gmail.com>
**
**  This code is licensed under the GPLv3.
**
********************************************************************************
    NHD-4.3-480272FT-CTXL-CTP display definition file
    https://www.newhavendisplay.com/specs/NHD-4.3-480272FT-CTXL-CTP.pdf
*/

#ifndef __NHD_43_480272FT_CTXL_CTP_H
#define __NHD_43_480272FT_CTXL_CTP_H


#define REG_HSIZE_VALUE       480UL
#define REG_HCYCLE_VALUE      548UL
#define REG_HOFFSET_VALUE     43UL
#define REG_HSYNC0_VALUE      0UL
#define REG_HSYNC1_VALUE      41UL

#define REG_VSIZE_VALUE       272UL
#define REG_VCYCLE_VALUE      292UL
#define REG_VOFFSET_VALUE     12UL
#define REG_VSYNC0_VALUE      0UL
#define REG_VSYNC1_VALUE      10UL

#define REG_PCLK_VALUE        5UL
#define REG_SWIZZLE_VALUE     0UL
#define REG_PCLK_POL_VALUE    1UL
#define REG_CSPREAD_VALUE     1UL
#define REG_DITHER_VALUE      1UL


#endif
