andriy-bilynskyy/sdr-trx/(commit log)

2020-03-27 Add AD9850 demo.
    [jlink.cfg, stm32f1x.cfg]
2020-03-28 Add AD9850 driver.
2020-03-28 Add 2 x AD9850 IQ driver.
2020-04-03 Add output tx circuit.
2020-04-09 Use the same capacitors in all LPFs.
2020-04-10 Use 5V VCC.
2020-04-10 Add 3.3V DDS.
2020-04-10 Initial schematic commit.
    [sdr-trx.kicad_pcb, sdr-trx.sch]
2020-04-21 Add DCO schematic.
    [dco.sch, sdr-trx.sch]
2020-04-21 Add modulator schematic.
    [dco.sch, modulator.sch, sdr-trx.sch]
2020-04-22 Add project footprint library.
2020-04-22 Minor schematic cleanup.
    [dco.sch, modulator.sch]
2020-04-23 Add detector schematic.
    [dco.sch, detector.sch, modulator.sch, sdr-trx.sch]
2020-04-23 Improve insamp reference voltage.
2020-04-23 Update schematic - improve insamp reference voltage.
    [detector.sch]
2020-04-25 Add preamplifier schematic.
    [dco.sch, detector.sch, modulator.sch, preamp.sch, sdr-trx.sch]
2020-04-28 Add LNA.
    [dco.sch, detector.sch, lna.sch, modulator.sch, preamp.sch, sdr-trx.sch]
2020-04-28 Use one ground. To be splitted at PCB.
    [detector.sch, lna.sch, modulator.sch, preamp.sch]
2020-04-29 Add BPF splitting calculations.
    [band-split.ods]
2020-05-01 Add BPF (Calculated according https://vpayaem.ru/information6_3.html).
    [band-split.ods, bpf.sch, dco.sch, detector.sch, lna.sch, modulator.sch, preamp.sch, sdr-trx.sch]
2020-05-09 Add RF power amplifier simulation.
2020-05-11 Update schematic according to latest simulation.
    [bpf.sch, detector.sch, lna.sch, modulator.sch, sdr-trx.sch]
2020-05-13 Add power amplifier schematic.
    [bpf.sch, dco.sch, detector.sch, lna.sch, modulator.sch, preamp.sch, pwr-amp.sch, sdr-trx.sch]
2020-05-16 Add LPF simulation.
    [band-split.ods]
2020-05-16 Update BPF.
    [bpf.sch]
2020-05-17 Add LPF schematic. Update BPF schematic.
    [bpf.sch, dco.sch, detector.sch, lna.sch, lpf.sch, modulator.sch, preamp.sch, pwr-amp.sch]
2020-05-17 Add simple RF power metrics calculator.
    [power.ods]
2020-05-18 Add SWR meter.
    [bpf.sch, dco.sch, detector.sch, lna.sch, lpf.sch, modulator.sch, preamp.sch, pwr-amp.sch]
2020-05-19 Update SWR meter.
    [power.ods, swr-meter.ods]
2020-05-20 Update SWR schematic. Add transformers detailes.
    [pwr-amp.sch, swr-meter.sch]
2020-05-24 Add audio codec.
    [bpf.sch, codec.sch, dco.sch, detector.sch, lna.sch, lpf.sch, modulator.sch, preamp.sch]
2020-05-31 Add MCU unit schematic.
    [bpf.sch, codec.sch, dco.sch, detector.sch, lna.sch, lpf.sch, mcu.sch, modulator.sch]
2020-06-04 Add PSU schematic.
    [batt.sch, bpf.sch, codec.sch, dco.sch, detector.sch, lna.sch, lpf.sch, mcu.sch]
2020-06-05 Add charge CS LPF.
    [batt.sch]
2020-06-05 Schematic annotation and ERC.
    [batt.sch, bpf.sch, codec.sch, dco.sch, detector.sch, lna.sch, lpf.sch, mcu.sch]
2020-06-05 Add missed datasheets.
    [batt.sch, bpf.sch, codec.sch, dco.sch, detector.sch, lna.sch, lpf.sch, mcu.sch]
2020-06-05 Load components into PCB.
    [sdr-trx.kicad_pcb]
2020-06-24 Route PCB.
    [batt.sch, codec.sch, mcu.sch, modulator.sch, psu.sch, pwr-amp.sch, sdr-trx.kicad_pcb]
2020-06-25 Generate PCB documentation.
    [sdr-trx.kicad_pcb, specification.ods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]
2020-06-25 Fix shield mask.
    [sdr-trx.kicad_pcb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]
2020-07-17 Extend specification (Add Digikey partnumbers). Minor schematic changes.
    [detector.sch, lpf.sch, modulator.sch, pwr-amp.sch, sdr-trx.kicad_pcb, specification.ods]
2020-07-17 Add digikey order list.
    [dk-order.xlsx, specification.ods]
2020-08-01 Add PCB v1.0 photos.
2020-08-27 Fix HW specification.
    [dk-order.xlsx, specification.ods]
2020-08-27 Initial FW commit.
    [jlink.cfg, stm32f4x.cfg]
2020-08-28 Fix openocd scripts.
    [jlink.cfg, stm32f4x.cfg]
2020-08-30 Extend LED functionality.
2020-08-31 Add board control unit.
2020-09-16 Project cleanup.
    [jlink.cfg, stm32f1x.cfg, stm32f4x.cfg]
2020-09-16 Add FW (UI unit, Critical errors handler, ...).
    [jlink.cfg, stm32f4x.cfg]
2020-09-21 Update RTC unit. - Add LSE failed widget. - Removed setting LSE high drive mode. Durung tests observed LSE startup time ~10S. There is no essential dependency on LSE drive mode.
    [main.c, widget_date_time.c, widget_date_time.h]
2020-09-21 Update hwctl unit (use HW SPI and its interrupt).
2020-09-24 ADC dummy implementation with its widget.
2020-09-25 Real ADC implementation.
    [swr-meter.ods]
2020-09-28 Add I2C master driver.
2020-09-28 Minor thread improvements.
2020-09-30 Add RF amplifier driver.
2020-10-02 Add NVRAM driver.
2020-10-05 Avoid code duplication: Introduce common notify widget.
    [critical_err.c, main.c, ui_notify.c, ui_notify.h, widget_date_time.c, widget_date_time.h, widget_main.c, widget_main.h]
2020-10-10 Provide errors from rf amplifier to UI.
    [rf_amp.c, rf_amp.h, widget_sensors.c]
2020-10-10 Fixed i2c one byte reception.
    [i2c_master.c]
2020-10-14 Replace NVRAM IC with FRAM FM24CL64. This brings huge increasing of write performance.
    [mem24_conf.h]
2020-10-29 Make pointer to codec adc buffer const.
2020-10-30 Add different sample rates for audio codec.
2020-11-01 Project cleanup: IRQ, DMA priorities, Makefile fix style target.
    [adc_conf.h, ft813_interrupt.c, ft813_qspi.c, hwctl.c, hwctl_conf.h, hwctl_os_dep.c, hwctl_os_dep.h, i2c_master.c]
2020-11-01 Use UI engine command RAM cache to prevent sending short QSPI transactions. Minor fix in trx widget.
    [ui_engine.c, widget_trx.c]
2020-11-01 Implement RTOS critical errors.
    [critical_err.c, critical_err.h, main.c, rtos_ext_base.c]
2020-11-01 Fix audio click when codec starts. Fix possible crash at realloc.
    [codec.c, codec.h, rtos_ext_base.c, wm8731_i2s.c, wm8731_i2s.h]
2020-11-07 Add power on/off functionality. Make possible shutdown during notification showing (long press power button). Add battery voltage shutdown and overheat protection.
    [adc.c, adc.h, adc_conf.h, critical_err.c, system.c, system.h, system_conf.h, task_system.c]
2020-11-07 Align buttons in power menu widget.
2020-11-11 Aggregate all RF unit parts into one file. Move all error notifications into one file.
    [app_data.c, app_data_types.h, widget_audio.c, widget_date_time.c, widget_errors.c, widget_errors.h]
2020-11-11 Add HW PTT button and common transceiver settings widget. Minor improvements.
2020-11-13 Use high level rf unit functions in sensors widget.
2020-11-14 Fix empty void function declaration f() - f(void).
    [codec.c, codec.h, widget_trx.c, wm8731_ctl.c, wm8731_ctl.h, wm8731_i2s.c]
2020-11-14 Use one IO buffer for audio codec. Create audio sample data type.
2020-11-14 Update CMSIS to version 5.7.0. Sources obtained from https://developer.arm.com/tools-and-software/embedded/cmsis.
2020-11-21 Remove no longer needed code to make SW structure more clear.
    [main.c, main.cpp]
2020-11-22 Add codec buffer size checker. Fix Makefile.
    [codec.c]
2020-11-22 Minor schematic fix.
    [modulator.sch]
2020-11-25 Fix setting frequency out of valid range.
    [widget_trx.c]
2020-11-26 Fix LSB USB cases.
    [main.cpp]
2020-12-08 Add SDR test process (generate single tone LSB at tuned frequency) to tune RF amplifier and antenna.
2020-12-08 Scale TX output signals to achieve desired transmit power.
2020-12-08 Fix negative SWR reporting. Since measurement circuit accuracy it's possible to have negative SWR value when measured Pr is little bit bigger than Pf actually they are the same.
    [adc.c]
2020-12-08 Add photos of assembled device.
2020-12-13 RF amplifier LDMOS bias voltage autobalance.
